AgrumeStly/yeye/control/firmware/README.md

# 旧目录：历史本机缓存

2026-10-25起，正式源码已按Core／App／Drivers_Custom／Drivers分层，Keil工程移至[MDK-ARM](../MDK-ARM/README.md)。当前入口查[主控README](../README.md)。

本目录保留原build、旧UART临时检查工程等本机历史产物，便于原测试记录继续溯源。它们不是当前可编辑源码或日常构建入口，不重新复制一份正式工程到这里。新输出在control/build/firmware。

这里的历史日志／备份没有被清理。迁移映射和验证见[ORG-02](../../project_planning/tasks/ORG-02.md)。
