AgrumeStly/yeye/hardware_preparation/wheel_mapping.md

# 当前轮位、编码器方向与安装变更

更新：2026-10-29（北京时间）。本轮由主控直接授权01更新全局及关联文档；硬件／02后续维护实物依据，00继续汇总协调。本页是**当前安装版本的轮侧／通道／方向入口**，不是新的MCU引脚表；GPIO及AF仍以[pin_plan.md](../control/docs/pin_plan.md)、[wiring.md](wiring.md)为准。

## 2026-10-30：直行测试的驱动对应与前进极性

主控本轮要求双轮快速前进1秒、慢速前进1秒，并明确反馈：**“左轮（先转的）朝车头、右轮（后转的）朝车尾”**。结合此前MotorPwm人工测试先A后B的顺序，本次按当前接线采用以下关系；这是主控现场方向反馈与测试顺序对应，没有新增代理实物测量。

| 驱动桥 | 当前轮侧 | 原MotorPwm极性下的反馈 | 本次StraightTest前进输出 |
| --- | --- | --- | --- |
| MOTOR-A（先转） | 左／物理新A | 朝车头 | IN1 PE9 PWM、IN2 PE11低 |
| MOTOR-B（后转） | 右／物理新B | 朝车尾 | IN1 PE13低、IN2 PE14 PWM，反转原测试极性 |

该补充替代下方10月29日记录中“当前驱动插口与轮侧待对应、带动力前进极性全未确认”的部分；**编码器软件a/b对应与符号仍待核，原CPR参考及机械换位历史保留**。本次独立工程只按桥配置开环输出，不采用未核的编码器方向，不外推为两轮同时前进、直行、反向PWM及停车已经验收。

固件与详细检查见[StraightTest](../control/docs/straight_test.md)及[C-02E](../project_planning/tasks/C-02E.md)。主控随后反馈小车拐弯、右轮偏快，当前程序已按新要求改为3秒恒定前进并预留左右PWM修正变量；方向配置不变。新版首次须悬空核对双轮前进及3秒后撤驱动，再进行地面直行观察。本次生成与编译不等于已经下载或新版实车通过；全局进度由00读取任务后汇总。

## 2026-10-29已确认的机械变化

来源为主控本轮明确反馈，原始语义及检查边界归档于[换位记录](../testing/2026-10-29_wheel_swap/record.md)：

- 左右轮位置已互换：原右轮位于当前左侧，原左轮位于当前右侧。
- 原右轮的旧“前进旋转方向”，在当前左侧对应车辆后退；当前左轮前进应取其相反方向。
- 原左轮的旧“前进旋转方向”，在当前右侧对应车辆后退；当前右轮前进应取其相反方向。
- 因此不能只改“左／右”名称继续沿用原通道方向系数；10月25日安装的轮侧／方向组合只保留为历史。

主控进一步明确：**“左轮为A右轮为B是我现在规定的。”** 因而本页从本次起使用**物理新A＝当前左轮、物理新B＝当前右轮**。这是主控重新命名，不是对驱动板插口或Keil变量的确认；不需要主控回忆旧插口，实际新安装的对应关系留给后续核对。

必须区分三种编号：

1. **物理新A／新B**：本轮主控定义，分别是当前左／右轮。
2. **驱动板MOTOR-A／MOTOR-B**：固定插口丝印，不随物理轮重新命名自动改变；AIN／BIN仍按驱动桥定义。
3. **软件a／b**：EncoderBench固定资源名，分别TIM3 PC6/PC7与TIM4 PB6/PB7。不能因为新左轮叫A就认定它必然读取软件a。

## 当前可用信息与采用门槛

| 项目 | 当前记录／边界 |
| --- | --- |
| 当前左轮／物理新A来源 | 原右轮总成；其旧前进方向现为后退，来自主控明确反馈 |
| 当前右轮／物理新B来源 | 原左轮总成；其旧前进方向现为后退，来自主控明确反馈 |
| 软件a与b的定义 | a始终是TIM3 PC6/PC7；b始终是TIM4 PB6/PB7。本轮未修改源码／引脚；各通道当前接哪只轮尚待插口确认 |
| 当前编码器前进系数 | 若各轮组编码器AB相序未改，由旧前进变新后退可推导新A前进正／暂定+1、新B前进负／暂定−1。**这是基于旧标定与安装关系的推导，未取得10月29日原始读数，不视为新安装实测**；实际软件通道对应后再确认，不把它直接写入固件 |
| 每输出轮圈计数CPR | 按原轮组身份转移：新A／当前左轮继承原右轮1058.6，新B／当前右轮继承原左轮1060.8 counts/圈。仍是10月25日手转5圈估计，不是10月29日重新测量；不作为固定软件a/b的固有参数 |
| 电机输出的前进极性 | 仍未完成带动力校准；不能用编码器符号或机械转向描述代替AIN/BIN电气前进极性实测 |
| 已有成功证据 | 原MotorPwm A/B分别起转／自动停转、EncoderBench采集与原安装手转证据保留；不据此宣称新安装的左右／电气极性／闭环已验收 |
| 当前固件与下载 | 本次不修改、不构建、不下载；原始a/b仍是硬件通道名，不随机械位置自动改名 |

当前安装表如下；参数只在本页维护，其他入口不复制一套表：

| 主控新物理名称 | 当前轮侧 | 换位前轮组身份 | 跟随原轮组的CPR参考 | 前进反馈推导（AB相序不变前提） | 当前驱动插口／软件通道 |
| --- | --- | --- | --- | --- | --- |
| 新A | 左 | 10月25日原右轮，历史软件b | 1058.6 counts/圈 | 原前进变现后退，故当前前进相反；暂定原始正／系数+1，待新安装读数对应 | MOTOR-A或MOTOR-B、软件a或b均待现场对应，**不因名称A写死** |
| 新B | 右 | 10月25日原左轮，历史软件a | 1060.8 counts/圈 | 同理暂定原始负／系数−1，待新安装读数对应 | 同上，**不因名称B写死** |

若六芯线仍接原插口且各相线未改，软件通道将随原轮组移动；若插口也互换，则软件通道按实际新接线变化。主控已说明旧接法不记得，因此不再据回忆猜配置。后续只须面向**当前安装**记录：单独手转新A时哪个软件通道变化、单独手转新B时哪个变化，再登记实际驱动插口；无须为命名澄清重做每侧5圈。

## 与后续任务的关系

[C-02C](../project_planning/tasks/C-02C.md)的10月25日标定原图与原始JSON保留当时安装含义，不回改历史数值。[C-02D](../project_planning/tasks/C-02D.md)尚未实施，本次只修订其安装输入：使用本页当前映射，分别保存物理新A/B、软件a/b与驱动插口的对应、反馈方向系数、轮组CPR和电机电气极性，避免多处重复取反。当前通道配对未确认前可准备接口和电脑模型，但相关实车配置留待确认，不放行新的有动力闭环；本次文档授权不等于C-02D已获实施或烧录授权。

不为本次文档变更重新要求重复多圈手转，也不把它当成新的台架试验授权。需要实物接续时沿用C-02D原有人工触发、输出和时长限制及看门狗／停止保护；后续具体校准由对应任务明确安排。

## 比赛依据、收益与检查范围

已读取[比赛原文PDF](../competition/比赛文档.pdf)第2—4页的相关要求及评分表，并查看[图1赛道](../competition/assets/track_figure_1.jpg)：要求自动顺时针完成环形车道一圈、总时长不超过5分钟，触碰黑色边界扣基础分、完全脱离车道失败；基础功能满分60分。转写入口为[比赛文档.md](../competition/比赛文档.md)，冲突时仍以PDF为准。

本次文档修订支撑上述完赛和用时目标：避免把旧左右轮和反馈符号带入差速／闭环，降低错误转向、触线、出界及反馈方向错误的风险。没有直接加分承诺或实测得分变化。队内文档检查指标是：当前入口不再无条件引用过期安装表，任务Prompt指向同一映射源，MCU针脚及固件文件保持原字节，历史原图／JSON不被改写；实际新安装行驶表现另行验证。
