AgrumeStly/yeye/docs/hardware.md

# 硬件型号、接线与版本入口

2026-10-29安装变更：主控已换左右轮并重新命名物理A左／B右，旧前进转向在新位置成为后退；当前资源到物理轮的对应及参数沿用统一见[当前轮位](../hardware_preparation/wheel_mapping.md)。新物理A/B不等同驱动插口MOTOR-A/B或编码器软件a/b；原始软件通道不随命名自动改动，当前实际配对待核。本次不改固件／引脚，不把旧安装的手转或桥级转停证据外推为新安装动力通过。

日期：2026-10-25（北京时间）。硬件提供资料，主控／02接收，01复核MCU资源。

| 内容 | 唯一维护入口 |
| --- | --- |
| 已确认器件型号、接线与供电 | [wiring.md](../hardware_preparation/wiring.md) |
| 当前现场操作及历史方案适用范围 | [硬件README](../hardware_preparation/README.md) |
| 照片、厂商资料和来源哈希 | [I-03证据](../hardware_preparation/evidence/2026-10-18_i03/README.md) |
| 实际电压与故障反馈 | [I-05记录](../testing/2026-10-21_motor_bench/i05_measurement_results.md)及关联测试 |
| 首次主板验证 | [board_self_test_record.md](../hardware_preparation/board_self_test_record.md) |
| 原采购型号／预算／分工 | 硬件目录PDF与source生成源；属于采购历史 |

实物清点表尚待硬件建立；主控已确认按既定清单采购，不因缺清点表将已知型号改成未知。型号、到货、接线确认、导通测量与运行通过分别记录。

ORG-02迁移当时没有改变硬件版本、接线、供电或UC2停用状态；2026-10-29左右轮安装变化及新物理命名以页首链接为准。本次未新增上电／试转结果，UC2停用状态不变。
