AgrumeStly/yeye/hardware_preparation/chassis_record.md

# 单层铝合金底板采购与装配依据

记录日期：2026-10-26（北京时间）。维护：硬件提供实物资料、02记录装配证据、00汇总状态。
依据：主控本轮明确反馈“已下单单层铝合金板，数据资料都在硬件准备中”。本页记录采购变化，不代替到货、尺寸或装车验收。

## 已确认与资料边界

- 当前底板选择：单层铝合金板，已下单；实际下单时刻、厚度、合金牌号、订单数量、到货日期和实重未从现有资料确认，不影响先准备布局。2026-10-26是反馈记录日期。
- 原采购方案中的FR4底板为历史方案；不再直接沿用其180×110 mm尺寸及原安装坐标。原采购PDF与生成源保留历史，不覆盖重生成。
- 主控提供的资料位于[size/](size/)。文件名虽写“亚克力”，实际订购材质按主控确认记为铝合金；现有文件不能独立证明卖家实际供货材质、厚度或铝板孔位与图纸完全一致。

| 来源 | 本轮读取与可用信息 |
| --- | --- |
| [孔位布局介绍](size/1-亚克力底板孔位布局介绍.pdf) | 12页，已渲染总览查看；包括四角电机支架孔、板卡孔、通用槽、加高支撑、电池扎带、万向轮等孔位。通用标注不等于现有板卡、支架适配通过 |
| [底板尺寸图](size/2-亚克力底板尺寸图.PDF) | 1页，已渲染查看；平面外形标注195×128 mm，孔径标注Φ3.50 mm，含多组安装孔与长槽；没有据此确认板厚 |
| [底板孔位介绍](size/3-亚克力底板孔位介绍.PDF) | 1页，已渲染查看；长度标194.79 mm、宽128 mm，与尺寸图195 mm的差异保留，实际板以实测为准；电机孔标支持370／520／TT／42步进电机支架，不据此推定MD310配套支架必然适配 |
| [万向轮固定孔照片](size/万向轮固定孔.png) | 已查看，标出4组可选万向轮固定位置及牛眼轮孔；选孔仍须结合现有万向轮孔距、支撑高度、驱动轮位置与转向间隙 |

图框重量数值不作为已购铝板实重，图中的板卡型号不作为本项目换板决定。

## 当前交接与待验项

02按[H-03](../project_planning/tasks/H-03.md)先准备布局和适配表；硬件负责实物比对、紧固与绝缘，视觉提供摄像头固定接口及视场需求，主控侧不接管视觉实现。电机与板卡继续沿用[接线基准](wiring.md)中已确认型号，成功接线及MotorPwm／EncoderBench不因换底板自行变更。

到货后记录：底板长宽厚与实重、支架孔距匹配、轮子与万向轮不干涉、电路板底部与金属板绝缘、线束不磨锐边或进入车轮、电池可靠固定、断电入口可接近、摄像头支架牢固。由硬件实际操作、02留证；当前均未验收。

比赛依据为[比赛要求和评分表](../competition/比赛文档.md)第三部分及其[赛道原图](../competition/assets/track_figure_1.jpg)：整车含突出件长≤300、宽≤200、高≤250 mm，总重含电池≤5 kg；底板尺寸不等于整车尺寸。轮子外侧、摄像头支架、插头和线束突出部分纳入包络测量，结合50 cm净宽与锐角弯检查转向占用。

本项支撑基本功能60分的完赛与用时表现，目标是减少松脱、干涉及触碰边界导致的扣分／失败风险；不能预测更换材质本身加分。验证证据应包括装配尺寸、称重、固定与绝缘检查照片，以及后续低速转弯／跑圈记录。装配检查属于队内验收，不代替官方评分。

## 本轮实际检查

00读取3份PDF共14页（12页孔位介绍查看渲染总览，两张尺寸／孔位总图单页查看）、1张万向轮照片和比赛赛道图；文字提取用于辅助核对，文件名和图中材料不能代替主控采购确认。未测量实物、重新设计加工、操作板卡或上传远端。
