AgrumeStly/yeye/hardware_preparation/charger_replacement.md

# UC2替代充电器建议

日期：2026-10-21。主控明确“不用UC2了”，停止将UC2作为后续充电方案；此前本体特别烫的具体原因未测定，不宣称已经确认器件损坏。当前为00选型建议，未采购、未到货、未验收，不自动下单。

## 电池依据与推荐

沿用已确认采购清单中的2S、7.4V、800mAh普通LiPo，主插头XT30，平衡插头JST-XH 3P。原采购内容源为[source/generate_purchase_list.py](source/generate_purchase_list.py)，不改写历史采购PDF／生成器以伪造已购替代品。

建议一款：天空创新SkyRC S65，型号SK-100152。官网列明AC100–240V直接输入、LiPo2–4S、充电电流0.1–6.0A可调、XT60输出接口、散热风扇及电池电压显示；这些参数适合本项目2S小容量电池。选择理由是可以设置较小电流、观察电池电压并直接接市电，不承诺机壳不发热或绝对安全。国内库存、成交价及具体店铺本次未核验，不编造价格。

官方依据（2026-10-21查阅）：
- [SkyRC S65中文产品页](https://www2.skyrc.com/cn/s65?from=nav)
- [SkyRC S65英文参数页](https://www1.skyrc.com/s65?from=nav)
- [厂家提供的S65 V2.10说明书下载](https://www.skyrc.com/files/201/S65_Instruction_Manual_EN_V2.10.pdf)

## 配套与初始设置建议

购买S65与中国插座适用的交流电源线，并让商家配一根“S65输出接口到电池XT30”的成品主充电线；连接器公母按实际金属触点匹配及红正黑负核对，不单凭商品标题判断。不要求主控焊接或剪改电池线。现有JST-XH3P平衡线需接充电器2S平衡接口，长度不足再配适用延长线；平衡充电需主线与平衡线均正确连接。

针对既定800mAh电池，建议首次设置LiPo Balance／2S（标称7.4V）、0.5A、终止4.20V每节即8.40V整包；0.5A约0.625C，仍不得超过电池标签允许的充电电流。普通LiPo不使用LiHV／4.35V设置，不修改截止电压提高充入量。到货后结合对应版本说明书做实际按键与插口核对，本文件不是自动充电指令。

充电时电池从车辆断开、在不燃表面有人看管。仅推荐更换充电器，不把换新当作电机无动作的修复；[I-05电气定位](i05_motor_power_diagnosis_task.md)仍待硬件借万用表测电池／驱动输入。

可转给商家的配线说明：电池为普通LiPo2S／7.4V／800mAh，主插头XT30、平衡头JST-XH3P；需要正版SkyRC S65、中国插座适用电源线和S65到该XT30电池的成品主充电线，支持主线与2S平衡线同时连接充电。
## 预算收紧后的候选：ToolkitRC C4

2026-10-21主控认为S65偏贵，要求更便宜的方案。预算候选改为ToolkitRC C4；仍未确认购买。厂家明确支持AC100–240V直接输入、LiPo2–4S，电流0.5／1／2／4A四档，可选择0.5A给既定800mAh电池充电；以LED显示进度，不将其当作有单节电压数值显示的设备。普通LiPo选择4.20V每节，不选LiHV。

主输出为XT60，需要配与现有XT30电池匹配的成品主充电线，并正确接2S平衡线。整机需带国内插座适用交流电源线。建议以约120–150元作为国内整机选购预算参考，并另外核对配线费用；此范围是选购预算估计，不是已核验的实时到手报价。国内导购检索有约113–140元记录，但打开页面时价格／所列商品发生变化，故不把导购记录当作可成交报价，也不推荐其异常低价或仅配件SKU。厂家海外商店整机标价25.99–26.79美元，仅作原币参考，不换算为国内报价。没有核验卖家库存或真实性。

厂家依据：[C4中文参数页](https://www.toolkitrc.com/zh-hans/c4/)、[官方中文说明书](https://download.toolkitrc.com/wp-content/uploads/2024/09/C4-%E4%BD%BF%E7%94%A8%E6%89%8B%E5%86%8C-V1.0.pdf)、[厂家海外商店](https://www.toolkitrc.com/product-category/charger/)。

更便宜但固定／最低电流过大的型号不直接套用：UC2已停用；厂家已标e3停产且最大1.2A，C3未证实能由主控选择0.5A，不能仅因价格低就认定适合本次小容量电池。以上不是对器件质量的断言。I-05故障诊断范围不变，不自动上传或下单。
