AgrumeStly/yeye/hardware_preparation/i03_handoff.md

# I-03 返回00与01的交接

状态：v0.2，00已验收资料整理、归档主控采购型号确认；实物接线及引脚待签核。日期：2026-10-18（北京时间）。负责角色／对话：主控／02；验收回填：00。依据：主控I-03指令及[接线核对](wiring.md)。

2026-10-20续接：01已完成C-02A，00采用其资源并回填wiring v0.3。下文资源确认要求保留为历史交接；当前接法见[首次接线指南](dual_motor_wiring_guide.md)及[引脚方案](../control/docs/pin_plan.md)，不重复开工或沿用旧PA0/PA1候选。主控本次要求先断电接线、回报后再编码。

## 返回00的事实

- 已建立[逐线接线草案](wiring.md)，覆盖两只电机各6线、四路桥控制、四路编码器输入、共地、供电及UART/SWD保留条件。当前没有任何现装连线被实物验证通过。
- 照片P1可读YB-MNT03-V1.0，布局符合亚博AT8236 Standard；P2可读电机端M2/V/A/B/G/M1；官方接线图确认AO1→M1、AO2→M2、GND→G、3V3→V、E1B→B、E1A→A，B桥对应E2B/E2A。
- [照片及来源索引](evidence/2026-10-18_i03/README.md)保存原始照片副本、SHA256、原附件路径和厂家PDF。P3为天空星背面，不能据此确认MCU顶标；已插线束另一端不可见。
- 厂家芯片手册区分00滑行/休眠、11刹车；0/3.3V控制在资料门限内。编码器电平是预期值，未测量；驱动Vin标5–12V，5V/3V3是不同输出，Vout不能当5V入口使用。
- 型号已由主控确认按清单采购：MD310Z20_7.4V、AT8236 Standard／YB-MNT03-V1.0、天空星STM32F407VET6青春版。后续直接采用此基准，不再要求主控重复识别；照片未拍到铭牌不等于型号未知。
- 缺项归硬件：两端线束与导通表、左右轮对应、电池极性、供电拓扑与测量、下载器端口说明。01先查既定型号资料；仅当具体PCB版本差异影响连接时，补核对应位置，不把补齐全部器件照片作为资源设计前提。
- 未决项归01：四个桥输入的PWM/GPIO分配、编码器定时器保留、UART/SWD物理位置与冲突、停车模式及默认态；01完成后由硬件核实实际排针位置，02更新接线版本。
- 本次仅文件与照片核对；无改线、通断/电压测量、烧录、上电或电机运行。没有实车/台架测试通过结论。

00验收结论（2026-10-18）：I-03“照片与资料整理”验收通过；“实物接线冻结/可上电”继续待验收。C-02A资源分配可立即按既定型号开展，无需等待硬件导通或补拍铭牌；C-02实际驱动测试仍依赖H-02和01接口确认。

## 可由主控转交01的资源确认要求

```text
任务关联：I-03 → C-02前置资源确认
目标对话／角色：01 主控固件开发／主控
依据：hardware_preparation/wiring.md、hardware_preparation/i03_handoff.md、control/docs/pin_plan.md、control/Drivers_Custom/Board/board.h、control/Drivers_Custom/Board/board.c。

目标：确认F407驱动AT8236双桥及读取双AB相编码器所需的资源分配；本段是交接要求，不表示任务已自动发送或已开工。后续具体可改范围与授权由00给出执行Prompt。

要求：
1. AIN1/AIN2/BIN1/BIN2共4路3.3V控制线。优先评估4硬件PWM；若采用2PWM+2GPIO，解释两方向的PWM极性、占空比和停车状态，不直接照搬F103教程的PA6/PA7/PB0/PB1。
2. 双AB相编码器4输入。现PA0/PA1→TIM2 CH1/2、PB6/PB7→TIM4 CH1/2仍为候选；编码器计数定时器与PWM时基资源不得冲突。
3. 保留或明确处理USART2 PA2/PA3、SWD PA13/PA14和既有板级资源；驱动ADC不接PA2。U1R/U1T不能替代USART2或SWD。
4. 每线返回MCU端口、AF、TIM/CH、引出连接器及物理针号、板载占用。照片看不清的位置保持待核对，不猜针号。
5. 明确HSI 16MHz起点下的PWM时钟、频率、模式、限幅、复位/高阻默认态、STOP/FAULT滑行或刹车、换向顺序和台架超时退出。00/11是芯片滑行/刹车定义，不是车轮已停稳。
6. 与硬件明确驱动A/B桥和车辆左右轮的对应，提出编码器符号及前进方向的后续验证步骤。

返回证据：资源分配表、复用与板级依据、冲突处理、待硬件确认项、下一步代码/台架条件。最终引脚确认后由01更新pin_plan.md，02引用同一接线版本。
边界：本次I-03没有授权01自动上电、烧录或驱动电机；没有授权上传、切分支或跨聊天自动消息。
```

## 硬件复核返回格式

| 必填项 | 要求 |
| --- | --- |
| 器件身份 | 沿用主控确认的原采购型号；只记录具体替换、与清单不符或影响接线的PCB差异；线束及下载器信息按接口需要补齐 |
| 每根线 | 对照wiring.md线号，写两端接口/针脚、插头朝向、通断实测、核对角色和日期 |
| 供电 | 各正负端、共地、开关、Vout与Vin关系、USB和DAP隔离方案；本次不要求带电测量 |
| 差异 | 预期与实物差异、照片、影响范围、负责角色、改线后复查条件 |
| 后续测量 | 另行任务确认后，再补稳压输出、编码器高低电平、带载掉压等真实数值 |

## 后续测试前置与版本

先完成硬件断电核对和01资源签核；再按00明确任务逐级测供电/逻辑接口、悬空单轮/双轮转停、编码器和闭环。先测电气输出停止，再记录车轮实际停稳；断连恢复不能自动重启。记录进入testing/带日期目录。

开始版本：D:/Projects/yeye，main，82640aba4cf7aa4f30db14b486aef852936118fe；开始时工作区干净。I-03新增资料及状态更新为本地未提交改动，精确文件清单以02最终回报为准；本次未提交、推送、创建PR、切分支或向其它聊天发消息。
