AgrumeStly/yeye/hardware_preparation/motor_dc_check.md

# A电机独立直流起转检查

2026-10-24补充：主控暂时无法去实验室，当前可先用[MotorDirect固定GPIO短时试转](../control/docs/motor_direct.md)，原接线、无需PWM。该方法仍经过驱动板，失败不能独立判定电机损坏；本页的脱离驱动限流电源方法留待设备具备。

状态：v1.0，操作方案，未实测。日期：2026-10-24（北京时间）。主控／01整理；主控在实验室人员协助下操作，实际结果交主控／02归档。

主控本轮要求先用最简单、不用PWM的方法让电机起转。本轮采用**A电机完全脱离主控与驱动，使用实验室可调限流直流电源短时供电**的方法；无需改程序、编译、下载或使用示波器。实验室是否有合适电源尚未确认，本文件不代表已接电或起转通过。原示波器方案保留，待独立电机结果后再安排。

## 电源参数与依据

[亚博MD310官方资料的310 Motor段](https://www.yahboom.net/study/MD310/14018/)给出MD310Z20_7.4V额定／推荐7.4V、推荐供电范围4.2–8.4V、额定电流≤0.65A、堵转电流≤1.4A；不重新识别已确认的型号。堵转值不表示允许持续堵转。

本次工程诊断初值：**输出7.4V，电流限制先设1.0A，一次接通约0.5–1s后关输出**。限流值和时长是本次保守诊断选择，不是厂家起转保证或新的整车参数。若启动瞬间限流，记录实际情况；若持续CC限流、掉压且不转，立即关输出，不自行加电流或延长时间，不能因此单独判定电机坏。

该方法是额定直流供电，已不同于原30%PWM。**完全脱离主控后，KEY、固件500ms超时和看门狗均不能关断电机；停止只能靠电源OUTPUT开关。** 操作人员必须能立即关输出，本轮不采用手持裸线碰接锂电池来代替开关。若实验室没有可调限流电源／可靠夹具，先返回设备条件，不用主板GPIO或电源针临时代替。

## 操作：先全断电，后只接两个动力端

1. 驱动OFF、拔XT30电池、DAPLink USB及主板Type-C，UC2保持断开。固定A电机／车架，轮子悬空，导线远离转轴。
2. 标记原接线，将**A电机六芯线在驱动端的六根线全部拔开**，电机端插头保持接好。M1／M2辨认以电机PCB丝印及[已确认逐线功能表](motor_wiring_self_check.md)为准，不凭通用线色或“从上第几根”猜测。剩余编码器V、G、A、B四根分别绝缘、悬空，既不接电源，也不再接两块板。
3. 请实验室人员在电源**OUTPUT关闭**时设置7.4V、电流限制1.0A，核对显示单位及限流设置；接好合适的绝缘夹具，输出仍保持OFF。

   | 直流电源端 | 仅接A电机哪根线 |
   | --- | --- |
   | ＋ | M1，原来接驱动AO1的动力线 |
   | − | M2，原来接驱动AO2的动力线 |

   电源负端这里接M2，**不接编码器G**；7.4V不接编码器V。M1／M2也不接PE9、主板3V3／5V或驱动Vin。此处电机已独立，不需要额外与主板／驱动共地；不在驱动仍连着电机时外加这一路电源。
4. 一名现场人员负责OUTPUT按钮，另一人可观察／录像。只打开一次输出，约0.5–1s立即关闭；若完全不转、只抖动、持续CC／电压明显下跌或有异常，提前关闭。不靠手持带电线插拔启停，也不带电换极性。
5. 确认电源输出已关，再拆电源夹具；保持电池与主板供电断开。回报结果后再按原标记及接线表恢复，不顺手把两板接电重新试转。

## 结果与解释

主控回报：**是否转动／仅抖动／无动作；输出开启时实际电压、电流及CV／CC状态**，能录像则同时保留电机与电源显示。设定7.4V不等于带载输出已达到7.4V，限流1.0A也不等于实际流过1.0A。

- 能转：说明本次电机与这段线束能在受控直流条件下起转；原故障仍需在控制信号、驱动及供电组合中定位，不能直接据此判定固件或驱动哪一个坏。
- 不转且持续CC／掉压：可能受限流、机械负载或其他电气条件影响，先停；没有满足电压条件不能直接判电机坏。
- 电机端有额定附近电压但无动作：保存实际电压／电流，后续定点检查绕组、换向器、线束与机械；不自动加功率或反复堵转。

测试结果仍待主控提供。代理本轮只查厂家资料及准备说明，没有改固件、烧录、操作电源、电池或电机、上传或跨聊天发送。
