AgrumeStly/yeye/project_planning/project_status.md

# 当前状态与任务

最后核对：2026-10-29（北京时间，01按主控本轮明确授权更新左右轮换位／新物理命名及旧标定适用范围；其余进度保留00原记录）。
汇总：00项目总指挥。本次轮位变更由01依主控“更新全局文档”的明确授权顺序回填，不接替00身份；没有重新编译、操作板卡或确认新安装试转。10-25已核对控制模块及现场记录；10-26按主控反馈读取底板资料和比赛相关要求，登记新采购与装配依赖。00没有重新编译、烧录或试车。ORG-02构建／模型为原迁移证据，PWM重写与实物结果分别按模块记录核对。
维护方法见[协作标准](collaboration_standard.md)；整理前完整流水见[历史快照](archive/2026-10-25_project_status_snapshot.md)。

## 1. 当前判断与接续

主控工程、电脑模型、首次板级自检及两马达分别PWM起转／自动停转已有证据；C-02B-PWM-R4人工验收完成。编码器采集已实现，00已核对采用10月25日原安装的初版手转标定；10月29日主控已交换左右轮并重新规定物理A=左、B=右，旧左右／通道组合不再作为当前配置，见[当前轮位入口](../hardware_preparation/wheel_mapping.md)；速度闭环尚未实现，带动力电机极性、AB同时运行、串口实物互通及整车跑圈仍未验收。主控已确认视觉能采图、尚未发送结果包；正式程序尚未在本仓库归档，图像特征提取与语音能力未在本轮确认。原W1／W2目标不能按日期视为完成。

ORG-01已完成协作资料落地；主控随后明确授权ORG-02，将STM32物理分层放在control内，工程迁至MDK-ARM。协议、接线、原图与实物测试目录仍原位保留。现有00、01、02、03继续职责，清晰模块任务可直接进入01／02。当前完整接续见[ORG-02](tasks/ORG-02.md)，结构和统一入口见[docs](../docs/README.md)。

当前可复现基线为[MotorPwm独立工程](../control/MDK-ARM/motor_pwm.uvprojx)，目标MotorPwm，预期版本0x020B0004、1kHz／50%／500ms；A/B分步起转、自动停转和灯态已由主控确认。[C-02C](tasks/C-02C.md)已完成软件及初版手转标定交付；下一项为[C-02D统一双轮运动接口与低速闭环台架](tasks/C-02D.md)，任务已准备、尚未实现，保留已通过MotorPwm与EncoderBench。

### 最近的推进顺序

1. [C-02C](tasks/C-02C.md)原安装交付仍保留；10月29日已机械换位，主控新定义A=当前左、B=当前右，旧前进旋转方向现为对应新轮的后退。[wheel_mapping.md](../hardware_preparation/wheel_mapping.md)维护当前关系，物理新A/B不等同驱动MOTOR-A/B或软件a/b。C-02D须先按当前安装对应通道，再绑定随原轮组转移的CPR及前进系数；不重复旧多圈标定，不擅改固件。
2. C-02D先区分编码器符号与电机输出极性，准备受限单轮校准／低速闭环，再由02组织双轮并转、停止及供电回归。初次仍50%以内、500ms人工触发；只有实际台架证据回来才验收闭环，不把旧演示request直接当RPM／PWM。
3. 视觉同步按[V-01](tasks/V-01.md)交已有板上程序、实拍路径与串口样例；主控／视觉共同确认现有20字节协议，02组织固定包与START／STOP／失线／超时实物互通，再进入低速地面循迹。视觉与语音具体实现归视觉，硬件准备归硬件。

硬件可同步准备轮侧／前进方向标记、稳定悬空支架、线束固定与练习赛道；同一checkout的代码写入、Keil保存／构建与板卡动作顺序进行。以上为依赖顺序，未重新承诺原11/01跑圈期限。报名已由主控明确确认完成且有成功凭据，见[报名状态](../competition/registration_status.md)，不再列为待提交阻塞；原截止记录保留。

10-26新增：主控确认已下单单层铝合金底板，资料已在硬件准备目录；[采购与图纸记录](../hardware_preparation/chassis_record.md)区分订购材质、图纸尺寸与待实测项。02可按[H-03](tasks/H-03.md)准备布局，硬件后续负责适配、固定和绝缘；未确认到货、装车或整车尺寸通过。此项与01运动接口／闭环、视觉结果包并行准备，不改变已有控制验收结论。

10月29日安装变化已按主控反馈记录：新A是当前左轮、新B是当前右轮，仅为重新规定的物理名称；不能据名字认定实际MOTOR-A/B插口或软件a/b。原右轮旧前进方向现在是左轮后退，原左轮旧前进方向现在是右轮后退。CPR参考随原轮组转移，方向若按原AB相序推导须明确“未重新实测”，通道与实际极性后续核对；详见[当前唯一映射](../hardware_preparation/wheel_mapping.md)和[原始反馈记录](../testing/2026-10-29_wheel_swap/record.md)。本次避免把过期左右/符号用于差速及闭环，支撑比赛基本完赛、减少触线／出界风险，没有实测加分结论。

## 2. 当前模块摘要

| 范围 | 已有证据 | 验证边界与下一步 |
| --- | --- | --- |
| 型号与到货 | 主控10-18确认按清单采购、10-20确认硬件到齐；MD310Z20_7.4V、AT8236 Standard／YB-MNT03-V1.0、天空星F407VET6青春版沿用[接线基准](../hardware_preparation/wiring.md) | 型号已知，逐项电气验收仍需证据；不重复索要型号 |
| 底板与结构 | 主控10-26确认单层铝合金底板已下单；[底板记录](../hardware_preparation/chassis_record.md)已核对3份PDF及万向轮照片，图纸约195×128 mm | 新采购不在10-20原硬件到齐范围内；到货、厚度、支架孔距适配、整车包络／重量及绝缘固定待验；02按[H-03](tasks/H-03.md)准备布局 |
| 主控软件 | [主控入口](../control/README.md)、[ORG-02](tasks/ORG-02.md)有迁移构建／模型／二进制等价证据；随后[PWM重写](tasks/C-02B-PWM-R4.md)及独立MotorPwm编译／模型通过 | 当前分层与成功PWM复用；HardwareBench仍是UART／状态机框架，运动请求未接真实闭环；00本轮未重跑构建 |
| 板级自检与启动 | [首次双闪／读回](../hardware_preparation/board_self_test_record.md)；R1后主控回报绿灯恢复，[原现场记录](../testing/2026-10-20_motor_bench/acceptance_record.md)保留 | 原不闪症状已恢复；独立上电及完整ms／fault／stage读数未齐，不再当成尚无任何恢复证据 |
| 电机基础驱动 | [Direct A/B](../testing/2026-10-25_motor_direct/acceptance_record.md)及[MotorPwm A/B](../testing/2026-10-25_motor_pwm/acceptance_record.md)分别起转成功；主控本轮再次确认两马达能转，PWM自动停转与灯态已验收 | 现版1kHz／50%／500ms；未单独提供Watch版本／波形／精确计时；AB同时运行、反转与闭环另验；旧失败不改写 |
| 供电／接线／测量 | 既定DAPLink主板供电、2S驱动供电及九线沿用；[I-05](../testing/2026-10-21_motor_bench/i05_measurement_results.md)已有静态读数，现版A/B已起转 | 历史持续版读数原位保留；完整导通／内部VM／动态波形仍未全测，不再把旧无动作作为本轮开发阻塞。编码器供电与信号按C-02C实际核对 |
| 协议／UART | [20字节结果包](../control/docs/protocol_v1_draft.md)主控实现；UART默认关闭 | 协议仍草案，待主控／视觉共同确认及真实互通；语音动作反馈未实现 |
| 编码器与闭环 | [C-02C](tasks/C-02C.md)软件及10月25日原安装手转交付保留；10月29日已换位，新物理A左／B右，旧左右/通道参数不再直接套用 | [当前轮位／命名／参数沿用](../hardware_preparation/wheel_mapping.md)为现行入口；当前通道对应及推导方向仍待核，参数未写固件，C-02D先处理安装映射和电机极性，再进入低速闭环 |
| 视觉与语音 | 主控2026-10-25确认已经能采图、尚未发送结果包；实际脚本／环境／样本待归档 | 下一项[V-01](tasks/V-01.md)：复用采图，先固定协议包发送，再接真实特征；语音／路径提取进度未确认，不由主控接管实现 |
| 整车与报告 | [测试入口](../testing/README.md)已有下载、板内和台架诊断；[报告目录](../report/README.md)只有说明 | 尚无整车跑圈、故障停车验收和正式报告 |

UC2已按主控决定停用，替代充电器仅为[历史建议](../hardware_preparation/charger_replacement.md)，没有已购买／到货／实测证据。旧采购和接线教程里的UC2操作不作为当前操作入口。

## 3. 有效任务与依赖

表内状态表示该任务实际层次，不能用软件交付代替实物验收。历史任务详细要求沿用原文件，新跨轮任务按[tasks/README.md](tasks/README.md)建立。

| ID／既有名称 | 主责／对话 | 当前状态与差距 | 证据与下一步 |
| --- | --- | --- | --- |
| ORG-01 | 体系整理对话交付，00接收 | 待验收：文档体系本地落地，实际使用效果待主控反馈 | [任务与完整交接](tasks/ORG-01.md)；00读文件接续 |
| ORG-02 | 体系整理对话交付，01后续维护、00接收 | 待验收：主控物理分层、路径适配、构建／模型／固件等价检查完成；人工Keil体验待主控 | [迁移与当前完整交接](tasks/ORG-02.md)，以后打开control/MDK-ARM工程 |
| P-01 | 主控汇总／00；正式报名由正式队长 | 报名已由主控确认完成且有凭据；三方完整交付与重估排期继续跟踪 | [报名状态](../competition/registration_status.md)、本页节点与[原计划](project_plan.md)；凭据附件本轮未查看，不将其记为待报名 |
| H-01 | 硬件，00跟踪 | 待核实：实物清点表尚未建立 | 预期`hardware_preparation/hardware_inventory.md`，采购／保管／验收分别记录 |
| H-02 | 硬件提供、02接收、01复核资源 | 进行中：资料已有、完整实物签核待补 | [wiring.md](../hardware_preparation/wiring.md)，沿用现有型号 |
| H-03 | 02准备布局、硬件负责实物、视觉提供安装输入 | 未开始：单层铝合金底板已下单，00已核对资料并准备完整Prompt；未确认到货／装车 | [任务与完整Prompt](tasks/H-03.md)、[底板记录](../hardware_preparation/chassis_record.md)；先资料适配，再到货验证，不阻塞C-02D |
| C-01 | 主控／01 | 待核实：HardwareBench真实运行、复位后零请求 | 不能由DFU双闪或诊断目标替代 |
| V-01 | 视觉实现，00协调，02接收 | 已知能采图、尚未发结果包；本次归档／发送任务Prompt已更新，待主控转交 | [完整任务与Prompt](tasks/V-01.md)；先固定包验证串口，再接真实路径特征，不等待主控闭环 |
| I-01 | 主控／02，视觉共同确认 | 待核实：协议冻结与跨板固定包、START、STOP、无效／超时无归档验收 | 依赖H-02与视觉交付；[协议入口](../control/docs/protocol_v1_draft.md) |
| C-02／C-02B | 主控／01实现、02复测 | 进行中：A/B分步PWM转停与双编码器初版手转标定已交付；动力闭环与AB并转仍未验收 | [PWM](tasks/C-02B-PWM-R4.md)、[编码器](tasks/C-02C.md)；接续[C-02D](tasks/C-02D.md)运动接口／低速闭环 |
| C-02B-PWM-R4 | 主控／01实现，主控实物验收，00接收 | 完成：软件交付及A/B分步PWM起转、自动停转／灯态／收尾人工验收 | [任务](tasks/C-02B-PWM-R4.md)、[现场记录](../testing/2026-10-25_motor_pwm/acceptance_record.md)；不外推AB并转、反转、CPR或闭环 |
| C-02C | 主控／01实现，主控手转，00核对 | 完成：软件及10月25日原安装初版手转交付；10月29日轮组换位另记，不改写旧验收 | [任务与原采用记录](tasks/C-02C.md)、[旧实物记录](../testing/2026-10-25_encoder/acceptance_record.md)、[当前安装变更](../hardware_preparation/wheel_mapping.md)；旧数值按轮组身份继承，不认定新安装已实测 |
| C-02D | 01实现、主控人工台架、02联调 | 未开始：10月29日仅修订安装输入，未授权本轮启动实现；物理新A/B与驱动／软件通道须分别对应 | [修订后的任务与Prompt](tasks/C-02D.md)引用[当前轮位](../hardware_preparation/wheel_mapping.md)，不沿用旧左a/右b参数；原限幅／人工停止保护与唯一协议保留 |
| MotorDirect（原10-24任务名称） | 主控／01，主控手动验证 | 已取得A/B分别起转正常的主控反馈，A有约500ms自动停转；细项以原记录为准 | [Direct记录](../testing/2026-10-25_motor_direct/acceptance_record.md)；保留对照入口，不再作为当前未起转阻塞 |
| I-04 | 主控／硬件、02留证 | 进行中：接线已由主控确认、供电已有反馈；完整导通和运行签核未齐 | 不再把“待机不闪”列为当前未修复症状；[接线入口](../hardware_preparation/README.md) |
| I-05 | 02组织、硬件测量、01按证据修复 | 历史定位记录保留：已有静态电压与持续版数据；旧失败根因未单独确证，现版A/B已转，不再优先重复故障定位 | [测量记录](../testing/2026-10-21_motor_bench/i05_measurement_results.md)；编码器／后续并转若出现新供电异常再按证据补测 |
| G-02 | 主控／03 | 完成证据已取得；本轮只读核对本地合并，不代替主控体验验收；笔记本待确认 | [版本交接补记](version_handoff.md)；远端实时状态本轮未联网复核 |
| G-04 | 主控／03交付，00核对本地基线 | 已有上传正式版本及台式机接续记录；00本轮实查本地分支／HEAD／正式标签一致，未联网重核远端 | [G-04](tasks/G-04.md)；codex/current-version-20261025，HEAD及formal-2026-10-25均0b0343577895d8eb03a337165da6ce9c5e433519；本轮新文档仅本地 |

### 保留的历史交付

- I-03：资料整理已由00接受，真实线束／电气签核另属I-04；[交接](../hardware_preparation/i03_handoff.md)。
- C-02A：资源方案已采用并回填接线；[资源表](../control/docs/pin_plan.md)，实物冻结另验。
- C-02B-R1：软件修复及绿灯恢复有证据，完整自主启动复验未齐；[R1记录](../control/docs/motor_bench_startup_issue.md)。
- C-02B-R2：软件交付已接受，单次A无动作；[R2记录](../control/docs/motor_bench_r2_task.md)。
- C-02B-R3：软件交付已接受，已有板内活动／停止快照，外部起转未通过；[R3记录](../control/docs/motor_bench_r3_task.md)。
- 持续A测试：旧版有配对Watch和测量反馈，未转；[原说明](../control/docs/motor_continuous.md)与证据保留。现版A/B分步PWM成功不能单独确定旧失败根因。
- G-01：上传任务分支及00核对有证据；G-02随后合入本地main，[版本记录](version_handoff.md)。
- 原D-01～D-10问题、授权与现场流水完整保存在[状态快照](archive/2026-10-25_project_status_snapshot.md)，未删除历史失败或改写原测试日期。

## 4. 日期与当前风险

以下均为本地原通知／原计划记载，日期使用2026年北京时间，尚无本轮赛事群新通知；主控已确认报名完成且有凭据，本轮未查看原始附件。

| 节点 | 原日期 | 目前判断 |
| --- | --- | --- |
| W1基础链路 | 10/18 | 完整验收未齐 |
| 内部报名检查 | 10/23 | 10/25主控已确认报名完成并有凭据；不倒填10/23完成或正式队长身份 |
| 官方报名截止 | 10/25 23:59 | 主控已确认报名完成且有凭据，记录见[报名状态](../competition/registration_status.md)；本轮未查看附件 |
| W2闭环与通信 | 10/25 | 完整链路无验收证据 |
| 连续3次低速整圈 | 11/01 | 队内原目标，未归档试跑 |
| 候选版与报告终稿 | 11/29 | 原计划目标，需按真实进展重估 |
| 现场验收 | 暂定12/05 | 以正式后续通知为准 |

## 5. 待修订与维护

本轮新增组织改善、原技术缺陷、环境问题分别登记在[审查记录](organization_review.md)。优先关注旧技术页“待实测”与已有证据的衔接、接线教程供电口径、换设备调试模板；这些均没有在本轮被算作修复完成。

00收到新结果时更新关联摘要和任务行；现场详情写原测试记录或新增带日期记录。新增重大决定写入相应任务单并链接受影响规范。原计划没有重新承诺新工期，主控体验没有自动验收。
