AgrumeStly/yeye/project_planning/tasks/C-02D.md

# C-02D：统一双轮运动接口与低速闭环台架

2026-10-30专项接续：主控本轮已直接要求复用采集代码使两轮同速，独立实现及软件结果记录在[C-02F](C-02F.md)、[SpeedMatch](../../control/docs/speed_match.md)。已提供两次人工单轮500ms配对／符号识别及双轮默认3秒同目标PI调试，3秒沿用主控当前直行测试时长；未自动操作硬件。原采集、PWM及旧目标保留。C-02F不替代本任务的通用motion API、正式整合及实物验收要求，不能据专项软件完成宣称本任务整体完成；以下原任务日期与授权历史保留。

日期：2026-10-25（北京时间）。主状态：未开始；2026-10-29由01依主控授权修订安装输入，本轮不启动实现。01实现，主控人工操作，02接收台架与后续串口联调，硬件协助轮向和固定；视觉只维护自己的采图／路径发送及语音实现。生成Prompt不代表已发送或自动开工。

## 已确认事实和本次决定

主控要求下一步封装电机运动调用接口，已明确不是按钮界面。00此前核对的[C-02C](C-02C.md)及[实物记录](../../testing/2026-10-25_encoder/acceptance_record.md)属于10月25日原安装；**10月29日已交换左右轮，旧左右/软件通道组合不再直接作为本任务输入。** 主控新定义物理A=当前左、B=当前右，这不是驱动MOTOR-A/B或软件a/b的确认。当前映射及轮组CPR沿用统一查[wheel_mapping.md](../../hardware_preparation/wheel_mapping.md)：旧前进转向在新轮侧成为后退，CPR随原轮组转移，软件通道配对及新前进读数尚待核。方向推导不是实测，参数仍是旧手转5圈估计且未写入固件；不得套厂家CPR、平均左右或把名称直接写成通道。原交付不外推为新安装动力闭环通过。

既有MotorPwm的1kHz／50%／500ms、A/B分别起转与停转已获主控确认，独立EncoderBench为10ms采样、原始16位计数／64位累计及窗口状态。保持这两个可复现入口和此前全部目标。

重要缺口：手转确定的编码器方向，不等于PWM正输出的车辆前进方向。电机驱动输出的轮侧极性、带动力编码器符号、AB同时动作、PID增益与闭环表现未验。当前car_tick给出的left_request／right_request是演示归一化请求，board_apply_requests只更新Watch，不可直接当RPM或PWM接到新电机实现。

## 目标和Interface

建立一个非阻塞双轮运动Module，隐藏PWM、编码器符号／换算、控制周期、输出限幅和停止处理。第一版先提供STM32内部Interface，不新增一套视觉指令协议。建议Interface（目前尚未实现，01可按现有命名规范落地并记录真实声明）：

- 初始化／周期执行：motion_init及motion_tick，初始化零输出，周期不阻塞，单位与调用上下文明确。
- 目标：motion_set_wheel_rpm(left_rpm,right_rpm,now_ms)，接受左右轮目标RPM并返回是否接受及拒绝原因；不是占空比、距离或转角承诺。第一阶段用户运动目标仅前进与前进差速，不开放倒车／原地反向动作。
- 停止：motion_stop(reason)，立即撤去驱动、清目标与积分，保留实际反馈和停止原因；00滑行不等于机械瞬时停稳。
- 状态：motion_get_status，包含目标／实际RPM、输出、采样有效性、运行／停止／故障状态和原因。此为STM32内部读取，不代表现有UART已有状态回包。

具体函数类型、并发／时序约束、有限值检查、参数范围和错误语义写到真实头文件及模块说明，不散布到视觉调用者。避免为未来需求搭空模块或重复包装；运动流程、轮速控制和已存在硬件适配分别保有清晰职责。

## 实现和分阶段验收

1. 先读AGENTS、默认技能、协作标准、tasks/README、本任务、docs/architecture.md、docs/interfaces.md、control/README.md、standard_library.md、pin_plan.md、encoder_bench.md、motor_pwm.md和C-02C实际源及证据。保留SPL／CMSIS边界、HSI时钟、TIM5启动限时、IWDG、KEY及SWD，TIM1电机、TIM3／TIM4编码器资源不改。
2. 纯轮速控制数学放control/Algorithms/PID/或相应真实算法目录；硬件PWM／编码器适配放Drivers_Custom；运动状态、请求及保护放App/Motion；调度与入口放Core。优先新增独立MotionBench和工程，不把当前HardwareBench默认为可驱动车辆，不覆盖已验收诊断目标。
3. 先按当前wheel_mapping.md完成物理新A/B、驱动插口及软件a/b配对，再使用跟随原轮组的分别CPR和经确认的前进系数将反馈统一为正，不按旧a/b顺序直接套参数；按实际有效dt计算RPM；计数状态／flags异常时不得把无效值填0后继续积分。明确滤波／积分／导数的单位与延迟，提供输出限幅、积分限幅或抗饱和、停机清积分、故障锁定和启动拒绝条件。PID／PI选择给出理由，不能用“设置目标RPM”冒充已经达到该转速。
4. PWM初版沿用已通过的1kHz基线，新受控台架输出上限不超过50%。电机极性配置与编码器系数分开保存，不能用重复取反掩盖接错或方向错误。首次需短时逐轮校准输出极性：车辆前进时归一化反馈应为正。未标定前不启用双轮闭环，不自行写死A/B的电气正输出就是车辆前进。
5. 正负电气输出／换向的实现须查既定AT8236真值表；校准若确需改变电气方向，先停止、待停稳，受限单次人工触发，不直接切反向或删除保护。第一版外部速度目标仍拒绝负值并说明错误，不能静默取绝对值。
6. 新台架上电不动，KEY（实物丝印，对应WKUP）人工一次触发，初次有动力窗口沿用500ms并锁定，故障／KEY可立即撤驱动。控制实现非阻塞，不能用delay等待转动或把0.5秒窗口延长到几秒来方便观察。闭环调参若确需更长窗口，先记录当前反馈／输出及不足，由主控明确采用后另记录变更，不自动延长。
7. 初始只逐轮验证符号与短时反馈，再决定低速目标及PI/PID增益。未知增益、静态误差和调参结果都如实标待验；仅完成软件／模型不能宣称闭环稳定。AB并转与停止要在两轮各自方向／反馈正常后由02安排；本轮不直接地面试车。
8. 必须有指令有效期／更新超时、编码器无效或断反馈、异常dt／控制任务停滞及非正常请求的停止策略；值、依据和检测局限明确记录。外层car协议200ms失联／STOP优先／有效路径START条件原样保留，不因封装改变；本次不把它们与新的台架超时混成同一个测试结论。已锁定故障不能靠后续正常请求自动续跑。
9. 编写详细中文注释，完成受影响构建与真实逻辑测试：目标／实际量纲、符号、限幅、积分饱和、停止、故障、超时、dt／回绕及不会上电自启；模型与实际台架分开。保持MotorPwm与EncoderBench源码和行为；若确需共享代码提取，须证明原行为保留并回归，不将新闭环算法塞入旧诊断。

## 视觉怎样调用与接入门槛

视觉在K230D上，不能直接调用STM32的C函数。继续使用唯一[20字节协议](../../control/docs/protocol_v1_draft.md)：视觉侧封装send_path(...)、start()、stop()等发送函数；STM32接收／状态机决定是否启动，再调用运动Module。START依赖新鲜有效路径，不会因多包装一层就免除；现有STATUS仅解析，没有回包，不能承诺视觉可获取motion_get_status结果。

本次01先完成本地运动模块和独立台架，给出car到运动目标的后续映射方案，不直接改旧演示request的单位或冻结新的转向算法，也不新增FORWARD／LEFT／RIGHT命令号。V-01由视觉实现发送器；02在闭环台架准备充分且协议共同确认后组织无动力固定包联调，再受控接通真实运动。若需要新增轮速指令／反馈，先回00确认协议范围，不修改既有字段含义。

## 交付、位置和授权

- 实际头文件／实现、独立工程、control/docs/motion_control.md，更新真实API索引及模块说明。
- testing/2026-10-25_motion/的电脑证据及待填现场记录；纯Keil5＋已确认DAPLink步骤、最少Watch、先校准后单轮／双轮的门槛，退出／停止方法。
- 本任务回写：文件、版本、构建／测试／产物、已用初版参数、尚未确定的极性与增益、实际台架结果、未完成项及一个下一步；全局摘要由00顺序汇总。

当前00目录D:/Projects/yeye，分支codex/current-version-20261025，HEAD 0b0343577895d8eb03a337165da6ce9c5e433519。C-02C与00文档均有本地未提交内容，只有该HEAD／正式标签不能获取新编码器代码；必须保留并使用已有C-02C文件，另一设备缺源码先形成完整文件交接，不从旧基线重造或擅自上传。

00本轮仅准备任务；主控转交01后允许按以上范围本地实现、保存和适用检查、准备人工步骤，不授权代理自动烧录／接电／驱动车辆／跨聊天／提交上传／切分支。同一checkout的写入、Keil保存／构建和硬件操作顺序进行。01不争写全局project_status.md。

## 可直接转交01的完整Prompt

本对话继续01主控固件开发，执行C-02D：统一双轮运动接口与低速闭环台架。先读取AGENTS、默认技能、协作标准、任务模板、project_planning/tasks/C-02D.md、架构／API索引、主控README、standard_library、pin_plan、MotorPwm与EncoderBench及C-02C证据。

当前目录D:/Projects/yeye，分支codex/current-version-20261025，基线HEAD 0b0343577895d8eb03a337165da6ce9c5e433519；C-02C和00文档有未提交成果，另一设备仅取该HEAD没有新代码，先核对来源并保留共享修改。不要回到旧firmware工程或切分支。

10月29日当前安装已变化：主控交换左右轮，并重新规定物理A=当前左、物理B=当前右；原右轮旧前进方向现为左轮后退，原左轮旧前进方向现为右轮后退。**旧C-02C的“左a/右b”不能直接作为当前配置；物理新A/B、驱动MOTOR-A/B、软件a/b三种编号必须区分。** 先读hardware_preparation/wheel_mapping.md，按当前实际通道配对绑定随原轮组转移的CPR及经确认前进符号；推导值不冒充新实测，配对未确认不放行有动力闭环。不要求回忆旧插口或重做多圈CPR。MotorPwm A/B 1kHz／50%／500ms原桥级转停证据保留，SPL、启动限时／IWDG和KEY停止不改；新安装的电机电气前进极性另验。

建立非阻塞运动Module，提供初始化／周期执行、左右目标RPM、停止和状态／反馈Interface；具体命名可用motion_init、motion_tick、motion_set_wheel_rpm、motion_stop、motion_get_status。Algorithms放纯轮速PI/PID，Drivers_Custom放硬件适配，App/Motion放请求与保护，Core与MDK-ARM提供独立MotionBench。真实dt／CPR／符号、输出和积分限幅、异常反馈／超时停止、故障锁定与停机清积分必须明确。第一版目标只前进差速，负目标拒绝；不承诺距离或转角动作。

电机输出极性不能由手转编码器符号推定，先准备逐轮短时校准再闭环。首次台架KEY人工触发，窗口仍500ms、输出不超过50%，不自动延长／爬升或运行双轮；未知极性和增益如实留待人工确认。两轮各自正常后再给02双轮并转／停止验收步骤；不直接地面运行。保留已通过MotorPwm、EncoderBench和其它目标。

视觉继续走唯一20字节协议，其send_path/start/stop发送函数归视觉。保留START有效路径条件、STOP优先及200ms超时；不要把car.c演示request当RPM/PWM接通，也不新增另一套前进／转向字节命令。本次先台架和内部Interface，真实UART接运动待02分阶段联调，STATUS回包尚未实现不能伪称支持。

交付实际源码／独立工程、motion_control.md、纯Keil教程、最少Watch和待填实物表，完成受影响构建及有意义的符号、单位、限幅／积分、故障、超时和启动／停止检查。软件与实物分开，结果回写同一C-02D及模块证据，00汇总全局。只本地保存验证，不自动操作板卡／驱动／发送聊天／提交上传或切分支。
## 2026-10-29输入修订及本次授权

主控本轮只授权01更新全局与关联文档；这不表示已转交或开始C-02D实现。当前安装以[wheel_mapping.md](../../hardware_preparation/wheel_mapping.md)为唯一来源，旧标定原图／JSON保留，任务Prompt中的安装输入同步修订。软件、Keil项目／配置、PID参数、电机输出和设备均未操作。后续实施须按当前安装重新核对实际通道与前进电气极性，不能通过重复取反掩盖配对问题。规则及预期收益／检查指标见映射页，本次不虚构得分或新试转通过。
