AgrumeStly/yeye/project_planning/tasks/C-02F.md

# C-02F：复用编码器的双轮同速调试程序

日期：2026-10-30（北京时间）。主状态：待验收（软件交付完成，实车未验）。责任：主控／01实现与记录，主控人工操作，02接收现场证据，00汇总全局。

## 需求、已知事实和授权

主控先反馈右轮偏快，要求3秒直行及偏移调参；随后说明反复拔插DAPLink很麻烦，询问实时测速方案，本轮明确要求“复用之前的采集代码，写一个程序调好两轮速度，最终目标是两轮速度一样”。中断后主控要求继续同一任务。

沿用当前驱动A左／B右及前进极性；保留主控已将旧StraightTest修正值改为12的源码，不回改。编码器软件a/b与当前轮侧仍未取得新原始对应，不能套用旧安装顺序。当前轮组CPR继承值、方向及历史范围以[轮位入口](../../hardware_preparation/wheel_mapping.md)为准。

本轮实现独立SpeedMatch：逐轮500ms／≤50%人工校准反馈通道与符号，再允许双轮跟踪共同RPM；默认共同目标60、单次3秒，延续主控本轮直行调试时长，未延长逐轮首次校准500ms。正常结束后等待停稳及重新长按松开可重复，故障不自动续跑。此为C-02D中的轮速闭环专项，不表示通用motion API、整车循迹或UART整合已完成。

授权限于本地实现、适用检查、构建和操作说明。未自动烧录、接电、运行电机、提交、上传或跨聊天发送。实车“调好”仍依赖主控返回新实测数据；没有把默认PI或电脑模型当实物标定。

## 比赛对应与验收

已读取比赛第三部分相关要求、赛道及评分表。基本功能60分要求自动顺时针一圈、5分钟以内，触边扣分、完全出界失败。轮速反馈与独立闭环用于减少动力差导致的跑偏，支撑完赛率、少触边及合理提速；没有官方“同速加分”或实测分数承诺。

软件验收：原采集代码复用；识别映射后才能双轮；RPM真实dt与分别CPR；PI各自调节、0..50%限幅和积分抗饱和；KEY／异常／无反馈／反向／超速／采样失效停车；正常重复需人工，启动锁定配置和时限；Watch实时值及停车结果保留。软件与实物验收分开。

实物初验（队内指标，非官方规则）：两轮各自目标误差与两轮差值均≤5RPM、连续至少500ms，正常撤驱动；逐轮转向、通道／符号、左右PWM与供电状态须留证。原CPR为历史手转参考，有误差；同RPM不保证轮径相同或地面一定走直，地面表现另验。

## 本地交付及证据

- [SpeedMatch独立工程](../../control/MDK-ARM/speed_match.uvprojx)，版本`0x020F0001`；Core入口`speed_match_main.c`。
- `control/Algorithms/Speed/speed_pi.c/h`为纯PI数学；`control/App/Motion/speed_match.c/h`负责逐轮校准、请求、状态与安全；原`encoder_hw`、`encoder_counter`和`straight_pwm`适配文件复用且本轮不改。
- [模块说明](../../control/docs/speed_match.md)集中记录参数、单位、时序、停止语义、故障表、Keil Watch、重复调参及待实测要求。本机uvoptx沿用CMSIS-DAP／SWD／1MHz，预填Watch和周期刷新，受Git忽略；换电脑须核对实际设置。
- ARMCC5.06u5零错误零警告，Code9272／RO424／RW132／ZI1252；BIN SHA-256 `e247d769752ca35d3c269aab4243d06433a769df045426573cbab29ca1dc54a7`。构建工具及日志位置见模块说明。
- 真实PI＋原计数算法＋状态机模型通过两种映射、动力不一致、回绕、限幅与积分、校准、500ms／3秒边界、正常重复、参数锁定、结果保留及故障场景。虚拟电机2.5秒时62.83／63.94RPM属于模型结果，不能写成实车测速。
- 全调用链集成模型3场景110项通过，覆盖真实Core、PWM、encoder_hw、数学和控制；核对逐轮／双轮GPIO与CCR、3秒撤驱动、KEY、读失败和MOE丢失。没有真实电压、波形、机械转速或运动验收。
- 原StraightTest、EncoderBench、MotorPwm和六目标工程保留。未声称重新构建所有旧目标，未改既有协议及HardwareBench运动请求单位。

## 下一步与接续

主控按模块说明下载SpeedMatch，先悬空两次独立长按松KEY，确认左右轮分别朝车头且各500ms撤驱动；第三次双轮3秒后读取左右RPM、difference、last_matched_ms、PWM、error及录像。若有偏差，以该实测返回继续调PI或检查反馈／负载；默认增益不作实车稳定性保证。正常重复测试可保持DAPLink连接，复位会重新校准并恢复配置初值。

目录`D:/projects/projectsyeye`，来源HEAD `9520eeb481169f88146afe541b4d53617c7728eb`，分支`codex/current-version-20261025`。本轮开始已有C-02E固件／文档、新板记录及`control/docs/validation.md`、`testing/README.md`等共享修改，全部保留；本轮没有接替00或改写全局`project_status.md`。00可读取本任务和模块证据后顺序汇总。
