AgrumeStly/yeye/project_planning/tasks/G-06.md

# G-06：当前全部项目成果上传与台式机接续

日期：2026-10-31（北京时间）。负责范围：主控授权的版本同步与设备交接。
依据：主控要求“将所有内容更新github，方便台式上拉取”。

## 来源与本次授权

实际检查设备`JokeBearDesktop`，目录`D:/projects/projectsyeye`，分支`codex/current-version-20261025`，开始HEAD为`9520eeb481169f88146afe541b4d53617c7728eb`。`git fetch origin`成功，随后核对本地与同名远端领先0、落后0。origin为`https://github.com/AgrumeStly/yeye.git`。

提交并上传全部当前非忽略项目成果：C-02E直行测试、C-02F轮速闭环、纯PI算法、驱动适配、独立Keil工程、电脑测试与构建工具、新主板烧录／电机复测记录，以及已有模块、映射、接口和任务文档改动。保存原有内容，不改业务逻辑；补充本任务与版本交接入口。

本次沿用现有任务分支，不合并main、不移动正式标签、不发布、不操作目标电脑或板卡。编译输出、tmp、本机uvoptx／uvguix／DebugConfig沿用忽略规则留在本地；账号与工具安装不会通过Git同步。

## 验证与证据边界

- 2026-10-31实际重跑`control/tools/run_straight_tests.ps1`：状态机测试通过；集成模型7场景90项检查通过。
- 同日实际重跑`control/tools/run_speed_match_tests.ps1`：真实PI、编码器与状态机模型通过；全调用链集成模型3场景110项检查通过。模型映射0／1的62.83／63.94 RPM仅为电脑模型数据。
- 原固件构建及实物证据分别见[C-02E](C-02E.md)、[C-02F](C-02F.md)和[新板记录](../../testing/2026-10-30_new_board_flash/record.md)。本轮未重新构建ARM固件或验证实物，电脑模型通过不代表实车直行、闭环或整圈通过。
- 测试日志位于被忽略的`control/build/straight_test_tests.log`、`straight_integration_tests.log`、`speed_match_tests.log`、`speed_match_integration_tests.log`。测试脚本和用例随本次源码提交，台式机可重新运行。
- 提交前检查暂存文件清单、差异格式及常见凭据模式，提交后推送并以`git ls-remote`对照完整HEAD；实际结果以本轮最终回报为准，不为在文件中写入自身提交号重复提交。
- 36份暂存文件未匹配所查常见凭据模式。仅清理`straight_test.c`一处空白行尾空格，未改参数或逻辑；新板两份原始Keil日志自带的行尾空格按证据原字节保留，排除这两份日志后的暂存差异格式检查通过。

本次支持比赛第三部分基本功能60分项的开发连续性，避免台式机漏拿代码或误用旧轮位，降低后续完赛／触线风险；没有新增实测比赛分数。比赛规则以[原PDF](../../competition/比赛文档.pdf)和[全文转写](../../competition/比赛文档.md)为准。

## 台式机接续

主控在台式机实际仓库目录执行，历史目录为`D:/Projects/yeye`。先检查目录、远端与工作区；已有未提交修改先保存，不覆盖：

```powershell
git remote -v
git status --short --branch
git fetch origin
git switch codex/current-version-20261025
git pull --ff-only origin codex/current-version-20261025
git rev-parse HEAD
git status --short --branch
```

HEAD须与本轮最终回报相同；如果不能快进，保留现场核对本地独有提交。不直接拉取旧main。若尚无本地同名分支，用`git switch --track -c codex/current-version-20261025 origin/codex/current-version-20261025`代替switch／pull。

接续先读[主控入口](../../control/README.md)、[当前轮位](../../hardware_preparation/wheel_mapping.md)、C-02E／C-02F及对应模块说明。SpeedMatch工程为`control/MDK-ARM/speed_match.uvprojx`，StraightTest工程为`control/MDK-ARM/straight_test.uvprojx`。本机调试设置受忽略，台式机须按[SpeedMatch操作说明](../../control/docs/speed_match.md)核对Keil5、ARMCC5、芯片包、CMSIS-DAP／SWD／1MHz、Flash算法与Watch变量；拉取成功不能证明下载器或板卡配置一致。

台式机实际拉取结果本轮尚未核验。全局进展由00读取模块任务与原始证据后顺序更新。
