AgrumeStly/yeye/project_planning/tasks/C-02C.md

# C-02C：双编码器采集与轮侧、计数方向标定

日期：2026-10-25（北京时间）。主状态：完成（软件与初版手转标定交付经00核对采用；动力闭环／计量精度不在本次通过范围）；主控已在01转交并授权本地实现和验证。主控／01实现；硬件协助编码器供电、轮侧与机械标记；02接收现场记录；00汇总验收。代理不操作板卡。

> 2026-10-29安装变更：本任务10月25日标定及00采用记录属于**原安装历史**。主控已换左右轮并重新规定物理A左／B右，当前通道／方向／CPR沿用查[wheel_mapping.md](../../hardware_preparation/wheel_mapping.md)；不改写本任务旧图与原始JSON，不把原“左a、右b”照搬为当前配置。

## 已确认事实与待实测

- 主控在本轮00再次确认“马达都能转了”。[C-02B-PWM-R4](C-02B-PWM-R4.md)及[2026-10-25现场记录](../../testing/2026-10-25_motor_pwm/acceptance_record.md)已有主控对A/B分别PWM起转、自动停转、阶段灯态与收尾的完整流程确认；无需重复证明已认可部分。
- 当前可复现基线：control/MDK-ARM/motor_pwm.uvprojx，MotorPwm，预期revision 0x020B0004，1kHz／50%／500ms。旧R3、持续A无动作保留为各自历史，旧根因未单独定位，不再阻塞本次编码器开发。
- 仍未实测：AB同时动作、正反向／左右轮对应、编码器脉冲与每输出轴圈计数、速度闭环、串口实物互通、地面跑圈。视觉正式程序未在本仓库归档，不等于视觉尚未开发。
- 已有硬件：天空星STM32F407VET6青春版、AT8236 Standard／YB-MNT03-V1.0、MD310Z20_7.4V双电机；沿用既定九线及DAPLink单源主板供电、独立2S供驱动。UC2已停用，不把充电器选型作为本任务前置。
- 资源已经确定：E1A/E1B→PC6/PC7、TIM3 CH1/CH2、AF2；E2A/E2B→PB6/PB7、TIM4 CH1/CH2、AF2。TIM1保留电机，TIM5保留已有启动限时等待，PA0留KEY（对应WKUP），USART2 PA2/PA3与SWD保留。A/B桥不是已知左右轮，实际对应待现场登记。

## 目标、修改范围及交付

先建立可靠的双编码器计数与标定入口，不直接加入PID或循迹。

1. 读取AGENTS、默认技能、协作标准、状态、本任务、docs/architecture.md、control/README.md、control/docs/standard_library.md、pin_plan.md、motor_pwm.md及既有按键／初始化保护实现。
2. 在control/Drivers_Custom/Encoder/新增双AB相编码器适配，使用现有SPL TIM3／TIM4编码器模式；说明解码倍频、输入滤波、上拉／下拉依据和计数位宽。不得直接把“13线×减速比×4”写成已测轮侧CPR。
3. 采样采用明确的固定周期调度（优先10ms，实际实现须注明周期／单位与时间来源），提供原始16位CNT、有符号窗口增量、累计计数、实际dt及采集／错误状态。正确处理正反向、16位回绕、初次采样和异常间隔；说明累计值范围及溢出处理。轮侧CPR未标定前只报counts及counts/s，不能输出貌似已标定的RPM或m/s。
4. 优先增加独立EncoderBench入口、Core/Src应用及MDK-ARM工程，以Keil Watch读取，避免覆盖已验收MotorPwm。若选择已有适合的独立入口，说明理由并保持原目标行为。首次只手转轮，电机四输入始终保持零；编码器供电需按既有驱动3V3／GND实际拓扑准备，不能把驱动OFF导致未供电误判为编码器故障。
5. 保留现有SPL、全部六目标和Direct A/B、MotorPwm独立入口、时钟／启动限时、必要看门狗与故障保护。不占用TIM1／TIM5或串口，不修改已通过PWM驱动、频率／占空比／时长，不顺手接入HardwareBench整车运动请求。
6. 必要数学换算若值得独立模块，遵循Algorithms纯算法边界；本次无需提前搭建PID／tracking空壳。应用代码详细中文注释，解释单位、计数符号、初始化／中断和边界处理。
7. 更新control/docs/encoder_bench.md、适用模块导航／软件验证记录，并准备testing/2026-10-25_encoder/acceptance_record.md待填表；任务结果回写本文件，不由01同时修改全局project_status.md。

## 验证与现场门槛

- 软件：编译新增及受影响目标，电脑检查真实增量／时间换算逻辑，覆盖正反向、正反回绕、静止、初次采样、异常dt与两路独立性；既有未变目标用适当兼容检查保留，避免反复重测无关模块。只镜像宏值的测试不计有效证据。
- 人工入口必须是当前Keil5图形界面＋已确认DAPLink，给出工程、唯一目标、Rebuild、Flash Download、Verify OK、F5／Periodic Window Update及最少可复制Watch字段。代理不自动连接或烧录。
- 首次实物仅只读计数：电机输出禁止，按既有方案给编码器供电；分别手转每只输出轮正／反向，检查对应计数变化及另一通道独立。无编码器供电或管脚数字证据时，先记录缺口，不直接判坏。
- 轮侧／方向：主控与硬件按实际安装登记A/B对应左／右、车辆前进的轮转方向及原始计数符号。以输出轮或输出轴完整一圈为单位做重复标定（建议每侧3次），保存每次真实计数、转圈方法及一致性，不把电机轴圈数当车轮圈数，不为通过而随意改符号。
- 本轮先不增加动力试转、不在动力输出时暂停CPU；若需要以已通过MotorPwm短脉冲补充“电机A↔编码器A”配对，应在初次手转数据回来后由00／02明确安排，仍使用现有受控停止。
- 完成范围分开报告：软件交付、手转采集、CPR／方向标定。未实测填写待验，不因编译通过宣称轮速可用；AB并转、PID和地面运行不在本任务验收内。

## 本次授权与接续位置

00目前只生成任务及Prompt。主控转交01后，允许01在上述范围本地实现、保存与电脑检查，准备人工步骤；不授权代理自动操作板卡、驱动电机、跨聊天发送、提交／推送、发布或切分支。共享checkout的写入、Keil保存／构建及硬件操作必须顺序进行。

00实查目录D:/Projects/yeye，分支codex/current-version-20261025，HEAD 0b0343577895d8eb03a337165da6ce9c5e433519；本地标签formal-2026-10-25指向同一HEAD。开工前已有project_planning/version_handoff.md本地修改，须原样保留；00本轮还会修改状态／导航并新增任务，01须重新列出当前修改，不能按旧“干净工作区”覆盖。历史笔记本交接目录D:/projects/projectsyeye不是本机现用目录，不据其文本改动本机路径。

结果回写本任务：实际改动、版本与产物、构建／有意义测试、已确认硬件事实、待填实物表、可复制Watch及下一步。00读文件后顺序汇总全局状态。

## 可直接转交01的完整Prompt

本对话继续承担01主控固件开发，执行C-02C双编码器采集与轮侧、方向标定。项目D:/Projects/yeye，分支codex/current-version-20261025，来源完整HEAD 0b0343577895d8eb03a337165da6ce9c5e433519；正式标签formal-2026-10-25为同一基线。先核对实际目录／分支／HEAD和共享未提交修改，保留version_handoff.md及00本轮文档，不切分支，不覆盖Keil配置。

先读AGENTS.md、.agent/skill/grill-me/SKILL.md、project_planning/collaboration_standard.md、project_status.md、tasks/README.md、本任务project_planning/tasks/C-02C.md，以及docs/architecture.md、control/README.md、control/docs/standard_library.md、pin_plan.md、motor_pwm.md和本次PWM验收记录。新源码使用Core／App／Drivers_Custom／Algorithms／Tests／MDK-ARM分层，不恢复旧firmware/src，不迁HAL。

主控已确认两马达Direct正常，且MotorPwm A/B分别起转、约500ms自动停转与灯态完整流程符合预期；保持MotorPwm独立入口、0x020B0004、1kHz／50%／500ms及保护，不重复旧故障排查，不要求重认型号或重插已确认接线。当前没有编码器读取与闭环实现，AB同时动作、轮侧／方向和CPR待实测。

实现TIM3 PC6/PC7 AF2与TIM4 PB6/PB7 AF2双编码器读取，提供原始CNT、有符号增量／累计计数、dt、采样状态，处理回绕／首样／异常间隔；CPR未标定前不要伪造RPM。TIM1电机、TIM5启动等待、PA0 KEY、UART和SWD保留。优先独立EncoderBench图形下载入口，首次电机输出始终零，仅按既有供电方案给编码器上电、手转轮采集。新增驱动放Drivers_Custom/Encoder，应用／入口按现有层次放置，保留六目标及Direct A/B、MotorPwm独立工程，不改已验收PWM或引入PID。

给出详细中文注释，完成受影响目标构建及有意义的增量／时间／回绕检查；新增control/docs/encoder_bench.md和testing/2026-10-25_encoder/acceptance_record.md待填表。人工操作只用Keil5和既有DAPLink，明确入口、动作、预期、Watch及供电条件。验收先静止／两路手转正反向与独立性，再由主控／硬件按每输出轮完整一圈重复标定CPR及左右／前进符号；真实数据未回报保持待验。

仅本地实现、文档及电脑验证，不自动烧录／驱动／跨聊天／上传或切分支。共享写入、Keil保存／构建顺序进行；执行结果与证据写回同一C-02C任务及模块记录，全局状态留00汇总。交回版本、文件、构建／测试、产物、最少Watch清单、纯Keil步骤与待验收项。
## 00本轮准备与检查边界

00核对了正式基线的源码、模块说明和主控现场回报；重写PWM的4份应用／驱动／状态机源文件与已归档软件清单SHA256一致。当前motor_pwm.uvprojx能解析XML、相对本地HEAD无Git差异，但原始SHA256与旧构建清单不一致，原因未在本轮追溯，不把工程字节完全一致列为通过。00没有改工程、重跑编译或板卡；01新任务构建前按实际工程／编译器配置核对，不为匹配旧哈希覆盖已认可正式版本。

若01在另一台设备继续：使用该设备既有yeye Clone和实际路径，记录来源分支／完整HEAD／本地差异。00本轮任务与摘要尚未上传，不能假定新文件已在另一设备。主控应转交本任务的完整Prompt；缺任务文件时可按完整Prompt在对应project_planning/tasks/C-02C.md建立同一任务，不创建第二个ID、不为获取文件擅自覆盖或切回旧main。涉及固件改动接续仅在核对正式基线与保留本地成果后进行。

## 01执行结果（2026-10-25，北京时间）

### 软件交付与实际文件

主控在本对话直接授权后实施；未把任务文件或00回报当成烧录授权。实际Clone为D:/Projects/yeye，分支codex/current-version-20261025，完整HEAD仍为0b0343577895d8eb03a337165da6ce9c5e433519；正式标签经^{commit}解引用后相同，原rev-parse标签对象ID不是提交不一致。开工已有control/README、根docs导航／架构、硬件导航、全局状态、version_handoff和任务草案改动；本轮只在授权模块及本任务落笔，未覆盖其它对话成果、切分支或修改全局摘要。

新增：

- [Core/Src/encoder_bench_main.c](../../control/Core/Src/encoder_bench_main.c)：独立初始化／异常零电机、R1及1ms滴答／10ms采样。
- [App/Diagnostics/encoder_bench.c](../../control/App/Diagnostics/encoder_bench.c)、encoder_bench.h：两路采样对象及Watch发布。
- [Drivers_Custom/Encoder/encoder_hw.c](../../control/Drivers_Custom/Encoder/encoder_hw.c)、encoder_hw.h：TIM3／TIM4 SPL四倍频和实际CNT／数字电平读取。
- [Algorithms/Encoder/encoder_counter.c](../../control/Algorithms/Encoder/encoder_counter.c)、encoder_counter.h：有符号模差、64位饱和累计、dt与counts/s、首样／丢窗状态。
- [MDK-ARM/encoder_bench.uvprojx](../../control/MDK-ARM/encoder_bench.uvprojx)：独立唯一EncoderBench；新本机encoder_bench.uvoptx克隆原已验证CMSIS-DAP设置和最少Watch，被Git忽略，未覆盖其它配置。
- [test_encoder_counter.c](../../control/Tests/Host/test_encoder_counter.c)、[test_encoder_bench.c](../../control/Tests/Host/test_encoder_bench.c)、fakes/encoder/stm32f4xx.h；[run_encoder_tests.ps1](../../control/tools/run_encoder_tests.ps1)、[build_encoder_bench.ps1](../../control/tools/build_encoder_bench.ps1)。
- [encoder_bench.md](../../control/docs/encoder_bench.md)、[待填验收表](../../testing/2026-10-25_encoder/acceptance_record.md)、[软件证据](../../testing/2026-10-25_encoder/software/README.md)。

修改既有文件限于Core/Inc/stm32f4xx_conf.h的独立目标条件，control/README及Core／App／Drivers_Custom／Algorithms／Tests／MDK-ARM模块导航、standard_library.md、pin_plan.md实施补充和validation.md。原所有应用／驱动.c及其余.h、全部既有工程和本机配置与开工快照一致；新源不编入旧六目标。没有更改已验收PWM源、频率、占空比、时限、人工触发或停止保护。

实现选择：保留原始a/b符号，不猜左右／前进；两路16位CNT独立，10ms名义调度，实际dt参与速率；异常dt或半量程差丢弃、重新建基线并锁存连续性缺失。64位累计溢出饱和且冻结。没有RPM／m/s、CPR常量、PID或新的动力测试。完整状态、范围及观测限制统一在encoder_bench.md，不复制第二份参数规范。

### 构建、电脑检查及产物

- 新EncoderBench 0错误0警告，Code4500／RO424／RW60／ZI1236；原六目标、独立MotorPwm及MotorDirectB共8个既有目标兼容构建均0错误0警告。Direct A独立文件字节保留，同源MotorDirect已构建，不重复无关构建。
- 新计数算法8022次断言，其中2000段独立已知双路轨迹；真实入口／App／SPL适配模型12场景241898次断言（含等待循环）通过。覆盖首样、正反、两方向及时间回绕、异常dt、负数换算、累计饱和、两路独立、R1等待故障、读失败、SysTick失败和始终零电机。
- R1六初始化函数名称映射后可执行代码相同；原.c/.h除条件头外、既有Keil／uvoptx与开工哈希相同，16份官方来源一致。实际AXF无PWM启用／CCR更新或电机SetBits调用；源文件／日志与文档最终核对见[checks.json](../../testing/2026-10-25_encoder/software/checks.json)。
- MotorPwm与MotorBench BIN仍为ea10fb83a5497c40c346ee6005073562dade79b013fcc8c6a5f6ec4d49d65a33，Continuous与Direct A BIN匹配各自记录。原已通过软件模型未改变，未重复跑旧电机／协议模型，不声称本轮再次物理试转。
- 新revision 0x020C0001；产物control/build/firmware/encoder_bench/encoder_bench.axf／hex／bin，本机忽略缓存。BIN4984字节、SHA256 e5587b20177dde0119215350b6b59f4e21d4820a3541945588a7a2e2ee5ea7f8；其余哈希见模块产物表／checks.json。

### 现场结果和主控操作入口

初次软件交付时尚无新板级数据；之后收到的首圈实物图见本任务末尾最新记录。已确认的Direct A/B与MotorPwm A/B起转、自动停转继续采信，但不证明编码器供电或计数。前进符号／最终CPR尚未冻结；AB同时动作、闭环和地面运行不在范围。

主控按encoder_bench.md纯Keil5步骤：全断电分离四根M1/M2电机动力线并绝缘，编码器V/G/A/B与九线保留；XT30拔开先打开独立工程、Rebuild、CMSIS-DAP SWD 1MHz、手动Flash Download并Verify，确认0x020C0001、ms增长、fault0、watchdog_stage4、motor_odr0。再按既有驱动3V3拓扑给编码器供电，F5持续Run／Periodic Window Update，先静止、再分别手转双轮正反，之后每侧3次输出轮完整一圈并记录原始起终点及flags。这里接驱动供电仅服务编码器，电机M1/M2仍断开；无供电或CNT不变不能直接判编码器坏。

最少Watch六行：g_encoder_bench_revision、g_encoder_bench_ms、g_encoder_bench_fault、g_encoder_bench_watchdog_stage、g_encoder_bench_motor_odr、g_encoder_bench（展开a／b）。所有手转／标定数据填原验收表；静止两次刷新累计一致才抄值，普通Watch不是原子快照；暂停、复位、flags非0使该次CPR作废。

### 接续与00读取

软件交付完成，主状态待验收；唯一下一步是主控／硬件按待填表做无动力手转与每侧三次整圈标定，交00读取本任务。实测返回后再确认方向系数与CPR，不擅自改符号、加PID或借旧PWM补动力测试。00可据本文件顺序更新全局状态及架构／API导航中旧“编码器未实现”摘要。

全部本地保存，有本轮及开工未提交／未上传改动；HEAD、来源分支、MotorPwm独立入口与原目标行为保留。没有自动连接板卡、烧录、接电池、驱动电机、跨聊天、提交或上传。编码器板级采集、CPR和整车表现未通过，电脑结果不替代实物验收。

## 2026-10-25补充：面向初学者的详细操作教程

主控要求生成详细操作教程。01在原[encoder_bench.md](../../control/docs/encoder_bench.md)扩充12步操作，不建立第二份参数规范或新任务：认线／全断电隔离绕组、独立工程、Rebuild及DAPLink设置、Download和独立启动、Watch逐行添加／F5／Periodic Window Update、编码器供电、两侧正反手转、前进符号、完整输出轮一圈与每侧3次、收尾回报及常见现象排查。包含纯算术的负数计数示例，明确不代表本型号CPR；仍填写原实物表。

菜单及快捷键对照Keil官方Debug／View／Watch说明，供电与针脚引用本地已确认资料。文档链接、Watch字段／状态与实际源码检查见testing/2026-10-25_encoder/software/tutorial_checks.json。补教程时观察到EncoderBench工程XML字节与AXF指纹已变，归一化XML语义与原配置完全一致，源码及BIN／HEX仍匹配初次交付；当前AXF指纹已在模块产物表注明，原checks.json保留不改，不猜测变化由哪次保存／构建产生。本次没有改固件、工程或下载配置，未重复运行未改变的构建／模型，也未操作板卡或上传。软件及手转／轮侧／方向／CPR验收状态与上一节相同，全局状态仍由00读取本任务汇总。

## 2026-10-25实物增量：左a／右b首次完整输出轮一圈

主控上传两张Watch原图，说明分别为左轮A、右轮B完整一圈；随后明确各自刚开始debug、起点total_count均为0。01原字节归档至[hand_turn](../../testing/2026-10-25_encoder/hand_turn/README.md)，SHA256及结构化读数见readings.json，并回填同一验收表。

左a：raw0x0418／total0x418=+1048，首圈绝对1048 counts；右b：raw0xFBEA=64490／total0xFFFFFFFFFFFFFBEA=−1046，首圈绝对1046 counts。两帧delta0、counts_per_s0、dt10ms、valid1、status0、flags0。零窗口读数与一圈完成后停下相符，不能解释为没有计数；右负数为合法的反向累计，不直接判接错。左右对应来自主控现场描述，图本身只显示a／b。

已具备首次两路手转计数证据，不再写成“尚无任何实物数据”；但各侧仅1次，两侧相差2 counts不能替代同侧重复性验收，也不平均成已冻结的CPR。主控回复明确了零起点，尚未单独描述是否均按车辆前进方向旋转，因此只记录本次a正／b负，前进系数不写入代码。

下一步：保持绕组隔离与F5持续Run，每侧同一方向补测2次完整输出轮一圈，每圈停稳记录start→end和flags，并注明该方向是否为车辆前进转向；不用为清零重新Debug／RST，计数以差值计算。另补反向及另一通道独立观察。revision／全局ms／fault／watchdog_stage／motor_odr、供电电压、M1/M2隔离和收尾没有随图展示，继续按原表待核，不据图代填。

仅归档／计算／更新模块和任务证据，没有改固件、编译、连接／烧录、试转、跨聊天或上传；全局摘要由00读本任务后更新。主状态仍待验收，编码器最终CPR、前进符号和闭环均未通过。

## 2026-10-25实物增量：第2／3轮收齐，最终CPR暂未冻结

主控追加两张展开a/b的原图，说明第二轮、第三轮，起点均为刚进入调试的初始零状态。原字节归档03_round2_a_b_one_turn.png、04_round3_a_b_one_turn.png，读数／SHA256与统计见[hand_turn](../../testing/2026-10-25_encoder/hand_turn/README.md)及readings.json，原验收表已回填每侧3次。

第2轮左a0x432=+1074，右b0xFFFFFFFFFFFFFBD0=−1072；第3轮左a0x42B=+1067，右b0xFFFFFFFFFFFFFBBC=−1092。四个新增通道帧均delta0／速率0／dt10ms／valid1／status0／flags0。结合第1轮，左一圈绝对1048、1074、1067，均值1063、极差26（约均值2.45%）；右1046、1072、1092，均值1070、极差46（约4.30%）。三次样本要求已取得，不再重复要求提供第二／第三轮。

这些是样本统计，尚非已冻结CPR。现有任务未规定已验证的极差门槛，flags0也不证明物理一圈标记准确或信号无噪声；无法由截图区分手转对齐、回摆、机械或电气原因，不回到旧电机不转排查，不直接判编码器／程序故障。

下一步最小复核：继续保持电机绕组隔离和F5 Run，轮／车架固定标记，每侧沿明确车辆前进转向连续手转5个输出轮整圈，停稳记start→end及flags，再用abs(end−start)/5复核CPR并注明是否与前三次同转向。仅手转，不运行电机、不自动加功率；反向／另一通道独立性、未随图全局字段及供电／隔离／收尾继续待核。未经实测确认不写方向系数或CPR，不进入PID。

本次仅计算／归档／更新任务及模块记录，没有改固件、重编译、自动连接／烧录／驱动、跨聊天、提交或上传；全局状态仍由00读取本文件汇总。

## 2026-10-25实物增量：连续5圈已收，标定候选左1060.8／右1058.8

主控提供同时展开a/b的新原图，说明两轮均为调试初始零状态、各转5圈。原图按字节归档[05_five_turns_a_b.png](../../testing/2026-10-25_encoder/hand_turn/05_five_turns_a_b.png)，SHA256及数据见hand_turn/readings.json的five_turn_check。

左a0x14B8=+5304，右b0x14AE=+5294，除以5分别为1060.8／1058.8 counts/输出轮圈；两帧delta0／速率0／dt10ms／valid1／status0／flags0。同向圈数复核已完成数据采集，不再追加相同轮数要求。将结果作为当前候选保留，不写入固件、不平均成统一CPR；此前3次单圈均值／极差仍原样保存，不能由一组5圈宣称重复性误差已定量验收。

方向新缺口：右b由此前三次负计数变为本次正计数，01已用文本问题询问本次两轮是否均按车辆前进转向、右轮是否改变了手转方向。未得到明确答复前不猜测原因，不自动换线或改系数。此前单圈读数不能未经转向确认就当作前进符号；本次正数也不能直接等同车辆前进。反向／独立性及全局运行／供电／隔离／收尾未随图字段继续按原验收表待核。

本次更新原图、结构化读数、原验收表、模块导航与本任务；没有固件／工程修改、重编译、自动连接／烧录／驱动、跨聊天或上传。全局摘要仍由00顺序读取汇总，主状态保持待验收。

## 2026-10-25实物确认收口：左右前进符号及独立性已明确

主控上传右b重做图，明确起点为初始状态、转向按车辆行驶方向。原图[06_b_forward_five_turns.png](../../testing/2026-10-25_encoder/hand_turn/06_b_forward_five_turns.png)为raw0xEB53=60243、total0xFFFFFFFFFFFFEB53=−5293；按上一轮同样5圈复测上下文，abs(−5293)/5=1058.6 counts/输出轮圈。本次delta0／速率0／dt10ms／valid1／status0／flags0。右轮原始前进符号因此明确为负、编码器应用系数−1；此前正计数5圈+5294的原图不覆盖，仅作为正符号样本保存，不追认其采集时已明确车头方向。

01随后询问A此前+5304的5圈是否也是车辆前进方向，主控明确答复“是，A当时也是前进方向”。因此左轮原始前进符号为正、编码器应用系数+1，CPR初版估计5304/5=1060.8 counts/输出轮圈。参数按左右分别记录，不平均为通用CPR。

主控又明确确认三项观察：单独转左轮只有a变化、单独转右轮只有b变化、左轮反转时a累计减小。左右映射、车辆前进符号、左反向与基本手转独立性已有现场反馈，不再要求重复同向圈数。本轮软件与主控手转标定已具备交接依据，提交00核对采用，主状态待验收；没有把文字观察改写成新的同步截图。

初版参数记录（未写固件）：左a、+1、1060.8 counts/输出轮圈；右b、−1、1058.6 counts/输出轮圈。方向系数只用于后续将编码器车辆前进计数统一为正，不证明MotorPwm的电气正输出就是车辆前进。后续速度／PID或带动力标定需00另行安排，本任务不自行进入。

全部图像、SHA256、三次单圈／五圈／右b前进重做读数、主控确认及初版参数保存在[原实物记录](../../testing/2026-10-25_encoder/acceptance_record.md)和hand_turn/readings.json。未随图提供的revision／全局fault／ms／watchdog_stage／motor_odr、实测电压、隔离／收尾条件如实留空，不宣称计量精度或整车验收通过，也不因此要求否定／重复已确认手转观察。主控可按教程OFF拔XT30及DAPLink结束，实际收尾未回报不预填。

本次仅证据、标定记录与模块导航更新，未改源码、工程／下载器配置，未编译／烧录、操作板卡、驱动电机、跨聊天、提交或上传。下一步由主控让00读取本任务与原实物表，核对初版参数后再安排新任务；01不写全局project_status.md。

## 2026-10-25：00核对并采用初版交付

主控在00回报“01完成”，并明确下一步希望封装电机运动调用接口。00读取本任务、原实物表／结构化读数，直接查看05双轮5圈与06右轮前进重做原图，复算左5304/5=1060.8、右abs(−5293)/5=1058.6，结合原记录中的主控方向／独立性确认，采用左a、+1、1060.8及右b、−1、1058.6作为下一阶段初版参数。

00另核对11份C／H源码与软件清单SHA256全部匹配、实际BIN为4984字节且SHA256 e5587b20177dde0119215350b6b59f4e21d4820a3541945588a7a2e2ee5ea7f8；已有编译0错误0警告及8022／241898模型断言记录通过。本轮未重编译、未操作板卡，AXF／工程XML历史差异按原教程记录保留。

本任务在软件及初版手转标定交付层次完成，不把交接回报等同主控认可新的动力表现。不补造未随图全局字段、右轮独立反向专项、供电／隔离／收尾、电压、计量精度或RPM／闭环结果，也不要求重做已明确的同向圈数。初版参数仅在下一任务按配置采用，不追改EncoderBench原始有符号数据。

接续[C-02D](C-02D.md)：统一双轮运动接口、带动力极性确认与低速闭环台架。电机PWM极性须独立于手转编码器符号校准；现有两个成功独立入口保留，真实视觉串口接入另由02组织。任务已准备，尚未发送、实现或操作板卡。
## 2026-10-29机械换位与重新命名补记

主控明确：原右轮移至当前左，原左轮移至当前右；两者旧前进旋转方向均成为新位置的后退方向。随后澄清“左轮为A右轮为B是我现在规定的”。据此只确认物理新A=左、新B=右，不认定实际MOTOR-A/B插口或软件a/b已对应；主控不记得旧接法，不再要求回忆，后续面向当前安装核对。

新左A继承原右轮总成CPR参考1058.6、新右B继承原左轮1060.8；只有在各轮组AB相序未变前提下可推导新A前进正／+1、新B前进负／−1，尚未取得新安装读数，不标为重测通过。当前唯一表及来源见[wheel_mapping.md](../../hardware_preparation/wheel_mapping.md)、[10月29日反馈](../../testing/2026-10-29_wheel_swap/record.md)。这些数字不是软件通道的固有属性，配对后才绑定。

01依本轮“更新全局文档”授权同步摘要、硬件／主控入口及C-02D任务，不接替00、不改变原C-02C交付日期或原证据；本次没有固件／项目配置修改、构建、烧录、驱动或上传。换位后实际通道／方向／电机极性验收仍需后续任务处理，不重做本次未授权的试转。
