AgrumeStly/yeye/project_planning/tasks/G-05.md

# G-05：10月30日当前版本上传与笔记本继续开发

日期：2026-10-30（北京时间）。负责角色／执行对话：主控／03。
依据：主控要求“把当前最新版本更新到github，我要在笔记本上继续开发了”。

## 已确认事实、范围与授权

台式机DESKTOP-0HLUQN7，目录D:\Projects\yeye；当前分支codex/current-version-20261025，开始HEAD为0b0343577895d8eb03a337165da6ce9c5e433519。开工Fetch并查询远端，同名分支仍为该提交，与本地领先0、落后0；main仍为82640aba4cf7aa4f30db14b486aef852936118fe。

本次授权提交并上传全部当前相关项目成果，继续使用现有任务分支。包含编码器源码／独立工程／测试及原手转图像、轮位变更与新物理命名、比赛转写与赛道图、报名记录、底板资料、V-01／H-03／C-02D等任务及已有全局摘要、本机上次接收回填。本次仅版本保存，不改业务逻辑或重做参数、功能和实物验收。

不合并main、不创建Release、不移动formal-2026-10-25正式标签、不操作笔记本或板卡，不发送跨聊天消息。保留其它工作的文件内容；账号／令牌、编译输出、本机uvoptx／uvguix／DebugConfig、Obsidian窗口缓存及tmp日志沿用忽略规则，不上传。

## 目的与事实边界

本次保存使主控换设备后能复用原源码、接口、标定证据及当前轮位，降低拿错旧参数／旧版本导致后续循迹失败或触线的风险，支撑比赛第三部分项目要求及基本功能用时评分。它是开发连续性工作，没有新比赛得分或整车实测结论。比赛依据仍为[原PDF](../../competition/比赛文档.pdf)与[全文转写](../../competition/比赛文档.md)。

当前物理A=左、B=右；10月29日已交换轮组，旧左右／通道参数不能直接套用。接续先读[唯一当前映射](../../hardware_preparation/wheel_mapping.md)、[轮位原反馈](../../testing/2026-10-29_wheel_swap/record.md)与[C-02D](C-02D.md)，分别对应物理轮、驱动插口、软件通道及旧轮组参数。本次上传不把推导方向写成新安装已实测，也不授权自动开始闭环实现。

## 执行与验证

- 开工记录272份现存非忽略文件的路径、大小、SHA256至本机tmp/g05_upload/baseline.json；提交前检查执行期间是否新增或改变其它工作。
- 2026-10-30重跑原六个电脑测试脚本及run_encoder_tests.ps1，全部通过。编码器计数模型8022次断言、EncoderBench入口／SPL模型241898次断言／12场景通过；断言次数不是独立场景数。
- 使用既有build_encoder_bench.ps1在台式机实际构建EncoderBench，Keil／ARMCC5.06u5为0错误0警告，BIN SHA256为e5587b20177dde0119215350b6b59f4e21d4820a3541945588a7a2e2ee5ea7f8。只构建／导出，没有下载、连接板卡或试转；其它原构建证据继续按原日期保留。
- 提交前检查路径清单、文本编码、工程引用、本地文档链接、常见凭据模式和差异格式；原始UTF-16日志及厂家旧编码保留，不能为了格式重写原始实测／构建证据。
- 本轮静态检查273份现存项目文件：95份Markdown、932个本地链接、229份文本、5份Keil工程的264项源文件／Include引用及16项厂家清单哈希通过；8份UTF-16原日志和厂家头文件旧编码按原字节保留，所查常见凭据模式无匹配。开工272份文件除本次版本交接回填外内容哈希全部不变，没有发现执行期间新增的其它修改。
- 完整暂存差异仅在testing/2026-10-25_encoder/software的8份原始Keil构建日志Program Size行发现工具生成的尾随空格；按原证据保留，排除这些原始构建日志后的git diff --cached --check通过，不宣称原日志没有空白提示。
- 最终上传完整提交、静态检查数、远端匹配结果及剩余本地项由03最终回报给出；不为把文档自身提交号写入正文重复提交。全局摘要由00读取本任务后顺序更新，不由03另改项目技术结论。

## 笔记本已有仓库怎样接续

来源记录显示笔记本曾使用D:\projects\projectsyeye（设备记录JokeBearDesktop）；主控以笔记本实际Clone目录为准，不另建覆盖现有工程。先在该目录检查：

```powershell
git remote -v
git status --short --branch
git branch --show-current
git rev-parse HEAD
```

工作区如有未提交修改或本地新提交，先保留并让03核对，不使用reset／clean覆盖。确认目录正确、origin为AgrumeStly/yeye、无其它对话写入，且工作区干净后：

```powershell
git fetch origin
git switch codex/current-version-20261025
git pull --ff-only origin codex/current-version-20261025
git rev-parse HEAD
git status --short --branch
```

HEAD应与03本轮最终回报的完整提交一致。不能快进或远端已有后续提交时保留现场再核对，勿强推。尚无本地同名分支时，用 `git switch --track -c codex/current-version-20261025 origin/codex/current-version-20261025` 代替switch／pull；首次Clone指定 `--branch codex/current-version-20261025`，不能直接用旧main。

formal-2026-10-25固定历史正式快照，本轮HEAD正常会比它更新，不能要求标签与最新HEAD相等。

## 笔记本Codex接续

在Codex打开实际Clone目录，继续原01职责；若旧对话不可用，新建本地聊天并发送：

```text
在笔记本接续01主控固件开发。先核对实际项目目录、origin、分支、完整HEAD及工作区状态，读取AGENTS.md、project_planning/collaboration_standard.md、project_planning/project_status.md、project_planning/tasks/G-05.md和当前任务相关文档。
本轮先恢复上下文：尤其读取hardware_preparation/wheel_mapping.md、testing/2026-10-29_wheel_swap/record.md及project_planning/tasks/C-02D.md，保留现有MotorPwm和EncoderBench成功基线；不要直接沿用旧左a／右b参数或把推导方向视为新安装已测。
报告当前实现、证据范围、笔记本环境差距与最小下一步；后续实现按主控明确任务执行。此恢复指令不授权上板、驱动电机、上传、合并、发布或跨聊天发送；00仍负责全局协调。
```

工程继续使用control/MDK-ARM现行入口；笔记本Keil、芯片包、gcc、驱动、串口及调试配置分别核实，Git不会安装工具或复制本机下载器状态。笔记本当前设备、目录、HEAD和实际接续结果本轮未直接核对，保持待确认。主控完成后可回报03实际版本，再由00读取任务接续全局安排。
