AgrumeStly/yeye/project_planning/tasks/H-03.md

# H-03：单层铝合金底板装配准备

日期：2026-10-26（北京时间）。主状态：未开始（00已准备接续Prompt，未代发）。执行对话：02；硬件负责实物准备与操作，视觉负责摄像头安装接口及视场输入，00协调。

依据：主控已下单单层铝合金板，提供硬件准备目录资料。采购记录与图纸结论只维护于[底板记录](../../hardware_preparation/chassis_record.md)。

## 目标与验收边界

先完成资料层面的布局和适配表，明确驱动轮、万向轮、电池、AT8236、STM32及视觉部件的安装位置、固定方式、绝缘与维护空间。通用孔位不等于现有MD310支架或板卡孔距已适配，不虚构缺失尺寸，不默认需要补购或加工。资料阶段不阻塞01的[C-02D](C-02D.md)。

比赛第三部分项目要求、整车尺寸／重量限制、图1与评分表为依据：支撑60分基本行驶，避免机械松脱、干涉、包络过大导致触线扣分或出界失败；不得把铝材本身记为加分。资料验收检查来源、尺寸链和待实测项；到货后的包络、重量、间隙、固定与绝缘照片另作实物证据，当前不写通过。

## 可独立转交02的完整Prompt

```text
本对话继续担任02整车联调与拼组，承接H-03：单层铝合金底板装配准备。
项目目录D:/Projects/yeye；交接时分支codex/current-version-20261025，HEAD为0b0343577895d8eb03a337165da6ce9c5e433519。目录存在多项未提交修改，包含编码器软件、文档及hardware_preparation/size/原始资料；不得仅以HEAD代替完整当前成果。开始先核对当前状态并保留其他工作的修改，不切分支、不清理工作区。

先读AGENTS.md、.agent/skill/grill-me/SKILL.md、project_planning/collaboration_standard.md、project_planning/project_status.md、project_planning/tasks/README.md、本任务，以及hardware_preparation/chassis_record.md、README.md、wiring.md、control/docs/pin_plan.md、control/docs/motor_pwm.md、control/docs/encoder_bench.md。制定方案前读competition/比赛文档.md相关要求、评分表和assets/track_figure_1.jpg；有疑义查原PDF。

已确认：主控已下单单层铝合金底板，尚无到货／装车验收反馈。三份底板PDF与万向轮照片在hardware_preparation/size/；文件名写亚克力，订购材质以主控确认的铝合金为准。两图平面尺寸分别标195×128 mm与194.79×128 mm；板厚、实重、具体支架和板卡孔距适配尚待核对。旧FR4尺寸、旧安装坐标不自动适用。复用天空星STM32F407VET6青春版、AT8236 Standard/YB-MNT03-V1.0、MD310Z20_7.4V双电机、既定轮子／万向轮及2S电池，不重新追问已确认型号。现有A/B单独PWM转停和编码器手转初版标定已交付，不改写为整车通过。

本次先做文档层面的装配准备：核对现有资料里的真实支架／轮子／万向轮尺寸；给出单层底板布局草案、孔位选择依据、紧固和电路板绝缘方式、电池固定、线束走向及断电可达性。核对轮子外侧等突出件后的整车长≤300、宽≤200、高≤250 mm、含电池≤5 kg；结合50 cm净宽和锐角弯说明转向间隙待验证处。图上支持370/520等支架不能直接算作MD310适配。资料能解答的先查，仅将影响布置的缺口列给负责角色；视觉提供摄像头固定尺寸／视场需求，硬件提供实物测量，不由主控接管视觉开发。板厚未知不妨碍先给可调整布局；不要直接下单、加工或指定未经确认的螺钉长度。

交付hardware_preparation/chassis_layout.md，包含来源、布局草图或清晰位置说明、孔位／紧固适配表、现有件与待核对项、整车尺寸链及到货后检查步骤（入口、动作、预期现象）。在本任务回写实际完成、证据和剩余项；硬件准备README增加入口。已有事实以chassis_record.md为源，避免重复完整规格表。全局project_status.md由00顺序维护。

验收：本轮只验资料可用和依据完整；装配、绝缘、包络／重量、悬空及地面效果均需后续实物证据。说明如何支撑完赛、降低触线与失败风险，不虚构得分收益。本次只授权本地资料编写与检查；不改固件或成功接线、不烧录／驱动电机、不实际加工装配、不上传、不跨聊天发消息。当前没有硬件实测授权，也不扩展成正式赛道遥控方案。共享目录写入顺序执行，不与其他对话争写同一文件。

结束时给主控H-03文件位置、资料完成项、待实物验证项和一个下一步。01的C-02D可继续，不要求等底板到货。
```

## 当前结果与授权

- 00已核对采购反馈及现有图纸，保存底板记录并更新全局摘要；02尚未领任务、布局未生成。
- 本轮仅本地文档记录和检查；未上传、未自动发Prompt、未修改固件、未操作实物。
- 下步：主控将以上完整Prompt转交02；硬件实物操作待底板到货及对应任务指令。
