AgrumeStly/yeye/control/docs/motor_continuous.md

# MotorContinuous：A桥持续转动测试

> 2026-10-25：按主控要求重写PWM入口与驱动后，共用实现的MotorContinuous版本升级为0x020B1002，仍保留20kHz／30%、人工触发持续A与KEY停止锁定。当前源码仅IN1切AF，IN2保持GPIO低；旧0x020B1001的Watch、BIN哈希与失败结果属于历史版本。新持续目标已编译和模型检查，未重新实物验证；本轮起转测试使用[MotorPwm单次500ms流程](motor_pwm.md)，不使用持续目标。

> 2026-10-25目录迁移：当前Keil工程在control/MDK-ARM，新ARM产物在control/build/firmware；原目标、版本及保护不变。历史产物／日志留原位置，当前分层和迁移验证见[ORG-02](../../project_planning/tasks/ORG-02.md)。

日期：2026-10-24。维护：主控／01。依据：主控本轮直接要求“让马达一直转”；沿用已确认型号、端口及DAPLink／Keil5配置。代码、编译与电脑检查完成；主控已反馈轮子不转、再次按KEY后绿灯闪烁，起转未通过，不宣称电机故障已解决。

最新操作入口：主控暂时无法去实验室，已新增[MotorDirect固定GPIO单次500ms](motor_direct.md)，不用PWM、保留原接线。当前简化试验选择MotorDirect；本页保留原持续目标与实测历史。

这是独立Keil目标 **MotorContinuous**。KEY（PA0／WKUP用户按键）长按约1–2s到灯常亮后松开，A桥保持固定PWM，**不再500ms自动停止**；再次按KEY立即撤输出并锁定，松开／再按都不会重启。需要重新测试时先断动力，再RST，复位后仍需新的人工启动。原MotorBench继续为R3的500ms A→B→AB序列。

2026-10-24主控要求重新检查代码和接线：已完成源码、实际Keil目标、原厂SPL、AF／排针原图、真实AXF及完整Rebuild复核，未发现明确端口或MOE遗漏，但不排除固件其他问题；版本／BIN未变。主控当前先按[完整断电自查表](../../hardware_preparation/motor_wiring_self_check.md)核对九线、电机六芯线及供电，不继续试转；表内也说明当前只A桥和编码器未读取。

| 项目 | 本目标 |
| --- | --- |
| 版本 | `g_motor_bench_revision=0x020B1001`；原R3仍0x020B0003 |
| 输出 | 只A桥，AIN1→PE9 TIM1_CH1／AF1；AIN2→PE11保持低，B桥PE13／PE14保持低 |
| 参数 | 30%=300‰，20kHz，PSC0／ARR799，有效CCR1=240，CCR2–4=0；没有提高占空比或换向 |
| 运行时间 | 人工启动后持续，直至KEY、故障、复位或断动力；不自动轮换到B／AB |
| 保留 | 上电按住不转、松键门槛、长按松开触发、KEY原始电平停止锁定、R1看门狗／限时等待、异常零输出及R3实际寄存器快照 |
| 灯态 | 上电松键约1s后每组1闪；按住达标及运行常亮；KEY停止后快闪锁定 |

## 主控纯Keil操作

1. 下载时**驱动OFF、XT30动力电池拔开**，UC2不接。沿用DAPLink五线供主板，天空星Type-C空着，两板共地且不并联5V／3V3。主控重新打开`D:/Projects/yeye/control/MDK-ARM/yeye_control.uvprojx`，目标下拉选择 **MotorContinuous**，不能选仍会500ms停止的MotorBench。
2. 若在调试中先Ctrl+F5退出，再Project → **Rebuild all target files**。本机构建应0错误0警告，Code5164、RO424、RW64、ZI1288。新目标本地调试项已从已用的MotorBench复制，原目标设置保留；Options for Target → Debug应为CMSIS-DAP、SW、1MHz，Flash Download为STM32F4xx 512KB／0x08000000，Utilities使用Debug Driver。不要换为Simulator。
3. 点击 **Flash → Download**，等Programming Done、Verify OK。Keil直接使用`build/motor_continuous/motor_continuous.axf`，无需终端或手选BIN。退出调试；动力仍断开，拔插DAPLink USB使主板重启，KEY／BOOT0松开，确认每组1次待机灯。需要核版本时仅在电池拔开时用Watch查看0x020B1001、ms递增、fault0，然后退出调试再复位回待机。
4. 电机固定、轮子悬空、线束远离轴，确认Keil已退出调试。驱动OFF时连接XT30，再将驱动ON。先不按键，应无自行转动。待机每组1闪时，**KEY长按到常亮，再松开**：只A桥持续输出，不再自动切到双闪。B桥不运行，A不是已标定的左轮或前进方向。
5. **再按一次KEY即可停止并锁定**；真正切断动力使用驱动OFF／拔XT30，不只拔主板电源。00滑行不保证机械立即静止。若A仍完全不转／仅抖动，在约1–2s内停止并断动力，不保持堵转等待，也不自行提高占空比；持续输出本身不保证起转。

本目标没有编码器、堵转、电流或温度检测；持续模式不等于电机可无人看管运行。测试中不接动力单步／打断点。主控回报选中的目标、Verify结果、KEY松开后A是否转动／声音、KEY停止是否有效；没有反馈不标记通过。

## 实现、验证与产物

只在新目标增加`MOTOR_CONTINUOUS_A_TARGET=1`，复用现有SPL入口、PWM及看门狗。纯状态机在此宏下不执行500ms超时且step只允许0；无此宏的原目标行为保留。没有迁移HAL或改官方库；CMSIS的SysTick／内核异常支持继续保留。

电脑实际结果：持续目标113条／7场景通过，直接使用真实main／SysTick／PWM，模拟120秒持续输出、跨毫秒回绕、KEY与fault停止、停止锁定和非法阶段归零；另以持续宏运行R1启动154条／10场景通过。原R3诊断131条、原台架73项和协议55项全部通过。MotorContinuous与MotorBench均编译0错误0警告，原MotorBench BIN仍为5696字节／d09c4095…，与开工R3逐字节相同；原四目标的工程及本机调试设置结构不变。电脑120秒是快速模型推进，没有运行实体电机。

新产物目录`D:/Projects/yeye/control/firmware/build/motor_continuous/`：

| 文件 | 字节 | SHA256 |
| --- | --- | --- |
| motor_continuous.axf | 397460 | `e058c690d436f282d1ebc7276ac05297049b1c5626bc5346df015536f1c0072f` |
| motor_continuous.hex | 15957 | `366e915629db25e50be0f32ccd0f90a611bf5ea3c44859fe54c31de1f30f90d9` |
| motor_continuous.bin | 5652 | `5cd07579b14e1e50e736e2ba0553f21197d6784a305febb6402c9050a55a1eef` |

上表AXF已更新为2026-10-24新增MotorDirect后的回归构建实际哈希；前次端口复核AXF为f00bcbe5…，留存于`control/build/motor_direct_baseline/`。本次共享状态机增加独立宏分支与中文注释，原持续目标BIN／HEX逐字节不变、版本不变；AXF含调试信息，哈希发生变化，不因此要求重新烧录原持续目标。详见[新目标检查](motor_direct.md)与[端口复核表](../../hardware_preparation/motor_wiring_self_check.md)。

本地main、HEAD `82640aba4cf7aa4f30db14b486aef852936118fe`加未提交修改；保留其它工作，不切分支、不提交或上传、不自动操作板卡。BIN／AXF及日志被Git忽略。新日志为`control/firmware/build/MotorContinuous_build.log`、`control/build/motor_continuous_tests.log`、`motor_continuous_startup_tests.log`；开工源码、旧产物与本机uvoptx备份在`control/build/motor_continuous_baseline/`。新目标的本机uvoptx也被忽略，换电脑需按第2步核对CMSIS-DAP配置。

## 2026-10-24持续测试现场反馈

主控反馈“轮子不转，再次按Key后绿灯闪烁”。记录实际无转动与按键后的灯态；本轮未额外提供Verify、板内版本、启动时灯态、闪烁节奏或寄存器，不补造。闪烁与程序KEY停止后ABORTED提示相符，但灯态本身不证明控制线、驱动输出或机械停止正常。保持原程序与30%，不因持续时间增加仍失败就直接加功率。

已复用I-05反馈：电池7.4V、驱动Vin开关OFF为7.4V／ON为7.56V，驱动5V／3V3反馈正常（未报具体值）；不重复要求确认型号、整套接线或静态电压。下一步建议由主控／硬件在既有短时人工测试条件下，先测**驱动端AIN1对驱动GND**启动／停止两个直流电压读数，定位控制是否到达驱动入口。保持Keil退出调试；驱动OFF并拔XT30时固定表笔，黑COM接GND、红V接AIN1，用DCV档，不用电流档／通断档；再按原步骤给驱动供电，KEY启动，约1–2s读取后KEY停止并关驱动拔XT30，不带电挪探头。

3.3V高电平、30%占空比的理想平均值约0.99V，仅作万用表粗筛；实际仪表响应及输出电平未测，不据此设严格合格线。读到平均电压变化不能证明20kHz／30%波形、电机驱动输出或带载能力；先回报两个真实数值，再安排下一边界。当前没有执行该建议、没有新电压读数或根因结论，本轮只更新本地记录，无固件变更、构建、烧录或上传。

后续反馈：主控答复“是1v”。依上一问语境，暂按驱动AIN1对GND启动时约1V记录；停止值未报，也未另报测点／仪表档位，不补填为0V。此平均值与30%／3.3V的理想平均值相符，仍不证明真实波形、驱动输出或起转正常。下一步只核对驱动AIN2（PE11对应）在A启动时是否接近0V：完全断动力后换探头，黑接驱动GND、红接AIN2，RST解除上次KEY停止锁定并回待机，再按原短时人工步骤读取，随后KEY停止、OFF拔XT30。AIN2读数待主控回报；不改代码或功率。

随后主控答复“0v”，按上一问的驱动AIN2启动时对GND读数记录为0V。现有AIN1约1V／AIN2为0V与PWM／0的平均电平初筛相符，不能据万用表判定脉冲频率／形状或H桥输出正常。下一步建议粗测**驱动MOTOR-A功率输出AO1−AO2**的启动DCV读数，保持电机原连接，不测AIN控制针或编码器V／G。驱动OFF、拔XT30后固定红表笔AO1、黑表笔AO2（此处黑表笔不是GND），RST恢复主板待机，按原短时步骤供电并KEY启动，约1–2s读取后KEY停止、OFF拔XT30；带正负号原样记录。未实施此建议，功率输出电压仍待主控回报；平均值仅缩小边界，不单据此判定驱动或电机坏。原程序及30%保持不变。

上次反馈：“不开驱动板电源0v，开驱动板外接电源0.07v”。按上一问语境记录AO1−AO2的两个直流读数为0V／0.07V；当时测量是否已KEY启动并绿灯持续常亮尚未说明，因此先补问运行条件，没有直接判驱动故障。

最新补充：主控明确“KEY启动后绿灯持续常亮，仍为0.07V”。至此记录为人工启动、运行灯持续常亮时AO1−AO2的DCV读数约0.07V，电机仍未转；不再将该值仅视为待机读数。AIN1约1V、AIN2为0V仍为万用表平均读数，不能证明输入脉冲峰值／频率或H桥输出波形。没有取得新示波器证据或板内版本读数，不宣称驱动损坏或固件已解决。

资料复核：芯片厂家《AT8236-S409-V1.1》第4–6页说明逻辑高电平下限1.5V、PWM／0为快衰减、输入高电平至少5µs可触发休眠唤醒。当前20kHz／30%的名义高电平为15µs、低电平35µs，未发现必须修改唤醒时序的直接依据；这项计算不能替代实际波形。约1V平均值不等于峰值只有1V，也不能证明峰值已达到1.5V。[厂家手册的立创托管副本](https://atta.szlcsc.com/upload/public/pdf/source/20210923/1552D95CBAF8BE780D06AE79E7783380.pdf)与[本地归档](../../hardware_preparation/evidence/2026-10-18_i03/at8236_datasheet.pdf)为依据。已查亚博官方模块仓库，本次未取得能确认开关到芯片VM路径的完整板级原理图；不猜测芯片焊点，也不以静态Vin／5V／3V3代替实际VM。

下一步只补**KEY启动时驱动Vin+对Vin−的DCV读数**，区别于已有的未触发静态7.56V：驱动OFF、拔XT30及DAPLink USB后，黑COM固定顶部蓝色Vin端子的Vin−、红V固定Vin+，保持DCV档并隔开相邻触点；不测下方Vout，不挪动电机线。恢复主板供电／RST回待机、Keil退出调试，轮子悬空，驱动OFF时接XT30再ON；按原KEY长按松开方式启动，约1–2s内记运行读数后再次KEY停止、驱动OFF拔XT30。若明显下跌或跳动，先停在输入供电边界；若仍接近此前7.5V，只说明万用表时间尺度内外部Vin未明显塌陷，仍不证明芯片VM、PWM瞬态或输出正常。此读数待主控回报，禁止因本步骤自行继续B／AB或增加功率。

本次仅更新本地诊断记录，未改固件、未重编译、未烧录或上传；MotorContinuous版本及前述产物哈希保持不变。

### Vin运行读数补充与下一项断电检查

主控随后答复“均是7.54v”，按上一问记录待机／KEY启动时驱动外部Vin均约7.54V，万用表未显示明显压降；未提供瞬态波形，因此只排除了本次仪表时间尺度内可见的外部Vin明显塌陷，不代表电池带载能力、板内VM或驱动输出通过。电机不转及运行时AO1−AO2约0.07V的结论保持。

下一步改为**断电检查A电机动力线与绕组是否明显开路**，不再为此触发电机：驱动OFF、拔XT30及DAPLink USB，主板Type-C继续断开；记录A桥原接线位置，再只从驱动AO1、AO2拔下A电机的两根动力线，电机端保持接好，其余线不改。万用表黑COM／红VΩ，选电阻Ω档；先短接表笔记录表笔自身电阻，再测这两根已脱离驱动的线端之间的电阻，测量包含线束、接头与电机绕组。不要在驱动AO1／AO2裸针上测，也不测编码器V／G或接电池。以接线指南的M1→AO1、M2→AO2功能为依据，不能按任意线束颜色猜测。

回报实际数值及单位，或OL／超量程；若为OL，在接触可靠且量程合适的前提下定位该电机动力回路的开路，不直接认定电机损坏；有限阻值只说明未发现明显开路，不证明绕组、机械或驱动正常。当前没有厂家绕组电阻验收值，不设虚构的合格区间；接近表笔电阻也不能单据蜂鸣判短路。测完保持断电，等待结果后再安排，不恢复试转或更换功率参数。此项尚未执行，记录与状态更新仅保存在本地，固件产物不变。

电阻检查续报：主控询问测点后，01再次说明应测从AO1／AO2拔下、另一端仍接电机的两根动力线金属端，不测驱动插针或AIN控制线。主控随后反馈“阻值跟表笔短接相近”。按此语境归档为A电机动力回路的定性低阻反馈，未给出表笔短接值、电机回路值、显示单位或量程；不补造数值，也不据此判定电机短路／正常或实测通过。下一步只需补两个原始Ω读数（表笔短接、电机两线之间，连同显示单位／所选量程），以判断仪表能否分辨差值；保持全部供电断开，不恢复电机试转。仅更新本地记录，固件不变。

电阻原始值补充：主控明确“短接0.4，测量23欧，量程200欧”。记录表笔短接0.4Ω、A电机线束＋绕组回路23Ω、200Ω手动量程，取代上段仅有“相近”的定性判断。两者差值约22.6Ω，仅为扣除表笔后的粗算，不是厂家标定绕组电阻；该次读数显示回路导通，未显示明显开路或接近表笔短接的直接短接，不能据此证明电机绕组、换向器、机械或带载性能正常，也不能判驱动板损坏。

后续测量边界：普通DCV读到AIN1约1V不能区分真实PWM与异常的静态／失真电平，现有电阻和Vin读数也不能补齐这一缺口。下一步先确认现用万用表是否具有Hz频率／%占空比档，以决定能否在动力电池断开时粗测外部PWM；未确认仪表功能／输入条件前不安排频率接线或新试转。若无该功能，需要另选无动力静态输出诊断或借用波形仪器，不能将电脑测试、寄存器快照或平均值当作外部波形验收。保持全部供电断开、当前AO1／AO2动力线脱离驱动的检查状态，不自行重新接电池。固件、版本和产物未变化，仅本地保存记录。

### 主控接线自查续报与当前板内版本核对

主控按完整自查表再次反馈“我也查了一遍接线没有任何问题”。本次记录为主控逐项人工自查一致，不继续要求重认型号或重复检查整套接线；该反馈不自动代填逐线仪表导通或波形验收。没有新试转通过结果。当前持续版0x020B1001仍未取得主控回报的板内Watch版本，先核对当前实际应用身份、fault及滴答，再解释当前版本的PWM快照，不把此前500ms R3快照直接当持续目标的新实测。

本次只读发现Keil工程MotorContinuous的`TargetOption/Utilities/Flash1/UpdateFlashBeforeDebugging=1`。这是正常下载调试便利设置，但进入调试可能先重写Flash，故不能直接用该入口保留“原先板内应用”的身份。**本次只读核对前**，主控先保持驱动OFF、XT30／UC2／主板Type-C断开，仅恢复DAPLink原五线给主板供电；在Keil打开当前工程、选择MotorContinuous，进入Project → Options for Target → Utilities，取消 **Update Target before Debugging**，其余下载器与Debug设置沿用已确认CMSIS-DAP，不点Flash → Download。代理本次没有修改这个工程选项或访问板卡，是否已由主控取消仍待实际操作确认。

之后Ctrl+F5进入硬件调试，禁用原断点，打开View → Watch Windows → Watch 1，加入`g_motor_bench_revision`、`g_motor_bench_fault`、`g_motor_bench_ms`；勾选View → Periodic Window Update，按F5保持Run。若停在main入口，先运行再读，不将尚未初始化的0作为最终版本。此步不按KEY，动力电池始终拔开；回报版本原值、fault原值及间隔约1s的两次ms值，当前持续目标期望版本0x020B1001、fault=0、ms持续增长。若连接或运行提示异常，保存提示，不先补烧录或强改Watch变量。IWDG保留，长时间Stop／断点会改变运行或引发复位，故保持Run读取。

取消Utilities选项阻止进入调试时自动烧录的含义见[Keil官方MDK5入门手册](https://www.keil.com/support/man/docs/mdk_gs/gs_MDK5_5_en.pdf)Utilities dialog说明及[Keil官方应用笔记APNT208](https://www.keil.com/appnotes/files/apnt208.pdf)关于关闭automatic Flash programming的说明。不是关闭看门狗或更换调试链路，也不是不转根因结论。本轮仅本地记录与操作说明更新，固件／产物不变，没有新编译、烧录或上传。

### 当前持续版启动核对通过后的无动力PWM快照

主控对上一组Watch检查回复“完全符合期望”。据此记录当前持续版revision符合0x020B1001、fault符合0、ms持续增长均由主控确认；未另给两次ms原始数值或截图，不补填。当前应用身份与启动检查已有主控确认，不再重复索要同一组值；这不是电机起转或PWM外部波形验收。

下一步复用既有诊断，不改代码／频率／功率：驱动仍OFF、动力XT30始终拔开，主板仅由DAPLink供电，Keil维持F5 Run及Periodic Window Update、禁用断点，不点Download。在Watch新增`g_motor_bench_pwm_diag`。若当前因先前KEY停止而快闪锁定，仅在电池拔开时RST，再F5运行回待机；否则不必复位。待机每组1闪时，KEY长按约1–2s到常亮，松开后等约1s，再按一次KEY停止PWM并锁定；此处按KEY停止输出，不点Keil Stop暂停CPU，不在之后RST／断主板电，否则RAM快照清除。

在CPU继续Run时展开诊断对象的active并截图，必要时分图保存。以下仅为本代码路径的待对照值，不是已测结果；十六进制前导零省略不影响判读：

| 字段（均属于g_motor_bench_pwm_diag） | 一次A启用并按KEY停止后的期望 |
| --- | --- |
| enable_calls／enable_count | 各1；若此前已启用过，保留实际次数，不强改为1 |
| active.valid／active.mask | 1／1 |
| active.tim_cr1 | bit0=1，当前通常0x81；计数器仍可运行，不能据此认为停止失败 |
| active.tim_psc／tim_arr | 0／799（0x31F） |
| active.tim_ccer／tim_bdtr | 当前0x1111／0x8C00，分别包含普通通道使能和MOE |
| active.tim_ccr1／tim_ccr2／tim_ccr3／tim_ccr4 | 240（0xF0）／0／0／0 |
| active.gpio_moder | 四脚位掩码0x3CCC0000下应为0x28880000；无其他PE配置时整值即0x28880000 |
| active.gpio_afrh | 四AF域掩码0x0FF0F0F0下应为0x01101010；无其他PE高半组AF配置时整值即0x01101010 |

若active.valid=0或enable_calls=0，先保留完整诊断对象及live state／fault，检查是否真正松键进入RUNNING，不反复触发。若MOE、CCR或GPIO字段不符，保留实际原值定位对应板内边界，不用期望值覆写。若全部符合，也只说明当前持续版板内配置路径符合；不能单据此排除固件其他问题、确认引脚实际波形或判定驱动坏。停止帧仍由既有程序保留，可随后核查；本步先收active原始截图。未取得本轮快照前不标为通过，不连接动力。仅保存本地文档，无新编译或板卡操作。

### 当前持续版活动帧已收到：2026-10-24

主控连续提供两张Watch图，原样归档于[本次证据](../../testing/2026-10-24_motor_continuous/watch/README.md)。第一张request／enable／active.valid均0，代表未取得快照，不能把其中全0字段解释为实际寄存器全0；第二张已为request_count／enable_calls／enable_count=1、active.valid=1、state4／fault0／mask1。实际TIM1 CR1=0x81、PSC0、ARR0x31F、CCER0x1111、BDTR0x8C00、CCMR1／2均0x6868、CCR1–4为0xF0／0／0／0；GPIOE MODER0x28880000、AFRH0x01101010、ODR0、IDR0x271、时钟使能符合。当前持续版的板内A启用路径与配置已有原始图支持；仍不称外部PWM实测通过或固件所有问题已排除，ODR0在AF模式不构成无输出证据。

第二张stop_count=0、stop_ms／elapsed_ms／stop_reason为0，尚无本轮停止证据；elapsed_ms仅在停止时更新，不将其0值视为运行计时失效。下一步只在动力电池保持拔开时按一次KEY停止，维持CPU Run、不暂停／复位／断主板电，回报stop_count／stop_reason及stopped展开截图；正常待对照值为1／2、stopped.valid1、MOE0、四CCR0及GPIO低。不能拿10-21旧R3停止帧替代本轮。代理本次只读取及归档图片、更新本地记录，没有改代码、编译、烧录或上传。

### 当前持续版KEY停止帧已收到：同日续报

主控第三张图已补齐同次停止，原图及逐字段判读见[配对证据](../../testing/2026-10-24_motor_continuous/watch/README.md)。request／enable／stop各1，stopped.valid1／run_id1／state6／fault0／mask1；start_ms0x68366、stop_ms0xBA250、elapsed_ms0x51EEA（335594ms），实际软件差值相等，stop_reason2为KEY。stopped.BDTR=0x0C00（MOE0）、CCR1–4全0、GPIOE MODER0x14440000／ODR0／IDR0x75，四控制脚已为GPIO低；AFRH仍为0x01101010及CR1仍0x81均符合停止保留配置的设计，不解释为仍输出PWM。335.594s仅是无动力指导下的软件事件时差，不当作外部脉冲测量或动力堵转许可。

至此当前持续版的板内启用／KEY停止配对核对完成，未发现明确端口、AF、CCR或启停使能错误；仍不能证明外部排针波形、驱动VM／功率输出或电机起转正常，也不能排除固件其他问题。下一步不重复同组Watch或整套接线，先确认现用万用表有无Hz／%功能，再选择无动力外部测量；无此功能时再准备静态信号诊断或借波形仪器，不擅自改频率／功率或给动力。本轮只归档截图、核对数值、更新本地记录；固件／产物不变，无新编译、烧录或上传。

### 实验室示波器准备：同日续报

主控表示“我可以去实验室查看示波器”，据此改为准备[第一轮无动力示波器测量单](../../hardware_preparation/motor_scope_check.md)及[待填结果表](../../testing/2026-10-24_motor_continuous/scope_results.md)，不再因万用表有无Hz档阻塞准备。仪器型号／探头／可借用条件仍待实验室确认，尚无实测结果。第一轮仅在动力电池始终拔开时比较PE9和驱动AIN1，普通探头地夹只接公共GND，不接AO1／AO2；先冻结示波器保存实际波形，对照名义0–3.3V、20kHz／30%，不能复制预期值代替实测，再按KEY停，结束断主板电。沿用当前目标与程序，不重烧录／改参数、不测功率输出、不顺手给动力；示波器型号明确后可按实际面板说明操作。本轮只保存本地准备文件，没有操作仪器或板卡。

### 主控要求先不用PWM：独立电机直流诊断

主控最新提出“先用最简单的方法……不用pwm……直接给电”。本轮优先准备[A电机独立直流起转步骤](../../hardware_preparation/motor_dc_check.md)，先验证电机本身能否起转，暂不新增固件目标或把既有30%程序改成满功率。方法为全断电后把A电机六芯线在驱动端全部脱开，仅M1／M2接实验室限流电源；7.4V、初始限流1.0A、人工OUTPUT短时约0.5–1s后关断，编码器四线独立绝缘。7.4V为厂家推荐，限流／时长为本次工程诊断选择，不保证在限流条件下一定起转。该独立连接没有KEY／看门狗自动关断，不能把固件保护当成仍有效；实际供电由现场人员控制，代理不操作。实验室电源条件及起转结果待主控回报，若不具备则先返回条件，不用主板GPIO供电或裸线碰接电池替代。原程序、产物、接线资源及示波器方案保留；本轮没有改代码、编译、烧录或上传。
