AgrumeStly/yeye/project_planning/tasks/G-04.md

# G-04：正式版本上传与台式机Codex接续

日期：2026-10-25（北京时间）。负责角色：主控／03 GitHub与多设备同步。
依据：主控本轮要求“把所有内容上传github，当前版本是正式版本，已经很符合预期”，并要求台式机更新文档后继续使用台式机Codex。

## 本次范围与授权

保存并上传当前全部非忽略项目文件，包括Direct A/B、PWM重写、Keil工程、测试、实物验收记录、项目规则和技能。使用现有分支 `codex/current-version-20261025`，创建附注标签 `formal-2026-10-25` 固定本次正式快照。此处正式版本表示主控确认的当前项目基线；具体实测范围仍以模块证据为准。

本次不改业务实现，不合并main、不创建GitHub Release、不发送跨聊天消息、不操作台式机或板卡。主控后续在台式机修改的新内容是否上传，按后续明确要求执行。

## 已确认事实与验证范围

- 来源目录：`D:/projects/projectsyeye`；设备：`JokeBearDesktop`；开始分支：`codex/current-version-20261025`；起始HEAD：`0f033c6f67e5d4bef27b1c5afdd9d7014ac0456d`。
- 远端：`https://github.com/AgrumeStly/yeye.git`。本次先Fetch再检查分支；默认main仍可能是旧版，必须按下文选择当前分支。
- 当前PWM软件与人工验收见 [C-02B-PWM-R4](C-02B-PWM-R4.md)、[PWM记录](../../testing/2026-10-25_motor_pwm/acceptance_record.md)；Direct A/B见 [Direct记录](../../testing/2026-10-25_motor_direct/acceptance_record.md)。保留旧失败记录及证据原文，不把文字确认补成仪器测量。
- 本次检查文件清单、差异空白、文本与文档链接、Keil工程XML、已有电脑模型回归及上传提交。未重新编译Keil或进行实物测试；此前构建日志随 `testing/2026-10-25_motor_pwm/software/` 上传。
- Git继续忽略 `control/build/`、本机 `uvoptx`、`uvguix`、DebugConfig等输出／设备配置。它们保留在来源机器；台式机保留自身配置，不复制覆盖。全局账号认证、用户插件与Codex会话数据库不属于Git项目文件。
- 详细本机上传核对输出保存在忽略目录 `tmp/g04_upload/`。最终提交、推送结果和远端分支／标签核对以实际Git结果及03最终回报为准；不为在正文写入自身提交号循环提交。
- 本轮重跑六个现有电脑测试脚本全部通过：协议55项、台架73项、启动154项／10场景、PWM168项／9场景、持续115项／7场景及启动154项、Direct A/B各52593次断言／9场景及启动154项。检查220份项目文件、81份Markdown的752个本地链接和4份Keil工程XML；未发现超100MiB文件或所查常见私钥／令牌模式。原始测试文本中的8份UTF-16日志保留原编码；GitHub教程中的冲突标记为已核对的教学示例，未当成真实合并冲突。
- 暂存检查仅在3份Keil原始构建日志的Program Size行发现工具输出的尾随空格，按原始证据保留；排除这3份日志后的暂存差异空白检查通过。未改写日志来消除格式提示。
- 台式机本轮未实际操作。历史设备 `DESKTOP-0HLUQN7`、目录 `D:/Projects/yeye`；实际目录、分支、完整提交与Codex绑定仍须在台式机核对。

## 台式机已有仓库：更新步骤

先结束该目录内正在写文件、保存Keil工程或操作Git的工作。主控在台式机PowerShell逐项执行；目录不同则换成实际路径。

```powershell
Set-Location D:\Projects\yeye
git remote -v
git status --short --branch
git branch --show-current
git rev-parse HEAD
```

确认origin为 `AgrumeStly/yeye`。若出现 `M`、`??` 或暂存改动，先让台式机03保存并核对本地成果，再执行切换与拉取；不要用reset、clean或复制覆盖解决。工作区干净时继续：

```powershell
git fetch origin --tags
git branch --list codex/current-version-20261025
```

上条命令列出本地同名分支时，执行：

```powershell
git switch codex/current-version-20261025
git pull --ff-only origin codex/current-version-20261025
```

没有列出本地同名分支时，改为执行：

```powershell
git switch --track -c codex/current-version-20261025 origin/codex/current-version-20261025
```

最后核对：

```powershell
git status --short --branch
git rev-parse HEAD
git rev-parse origin/codex/current-version-20261025
git rev-parse 'formal-2026-10-25^{commit}'
```

刚取得本次版本时，三个完整提交号应与本轮最终回报一致，且工作区干净。标签固定正式快照；以后分支继续开发时，HEAD可比标签更新，此时用 `git merge-base --is-ancestor formal-2026-10-25 HEAD` 确认包含正式基线，退出码0表示包含。若拉取无法快进，保留现场交03核对本地提交，勿强推或强制覆盖。

## 台式机尚无仓库

安装Git后，在目标目录尚不存在时执行；已有工程用上一节：

```powershell
New-Item -ItemType Directory -Force D:\Projects | Out-Null
git clone --branch codex/current-version-20261025 https://github.com/AgrumeStly/yeye.git D:\Projects\yeye
Set-Location D:\Projects\yeye
git fetch origin --tags
git status --short --branch
git rev-parse HEAD
```

## 台式机继续使用Codex

1. 打开台式机现有Codex客户端，按需要完成登录。添加／打开本地项目文件夹 `D:\Projects\yeye`，选择本地运行（界面可能显示Local或This computer），确认聊天实际工作目录是这个仓库。已有项目绑定正确则继续使用，无需重复安装。
2. 台式机原有00／01／02／03对话可见且工作目录正确时，直接在对应对话继续；看不到旧对话时，在该本地项目内新建对话，按原职责接续。Git同步项目文件，不能据此推定另一设备聊天历史已经迁移；项目文档和任务文件用于恢复上下文。
3. 仅维护文档不需要先安装或配置Keil。代码编译、下载器、串口和芯片支持包按 [control/README.md](../../control/README.md) 另行核对。`AGENTS.md`、`.agent/skill/`和`.agents/skills/`已在仓库内；用户级插件及认证按台式机现状使用。
4. 台式机原00可粘贴下面内容；如新建对话，主控明确“接续现有00职责”后再沿用该职责，不另建第二套全局记录。

```text
主控已在笔记本确认当前版本为正式版本，并要求在台式机继续维护文档。
先核对本聊天工作目录、origin、当前分支、完整HEAD、工作区和正式标签formal-2026-10-25。
当前正式版本所在分支为codex/current-version-20261025，不要按旧main继续。
读取AGENTS.md、project_planning/collaboration_standard.md、project_planning/project_status.md、project_planning/tasks/G-04.md、project_planning/tasks/C-02B-PWM-R4.md及testing/2026-10-25_motor_pwm/acceptance_record.md。
按原对话职责接续。若本聊天为现有00，请核对PWM及Direct原始证据，顺序更新全局摘要中已过时的电机状态；保留历史失败和测量边界。主控已确认本次PWM流程符合预期，无需重复询问已确认的验收结果。
后续文档更新按模块权威来源和任务文件落地，保留台式机现有改动与下载器配置。先完成本地文档维护及检查；主控另行明确要求上传新改动后再提交推送。本次不自动烧录、试车或发送跨聊天消息。
```

若使用台式机已安装的Codex CLI，在该项目目录运行 `codex` 即可。

## 后续两台电脑怎样同步文档

开始工作前，在工作区干净时Fetch并仅快进当前分支。主控让Codex改完文档并检查后，若需要传到另一台电脑，明确说“把本轮文档修改提交并上传当前分支”。上传完成后，另一台电脑再Fetch／Pull。已有本地修改或提交分叉时先保留并核对，不同时在两台机器改同一份文档后强推。

本次固定标签保留不移动，后续提交继续在当前分支推进。主控可向现有00提供本任务路径，由00更新全局摘要。

官方依据（2026-10-25核对）：[本地运行环境](https://learn.chatgpt.com/docs/environments/modes)、[Windows客户端](https://learn.chatgpt.com/docs/app/windows)、[项目与聊天](https://learn.chatgpt.com/docs/projects)、[AGENTS.md](https://learn.chatgpt.com/docs/agent-configuration/agents-md)。菜单名称随客户端版本可能不同，以选择台式机实际本地仓库为准。
