AgrumeStly/yeye/.agents/skills/grill-me/SKILL.md

---
name: grill-me
description: Default project intake. Assess each project request and automatically interview about material unresolved planning or design decisions; execute clear requests directly.
---

Read ../../../.agent/skill/grill-me/SKILL.md (relative to this directory) and follow those instructions.
