AgrumeStly/yeye/report/README.md

# 报告与答辩

保存项目报告、答辩演示及正式提交材料。当前尚无正式报告。

按需创建 `source/`（报告生成器）、`assets/`（报告插图）、`release/`（按版本归档的最终提交包）、`archive/`（被替代稿件）。

项目排期放 `../project_planning/`，原始测试证据放 `../testing/`，开发代码仍保留在各模块目录。
