AgrumeStly/yeye/competition/README.md

# 比赛资料

保存主办方发布的原始规则、补充通知、正式赛程与报名凭据。当前原文为 [比赛文档.pdf](比赛文档.pdf)。

完整可检索转写见 [比赛文档.md](比赛文档.md)，含原通知全部正文、赛道原图和评分表。2026-10-26 已逐页核对原 PDF 共 6 页；转写说明及原文 SHA-256 见文末。赛道图保存在 `assets/track_figure_1.jpg`，从 PDF 直接提取。

项目必须执行的比赛依据与得分目标见 [AGENTS.md](../AGENTS.md)：比赛相关要求必须符合比赛文档，一切改进以提高比赛总分为目的。各任务在自身目标和验收中写明对应条款／评分项、得分收益或避扣分理由、验证指标和证据；本入口仅链接规则，不另建一套比赛标准。原文未明确的计分细则保留为待核实，队内测试指标须明确身份。

团队制定的进度安排放在 `../project_planning/`，不要混入官方资料。

2026-10-25主控确认报名已完成且保存成功凭据，见[报名状态记录](registration_status.md)。本轮未查看凭据附件，原赛事规则与后续正式通知仍分别保留。
