AgrumeStly/yeye/vision/README.md

# 视觉与语音开发

- `PORTING_REVIEW.md`：现有算法的移植审查与实现建议。
- `reference_code/`：原始C示例及头文件，尚未形成可直接运行的车载工程。
- `references/`：图像处理辅助文档。
- `data/`：样本与示例数据，当前包含二值图像表格。

新增可运行视觉代码放 `src/`，语音代码放 `audio/`，需要时创建。参考代码与正式实现分开保存；图像样本可按场景在 `data/` 下分类。整车试跑证据统一放 `../testing/`。

## 2026-10-25主控确认的进度

视觉已经能采图，尚未发送结果包；这是主控本对话确认，实际可运行采图脚本、固件环境与实拍样本尚未归档到本仓库。是否已有路径特征提取及语音运行结果未在本轮确认，不据采图能力推定通过。

下一项按[V-01](../project_planning/tasks/V-01.md)：复用采图成果，先提供按唯一[20字节协议](../control/docs/protocol_v1_draft.md)发送的固定测试包与样例，再接真实图像特征；固定／真实结果分开留证。视觉内部实现由视觉负责，02接收串口联调，主控继续编码器任务。
