AgrumeStly/yeye/hardware_preparation/i05_motor_power_diagnosis_task.md

# I-05：电机无动作的电气定位

日期：2026-10-21。状态：主控已转交02，测量说明与待填结果表已本地保存；现场无万用表，测量尚未开始。02负责组织、操作说明与证据，硬件负责仪表准备和电气测量，01在证据指向固件时处理实现。生成任务不代表已经发送消息。

## 已知事实与边界

- 型号沿用：天空星STM32F407VET6青春版、AT8236 Standard／YB-MNT03-V1.0、MD310Z20_7.4V双电机。主控确认按清单购买、接线无问题，不再要求型号识别或一套接线照片。
- 主板由DAPLink单源5V供电；驱动由独立2S电池供电，两板共地，不并联5V／3V3。
- 15%／500ms首次A无转动。01交付R2固定30%／20kHz／500ms，00核对代码、编译及产物一致；主控回报本轮Verify OK、绿灯正常，再按R2单次A步骤回报“完全没动，也没声音”。本轮灯态推进、Watch版本、实际Vin和波形未额外回报，不补写通过。
- 电池已与UC2断开、完全冷却且无鼓包／异味／接头变形，依据主控确认；这不代替电压或容量测量。UC2曾本体特别烫，继续停用，不能据此认定电机故障根因。
- 当前停止动力试转，要求驱动OFF、拔XT30；是否已经断开仍等主控实际执行，不从收到指导推定已执行。禁止继续B／AB、反复触发或再加占空比、延长脉冲、直接短接电池到电机、绕过保护。

依据：[现象记录](../testing/2026-10-21_motor_bench/no_rotation_record.md)、[R2交付](../control/docs/motor_bench_r2_task.md)、[接线标准](wiring.md)、[引脚资源](../control/docs/pin_plan.md)、[当前操作](../control/docs/motor_bench.md)。

## 执行要求

1. 先读AGENTS、默认技能、协作标准、状态及上述模块文件。保留当前代码／分支，先准备具体可执行的测量表和纯图形操作，不再修改PWM参数。现场无仪表，02先完成说明，硬件借用万用表；尚无仪表时明确等待实测，不用模拟结果代替。
2. 第一阶段不触发电机：优先测电池静置电压及极性，再在正确电压测量档下测驱动Vin+/Vin−实际电压及开关前后状态；测点和正常范围先用既定板卡官方资料核对，并引用页码／图。分清电池端、驱动输入与内部供电，禁止把Vout当5V入口。先定位明显供电缺失，不先要求示波器。
3. 主控是初学者，02须说明仪表插孔／电压档、参考地、可安全接触的测点和接线先后；严禁将电流档跨接电池、带电测通断或移动线束。硬件协助避免探针短路；本任务单不替代经板卡资料确认的现场测量步骤。不得为了观察电源灯而额外触发电机。
4. 供电若不符合资料，停止并依据具体证据提出修复，不提前认定电池没电、驱动损坏或线接错。记录数值、档位、测点、动力开关状态与版本。
5. 供电符合后，再计划控制输入与输出的同步测量。R2只有500ms／20kHz，普通万用表单次读数可能漏过或只是平均值，不能用显示0或无声音判定无PWM。若需要示波器／逻辑分析仪，由硬件准备，明确触发／捕获及安全接地；驱动输出属于H桥，不能随意用接地探头夹输出端。实际受控脉冲另形成测量步骤，保持人工触发、30%／500ms和停止保护，不擅自重复试转。
6. 若无动力Keil Watch确有必要，仍按原纯GUI方法，在电池拔开时确认版本0x020B0002、ms、fault及状态；不在动力接通时暂停／单步，不强改Watch值。软件读数不代替管脚波形。
7. 由电池→驱动输入→MCU及驱动输入→H桥输出逐段缩小范围；能定位到一个边界才提出下一动作。不要写成所有器件都已坏或全套换件。涉及固件的明确证据返回00，00再给01任务。

## 交付与授权

02先交付测量清单、官方测点依据、需要硬件提供的仪表及结果表。真实测量完成后在testing/2026-10-21_motor_bench/下补充带版本结果，00核对后更新进度。未测项目标待测，报告事实与推断分开。

仅本地文档与只读核对获授权；不自动操作板卡／仪表、烧录、驱动电机、改固件、提交／上传或跨聊天发送消息。实体操作由主控与硬件按明确步骤执行，当前任务不是自动复测授权。

## 02准备交付（2026-10-21）

- [初学者测量步骤与测点依据](i05_measurement_guide.md)：仪表插孔／DCV、探头布置、M01电池→M02驱动OFF的Vin→M03驱动ON的Vin，无KEY触发；结果分支、后续静态轨与条件式波形设计，保留R2。
- [待填结果表](../testing/2026-10-21_motor_bench/i05_measurement_results.md)：实测、开关与电源状态、仪表设置及证据分开填写，当前所有实测保持待测；未来动态捕获另由00安排，不把本版说明当新脉冲授权。
- 沿用既定型号与主控接线确认，不再次索取全套照片。当前仅完成准备，未取得电压／波形或根因结论，硬件借到表后先返回M01–M03。
