AgrumeStly/yeye/competition/registration_status.md

# 报名状态记录

日期：2026-10-25（北京时间）。记录：00项目总指挥，信息来源：主控本对话反馈。

主控对“报名是否已经完成并保存成功凭据”明确答复：“已完成并有凭据”。据此将报名提交及凭据保存记为主控确认完成，不再列为今天的待提交阻塞。

本轮未提供或查看凭据附件，尚未归档具体报名编号、提交时刻或正式队长身份，不补造上述信息；这不改变主控已经明确确认的完成事实。后续若需正式材料核对，引用实际保存的凭据，不要求重新提交报名。

项目原通知记载截止为2026-10-25 23:59；该日期作为历史规则保留，主控确认的报名状态与赛事群后续通知分别记录。
