AgrumeStly/yeye/docs/tasks.md

# 当前任务与对话入口

日期：2026-10-25（北京时间）。维护：00。

- [当前状态与任务清单](../project_planning/project_status.md)：唯一全局进度／阻塞索引。
- [任务文件规则](../project_planning/tasks/README.md)：一个任务保存目标、范围、授权、结果和验收，不另建重复看板。
- [协作标准](../project_planning/collaboration_standard.md)：00统筹、01固件、02整车、03版本与设备交接。
- [四对话完整接续Prompt](../project_planning/agent_initialization_prompts.md)：角色和当前任务一起加载。
- [ORG-02分层目录迁移](../project_planning/tasks/ORG-02.md)：本轮实际迁移、路径映射及验证。

明确的主控模块任务可直接找01，现场装配和联调找02，跨模块取舍回00。文件存在不代表已发消息、已开工、已上板或已验收。
