AgrumeStly/yeye/project_planning/collaboration_standard.md

# 项目协作标准与对话登记

版本：v2.1。更新：2026-10-25（北京时间，补ORG-02分层目录）。维护：00项目总指挥。
依据：主控原有职责决定，以及本轮“保留现有00”“实际整理管理文档”的确认。实施记录见[ORG-01](tasks/ORG-01.md)。

## 1. 项目怎样借助多个对话推进

文件保存项目事实；长期对话保持职责与工作连续性；任务文件连接一次具体工作与结果。目录按业务模块组织，同一技术事实只设一个维护入口。

主控可直接向01／02提出范围清楚的模块任务；新需求取舍、优先级、接口变化、全队依赖和整体验收进入00。执行对话保存结果后，由主控让00读取任务文件即可，无需再拼接全部历史。

00负责安排与核对证据，主控个人负责主控和最终集成；视觉负责采图、识别、K230D／CanMV与语音；硬件负责器件、结构和供电准备。管理全队任务不改变三位成员的实现责任。正式队长身份与报名另核实。

## 2. 固定职责与实际对话

以下原名和ID于2026-10-25通过Codex对话工具核对。登记身份不代表对话已经重新加载本版规则。

| 现有对话原名 | 固定职责与输出 | 主要写入范围 | 转出条件 |
| --- | --- | --- | --- |
| 00 项目总指挥 | 目标、优先级、排期、依赖、接口协调、风险、证据核对与验收；生成完整任务Prompt | `project_planning/`全局记录及报告统筹 | 固件实现→01；现场整合→02；版本同步→03 |
| 01 主控固件开发 | SPL／Keil工程、UART、电机、编码器、闭环、动作与故障状态机；模块学习和调试说明 | `control/`及所领任务单 | 跨板接线、仪表与真实表现→02；范围或接口取舍→00 |
| 02 整车联调与拼组 | 接收三方交付，组织装配、供电测量、跨板通信、悬空及跑圈验证，保存失败与复测 | `hardware_preparation/`、`testing/`及所领任务单 | 可复现主控缺陷→01；视觉／硬件内部问题→对应角色，经00协调 |
| 03 GitHub与多设备同步 | Git状态、获授权的提交／上传／PR／合并、设备与环境交接 | 版本记录及任务范围内的Git操作 | 代码逻辑冲突→模块负责人；功能验收→00／02 |

实际ID：

- 00：`01a14d0a-72a4-7202-ba48-4e091608e265`
- 01：`01a14d20-031c-7f50-9862-3224b49eab0f`
- 02：`01a14d20-8fe4-7d93-81ae-766498c0862f`
- 03：`01a14d28-5be8-7d73-9967-2da2936a8edc`

本轮体系整理对话：`01a17113-7922-74d3-88f3-51d038b8e353`，承担ORG-01及主控随后明确要求的ORG-02目录迁移；交付后回到现有00，不自动接替总指挥。读到本文件不赋予任何新对话00身份，身份由主控当前指派决定。

旧对话“项目初期-硬件准备”保留采购历史，相关当前工作进入02／硬件。其余旧规划或环境对话按成果归属查文件，不建立第二套全局记录。归档聊天由主控另行决定，本轮未归档、改名、创建或发送聊天消息。

### 按需使用的临时对话

只有存在独立产出时才拆出临时审查、研究、报告或专题学习对话。每项写明任务ID、读入版本、输出文件及结束条件；结束后留下结果即可。纯审查默认只读，修复回原执行负责人。视觉、硬件若自行使用Codex，可采用同一任务格式维护其模块；主控侧不为凑齐对话数量接管其实现。

## 3. 哪类信息以哪里为准

| 信息 | 唯一主要入口／维护者 |
| --- | --- |
| 比赛硬约束、正式时间与报名凭据 | `competition/`原文与正式通知；正式队长确认 |
| 工作区规则及授权边界 | 根目录`AGENTS.md`；主控本轮明确指令优先 |
| 对话职责、交接方式与文档效力 | 本文件；00维护 |
| 当前全项目结论和有效任务 | [project_status.md](project_status.md)；00汇总证据 |
| 一项工作的目标、允许范围、执行结果和验收条件 | 新任务`tasks/<ID>.md`；现有任务可沿用已归档原文件，状态页只链接 |
| 原目标、里程碑与历史投入假设 | [project_plan.md](project_plan.md)及其生成源；实际进展另看状态 |
| 视觉→主控结果包、未来动作反馈 | [protocol_v1_draft.md](../control/docs/protocol_v1_draft.md)；主控维护、视觉共同确认、硬件复核电平 |
| MCU资源分配／实际接线 | [pin_plan.md](../control/docs/pin_plan.md)／[wiring.md](../hardware_preparation/wiring.md)；01维护资源，02记录实物并由硬件复核 |
| 当前主控实现和操作入口 | [control/README.md](../control/README.md)及其技术说明；01维护 |
| 主控软件验证／首次板级实测 | [validation.md](../control/docs/validation.md)／[board_self_test_record.md](../hardware_preparation/board_self_test_record.md) |
| 视觉实现、环境与移植边界 | [vision/README.md](../vision/README.md)导航；视觉维护，PORTING_REVIEW为历史审查 |
| 实物清点、装配、供电、测量方法 | [hardware_preparation/README.md](../hardware_preparation/README.md)导航；硬件提供、02接收；清点表尚待建立 |
| 现场发生了什么、哪个组合通过 | [testing/](../testing/README.md)内带日期、版本的记录；02留证 |
| 哪个设备持有什么版本 | [version_handoff.md](version_handoff.md)；03实际检查后记录 |
| 报告可引用的结果 | [report/](../report/README.md)引用原始证据，代码／参数仍留模块 |

协议与引脚沿用原路径。共同确认后，在原文件写版本、日期、角色、适用范围与未测项；冻结约定与实物通过分别记录。根docs/interfaces.md提供C模块API和跨板协议导航，不复制整套字节包规格。

ORG-02已按主控确认把STM32工程分层放在control内；新工程位于control/MDK-ARM，Core、App、Drivers_Custom、Drivers、Algorithms、Tests的边界见[架构](../docs/architecture.md)。根docs按主题导航，当前状态仍在本目录，实际硬件和测试证据原位保留。[ORG-02](tasks/ORG-02.md)记录新旧路径与验证；历史任务里写的旧工程路径按该映射接续。

已确认按清单采购的型号继续沿用，只有具体替换或不符才核实差异。型号确认、导通、电压、运行效果分别留证；照片没有铭牌不把型号重新写成未知。实物清点的采购角色和保管角色分开记录。

## 4. 一项任务怎样闭环

1. **立项**：主控提出需求；00处理跨模块或重大未决选择，清晰模块任务由对应对话直接执行。先查已有记录，只询问影响下一步且无法自行取得的信息。
2. **领任务**：读取规则、当前状态、任务单和相关模块说明；检查目录、分支、HEAD及已有修改。跨轮或跨对话任务采用[任务模板](tasks/README.md)，保留既有ID，先写清验收范围。
3. **执行**：任务负责人修改授权范围，保存代码／资料与适当验证。新主应用代码采用详细中文注释，Keil／SPL及人工操作习惯按AGENTS。
4. **回写**：模块负责人保存详细证据，并在任务单写完成／未完成、版本、验证方法和下一步。全局状态由00顺序汇总，执行对话不同时争写状态页；若主控明确指定执行者更新摘要，先确认独占写入。
5. **核对**：主控向00发“读取任务ID／文件路径”。00读取成果和必要原证据，分别判断软件交付、板级结果、整车验收与主控实际体验；未达标则在同一任务保留差距。
6. **继续**：无需换对话的修正继续原任务；需要另一个职责时，00给出合并最新约束的完整Prompt。无后续任务时明确结束，不制造新待办。

状态页只保留摘要、依赖和证据链接。长现场流水进入`testing/`，详细实现进入模块文档，历史全局流水进入`archive/`。归档保持原日期、原失败与授权范围。

任务主状态采用原计划的“未开始／进行中／待验收／完成”；阻塞另列原因，来源不足时标“待核实”。完成必须写明完成的是资料、软件还是实物，不用“通过”概括不同层次。“继续”、无回复、跨对话自报完成均不算主控验收。

## 5. 共享目录、并行和Git

当前日常模式为同一checkout顺序写入；多个聊天不会自动隔离文件或当前分支。允许并行只读调查，写入前明确当前负责人和范围；同一文件一次一个写入者。Keil工程保存、构建、Git分支切换、烧录和硬件操作分别顺序执行。

需要并行开发时，使用独立worktree，记录来源提交、实际目录、未提交改动处理、工具依赖、合回负责人和检查。不能假设worktree自动具有本地未提交源码、被忽略的uvoptx／build／原图。两份MotorDirect工程共享输出目录；同一checkout不并行构建。功能依赖尚未具备时，用模拟包或离线样本推进，并标明模拟边界。

默认保存并验证本地。上传当前改动、合并、发布按本次实际授权分别执行；历史G-01／G-02及人工教程不是新任务授权。生成Prompt或登记任务不等于已发送、已开工、已烧录或已上传。跨聊天发送仍须主控本次明确授权；本体系默认文件交接、主控触发读取。

换电脑时，03核对实际目录、分支、完整提交、未提交／未上传项、被忽略但需另存的证据和环境。Git文件一致不能证明IDE、驱动、板卡与车辆验证一致。

## 6. 冲突与历史内容

事实按来源类型判断：规则查原文，约定查共同决定，实现查对应代码，效果查对应版本实测。日期较新本身不决定效力。

- 文档与代码冲突时，分别记录约定、当前实现、影响与修复负责人。
- 没有找到证据写“未归档／待核实”；从源码确证缺失才写“未实现”。
- 历史操作页有旧端口、供电、采购或上传表述时，先由模块入口确定适用页；有未解决冲突时暂停依赖该冲突的现场动作，由责任角色校正，独立工作继续。
- 生成内容先查[内容源表](../DIRECTORY_GUIDE.md)，修改源后才重生成、检查PDF。历史采购和原计划保留，不因当前状态变化改写原日期。
- 新文档注明日期、维护角色、依据、适用范围和待确认项；导航只链接事实源，不再复写所有参数。

## 7. 本体系的使用与检查边界

四个现有对话的完整接续Prompt见[初始化与接续](agent_initialization_prompts.md)。新对话只需加载所属角色和当前任务相关材料，不要求每轮重读全库。

本轮已审查整理前52份正式Markdown、17份PDF共96页及相关生成源／配置。PDF正文完整读取，全扫描板卡13页及视觉图示页补充渲染查看；其余PDF未重新逐页做排版验收。完整清单、发现和本地检查见[体系审查](organization_review.md)。未重新验证固件、远端、板卡或整车；规则已保存不等于主控使用体验已通过。

Codex能力边界参考[OpenAI Docs：AGENTS.md](https://learn.chatgpt.com/docs/agent-configuration/agents-md)、[执行环境](https://learn.chatgpt.com/docs/environments/modes)、[Worktrees](https://learn.chatgpt.com/docs/environments/git-worktrees)。具体职责与流程为本项目选择。
