AgrumeStly/yeye/project_planning/tasks/C-02E.md

# C-02E：双轮直行测试与输出修正

日期：2026-10-30（北京时间）。主状态：待验收（软件交付完成，实车待验）。责任角色：主控／01；主控人工验证，02可接收实车证据，00汇总全局。

## 当前接续：3秒直行修正版0x020E0002

主控本轮原始反馈：“现在车子会拐弯，右轮转速偏快”，要求只直行3秒并留出左右轮速度偏移调试变量。这是上一版试车出现跑偏的现场文字反馈，未提供精确转速、计时、停车或录像，不补填相关验收。

当前交付替代下方历史快慢要求：恒定前进3000ms后撤驱动；`straight_test.c`提供`volatile int32_t g_straight_trim_permille = 20`。单位为0.1个百分点，正数降低右轮、负数降低左轮；默认左50%／右48%，只作为右轮偏快的试调起点。每次启动读取并锁定、限幅到±基准，各轮输出0..50%，不提高旧输出上限；按键停止、看门狗及异常保护保留，版本升为`0x020E0002`。这次主控明确要求的3秒试车仅用于本独立工程，不改C-02D的台架约束。

验证：ARMCC5.06u5零错误零警告，Code4816／RO424／RW56／ZI1056；BIN SHA-256 `8c913d58a821e6768b577032f3714056100fcf02a99c39b2b7d3f8047f03ce81`。纯逻辑覆盖3000ms、回绕、参数正负／极值／启动锁定、按键及终态；集成模型7场景90项通过，确认独立左右PWM、极性、自动撤驱动、非法输出与故障锁定。方法、日志、调参示例和Keil步骤见[当前模块说明](../../control/docs/straight_test.md)。软件证据不表示新版实车已走直。

本轮仅本地改代码、检查、构建和文档，未下载、启动电机、提交或上传。下一步由主控重新编译下载，先验证方向和3秒撤驱动，再固定场地／电池条件，每次改变修正5–10并记录跑偏方向和横向偏移。比赛收益仍对应基本功能60分的完赛／触边／出界风险控制，实际收益待现场对比；全局状态留00读取后汇总。

## 首版历史：快1秒／慢1秒0x020E0001

以下记录保留首版授权、软件结果及当时未测边界；当前固件参数与接续要求以上方3秒修正版为准。

依据：主控本轮要求“现在测试小车是否能跑直线，写一个两个快速前进1s慢速前进1s的程序”；按双轮快1秒、慢1秒连续执行实现。主控补充：“左轮（先转的）朝车头、右轮（后转的）朝车尾”。

## 目标与授权

新增独立StraightTest工程，双桥同时50%运行1000ms、30%运行1000ms后撤驱动并锁定。人工长按松开启动，保留运行KEY停止、启动限时、看门狗及异常保护。当前前进极性采用MotorPwm顺序A左朝前／B右朝后，因此反转B桥。保留已有六目标、MotorPwm和EncoderBench。不启动C-02D闭环及协议变更。

本次授权：本地实现、构建、电脑验证及操作说明。未烧录、未操作动力、未提交、未上传、未跨聊天发送。原C-02D的单轮500ms限制不被改写，本次主控明确要求的2秒双轮测试仅属于本独立工程。

## 验收与得分依据

比赛第三部分项目要求及评分表：基本功能60分，自动顺时针一圈、用时不超过5分钟，触边扣分、完全出界失败。本次发现左右动力／转向差异，支撑减少触边和提高完赛率；没有直接或实测加分结论。相关规则、赛道及评分读取与边界见[模块证据](../../control/docs/straight_test.md)。

软件验收：零错误零警告；双桥方向／PWM正确；快慢各1000ms、2000ms撤驱动；短按不启动、运行KEY停止、完成锁定、故障零输出；保留既有目标文件。实车验收另需两轮朝车头、两段快慢及自动撤驱动、平地跑偏情况与录像。不把电脑模型作为直行实测；队内未设官方不存在的偏移阈值。

## 执行结果

- 工程：[straight_test.uvprojx](../../control/MDK-ARM/straight_test.uvprojx)；应用：`control/App/Diagnostics/straight_test.c/h`；入口：`control/Core/Src/straight_test_main.c`；硬件适配：`control/Drivers_Custom/Motor/straight_pwm.c/h`。新主应用代码采用中文说明，继续SPL。
- 操作、参数、版本、软件方法、日志位置和实车回报要求集中在[straight_test.md](../../control/docs/straight_test.md)，模块入口已加导航。
- ARMCC5.06u5零错误零警告，BIN SHA-256 `47b41a76abbc043d00ac9914079f473d22c1df2d965b70ffa00d7d09a5527588`。纯逻辑检查及集成模型5场景61项通过。原工程与驱动文件未改，不宣称已重新构建所有旧目标。
- 实物结果：尚未烧录本程序；主控方向反馈属于此前MotorPwm旋转，不能外推本次双轮地面直行或停车已验收。
- 下一步：主控按模块说明Keil下载，先悬空验证双轮前进和撤驱动，再地面记录跑偏。00可读取本任务汇总，本轮不改全局状态页。

## 接续位置

目录`D:/projects/projectsyeye`；分支`codex/current-version-20261025`；来源HEAD `9520eeb481169f88146afe541b4d53617c7728eb`。开工已有`control/docs/validation.md`、`testing/README.md`未提交及`testing/2026-10-30_new_board_flash/`新板记录，本轮保留这些共享修改，未覆盖。当前新增固件／文档均只保存在本地；构建产物、本机uvoptx及日志受Git忽略。
