AgrumeStly/yeye/project_planning/tasks/V-01.md

# V-01：已有采图成果归档与结果包发送交付

日期：2026-10-25（北京时间）。主状态：未开始（本次发送交付任务待主控转交）；已有能力：主控确认视觉已经能采图，尚未发送结果包。责任：视觉实现／交付，00汇总，02接收联调。生成Prompt不代表已发送或已开工。

## 已确认事实与缺口

主控明确反馈：“已经能采图，尚未发送结果包”。沿用现有采图成果，不重新安排从零采图；尚无是否已完成路径特征提取的确认，不能从能采图推定已能循迹。仓库vision/目前仅归档C参考、移植审查与离线样本，实际采图脚本／环境／样本仍待视觉提供。

主控侧已有20字节协议解析，UART默认关闭、真实互通未验收；两马达分别PWM起转与自动停转已通过，主控下一步做C-02C编码器。视觉发送器可以同步推进，不等待速度闭环。

## 目标、交付与验收

1. 复用并归档已有K230D／CanMV采图程序、实际固件环境、启动入口与少量实拍样本，按vision/README.md放置，已有成果不重写。语音进展与附件情况另列，不阻塞本次串口最小链路。
2. 与主控对照唯一control/docs/protocol_v1_draft.md确认UART与20字节协议；布局、单位／正负号、序号、有效标志、CRC及节奏有差异先列出，不自建重复协议或擅自宣布冻结。
3. 第一阶段在视觉板实现最小发送器，先发送明确标注模拟的固定路径／无效路径等测试帧，交可执行脚本和十六进制样例、发送周期／序号行为；这用于02检查字节接收，不代表实际视觉识别通过。START／STOP样例按协议提供，车辆动力断开时测试，代理不自动发送会启动实车的命令。
4. 固定包链路可验证后再接真实图像特征。若路径提取尚未实现，明确其缺口及后续计划，不用固定偏差冒充视觉实拍结果；丢线需按约定发新序号无效包，不能无限复用旧路径。
5. 视觉交真实／模拟分别标明的代码、输入样本、处理耗时、发送间隔及原始日志。02后续验收固定包、CRC／序号、START／STOP和无效／超时行为；本任务的发送软件检查与真实跨板接收分别记状态。
6. 视觉负责图像、CanMV发送及语音内部实现，主控只接收接口／验收并维护STM32侧，硬件协助供电／电平／结构。不得因主控在开发编码器而让主控代做视觉。

## 接续与本次授权

00本机目录D:/Projects/yeye，分支codex/current-version-20261025，基线HEAD 0b0343577895d8eb03a337165da6ce9c5e433519。视觉若在另一设备／目录，先记录实际位置与获取来源；00本轮新任务尚未上传，不假定文件自动共享。主控可转交下方完整Prompt，缺任务文件时建立相同V-01，不新造重复ID。

当前00只保存任务和交接要求；主控转交后允许视觉按角色本地实现与验证，结果回写本任务和vision/，全局摘要由00更新。无代理自动上传、跨聊天发送、烧录、驱动车辆或发送真实启动命令授权。共享写入、Keil构建与硬件操作按协作标准顺序协调。

## 给视觉的完整Prompt

执行V-01：复用已有采图成果，实现最小结果包发送与交付。主控已确认视觉能采图、尚未发送结果包；不要从零重做采图，也不要将采图能力写成循迹／串口已经通过。

先读项目AGENTS.md、project_planning/collaboration_standard.md、tasks/README.md、tasks/V-01.md（若已同步）、vision/README.md、PORTING_REVIEW.md和唯一control/docs/protocol_v1_draft.md。主控侧基线为codex/current-version-20261025、HEAD 0b0343577895d8eb03a337165da6ce9c5e433519，00本机D:/Projects/yeye；不同设备使用实际Clone路径，保留已有改动。新任务未上传时可按本Prompt建立同一V-01。

先归档能运行的K230D／CanMV采图程序、固件环境、入口和实拍样本。随后实现与现有20字节协议兼容的最小发送器：先固定路径／无效路径等模拟包，提供十六进制样例、递增序号、CRC、发送间隔与日志；参数按协议逐项确认，差异返回00，不另建最终协议。固定包成功后再接真实路径特征，若尚未实现特征提取则明确差距，固定数据不得冒充真实识别。START／STOP样例供02在车辆动力断开时做链路验证，不自动启动实车。

视觉负责具体采图、识别、发送和语音实现，硬件负责供电／电平与附件；主控侧并行C-02C编码器，不接管视觉。只本地保存代码、运行说明和证据，真实／模拟、软件／实物结果分开记录；不自动上传、跨聊天消息、烧录或操作车辆。结果写回同一V-01任务，交00读取并安排02联调。
