AgrumeStly/yeye/project_planning/tasks/G-03.md

# G-03：当前完整版本上传与笔记本Codex接续

日期：2026-10-25（北京时间）。负责角色／执行对话：主控／03 GitHub与多设备同步。
依据：主控本轮要求“把当前版本全部上传github，在我笔记本上clone时，我怎样才能直接继续用codex工作？”

## 范围与授权

本次授权保存并上传当前项目全部相关成果，包括10-18以来的固件、硬件与测试证据、ORG-01管理资料及ORG-02目录迁移。保留这些已有成果的内容与原验收边界，不把上传或构建成功写成主控已验收。

本次上传任务分支 `codex/current-version-20261025`，未包含合并main、发布、跨聊天发送或板卡操作授权。Clone时显式指定该分支即可取得本轮完整版本。远端默认main可能仍为旧版，不能省略分支后按旧目录继续。

## 已确认事实与待确认项

- 台式机：DESKTOP-0HLUQN7，D:\Projects\yeye；开始时main、HEAD为82640aba4cf7aa4f30db14b486aef852936118fe，联网核对远端main同号；大量后续成果尚未提交。
- 开工保存191份非忽略现存文件的路径、大小和SHA256快照，用于检查上传过程中是否被其它工作更改；删除旧路径与新增路径须一起入库，不能仅上传新目录。
- 项目默认grill-me及grilling的正文已在 `.agent/skill/`；其4份Codex发现入口位于 `.agents/skills/`，原被忽略，Clone时会缺失。本次只放行这两项项目技能，继续忽略其它本机配置。
- Obsidian共享设置随项目保留；`.obsidian/workspace*.json`为本机窗口缓存，新增忽略但不删除。账号、令牌、`.codex/`、编译输出、下载器本机配置及tmp原始日志不自动上传。
- 笔记本未实际检查。设备名、实际目录、Git账号、Codex登录／插件、编译器、IDE、芯片包、驱动及串口均待核实；台式机上传成功不等于笔记本已同步。

## 本次交付

1. 将当前固件分层、SPL及六目标、电脑测试、硬件资料、原始实测图片／记录和现有文档一并保存到任务分支。
2. `.gitignore`仅放行两项项目技能发现入口，继续排除本机账号与缓存。
3. 本任务记录笔记本Clone、Codex加载项目规则和恢复模块上下文的方法；[版本交接记录](../version_handoff.md)保存设备边界；全局状态留给00接收后顺序汇总。

## 验证与实际结果

2026-10-25在台式机重跑现有六个电脑测试脚本：55项协议／状态机、73项台架逻辑、154项／10场景启动、131项／8场景PWM诊断、持续A的113项／7场景及154项／10场景启动、Direct的52593次断言／9场景及154项／10场景启动均通过。断言数量不是独立场景数量。

提交前审计200份待上传现存文件：75份Markdown、707个本地链接、167份文本编码、189项Keil工程／Include引用和16项SPL来源清单哈希均通过；没有匹配到所查常见令牌／私钥模式。厂家stm32f4xx.h含原始非UTF-8字节，按来源清单SHA256确认原件并保留，没有转码。git diff --check通过，六个Keil目标全部0错误0警告。开工191份文件中，除本轮明确修改的.gitignore、README及版本交接记录外，全部原始内容哈希保持不变，包括本机Obsidian窗口缓存。

具体上传完整提交、远端同号核对和全新Clone验证以03最终回报为证。日志在本机被忽略的tmp/g03_upload；这些检查没有连接板卡、烧录、驱动电机或新增实车验收。

主控对ORG-01／ORG-02实际使用体验以及MotorDirect真实起转的反馈仍未取得，不因本轮上传改变原状态。

## 笔记本首次取得版本

先安装Git并确认能访问仓库。在PowerShell中执行；D:\Projects\yeye必须是尚不存在的新目录，已有工程不能覆盖：

```powershell
New-Item -ItemType Directory -Force D:\Projects | Out-Null
git clone --branch codex/current-version-20261025 https://github.com/AgrumeStly/yeye.git D:\Projects\yeye
Set-Location D:\Projects\yeye
git branch --show-current
git rev-parse HEAD
git status --short --branch
```

预期分支为codex/current-version-20261025，完整HEAD与03最终回报一致，工作区无修改。首次认证按GitHub自己的登录窗口完成，不在聊天中填写令牌。已有Clone则先保留修改，再Fetch、切同名分支并仅快进；遇到分叉保留现场交03。

## 笔记本如何直接接续Codex

1. 安装并登录笔记本的Codex客户端。在项目入口添加／打开本地文件夹D:\Projects\yeye；已有项目的菜单中可用Edit project／Add folder设置该文件夹，并将它设为primary。界面不同则以选择本地项目目录为准，不能只打开GitHub网页。
2. 在该项目内创建本地聊天，确认聊天工作目录指向笔记本实际Clone位置。Codex从该目录发现AGENTS.md及项目技能；项目规则、任务、模块文档随Git恢复。全局个人偏好、账号认证、用户技能／插件及连接器权限仍按笔记本安装情况核实。
3. Git传递项目文件，不传递Codex会话数据库。旧对话能否显示及其工作目录是否适用要在笔记本实际检查；即使旧对话不可用，新对话也可读取仓库文件继续。共享文档中的对话ID是历史登记，不自动创建聊天或改变角色。
4. 若继续主控固件，直接向笔记本项目内的新聊天粘贴下面完整Prompt；不必把所有历史聊天重新复制一遍。若继续协调／联调／同步，使用[职责接续Prompt](../agent_initialization_prompts.md)中相应角色，保留已有00的总协调身份。

```text
本对话在主控笔记本承担01主控固件开发的接续工作。当前项目为本聊天绑定的yeye本地Clone目录；来源分支codex/current-version-20261025。先自行核对实际目录、远端、分支、完整HEAD、未提交改动，并读取AGENTS.md、project_planning/collaboration_standard.md、project_planning/project_status.md、project_planning/tasks/README.md、project_planning/tasks/G-03.md、project_planning/tasks/ORG-02.md、docs/architecture.md及control/README.md。

沿用STM32F407、SPL、Keil5及现有六目标；工程已迁到control/MDK-ARM/yeye_control.uvprojx，MotorDirect独立入口是同目录motor_direct.uvprojx，不恢复旧firmware/src工程。算法、应用与驱动按现有分层继续。协议及现场证据保持现有权威路径。

先报告现有实现、已验证范围、待实测和笔记本工具环境差距；优先复用已有配置与实测记录，不要求主控重新报已确认型号。当前MotorDirect实际起转仍未验收，组织／迁移实际体验亦待主控反馈。00继续总协调，不能因为读取文档自认00。详细结果写任务或模块证据，由00顺序更新全局状态。

本轮先只读恢复上下文并给出当前最小接续动作；不自动烧录、上电、驱动电机、切换正在使用的共享分支、上传、合并、发布或发送跨聊天消息。后续按主控当前明确任务执行。
```

若用Codex CLI，安装登录后在项目目录运行 `codex`，或运行 `codex --cd D:\Projects\yeye`。无需使用API开发的场景不要求为此创建API密钥。

## 环境与交接边界

Codex能阅读修改项目不要求已配置Keil；实际编译、下载和调试另按[主控入口](../../control/README.md)核验Keil5.24a、ARMCC5.06u5、STM32F4xx_DFP2.17.1及已确认CMSIS-DAP链路。电脑模型测试需要gcc。现有setup_debug.ps1是旧双目标模板，不保证六目标调试自动配置齐全；不要覆盖已有uvoptx。

笔记本完成后，主控向03提供设备名、目录、分支、完整HEAD、工作区状态与环境检查结果，03再将待确认项更新为实际结论。原始tmp日志、编译输出和用户级Codex配置并不在此Git版本内，需要时单独核对；无需复制整个.codex或认证缓存。

官方依据：[项目与聊天](https://learn.chatgpt.com/docs/projects)、[AGENTS.md](https://learn.chatgpt.com/docs/agent-configuration/agents-md)、[本地技能发现](https://learn.chatgpt.com/docs/build-skills)。本项目具体职责及上传边界以本轮主控要求与AGENTS为准。
