AgrumeStly/yeye/project_planning/tasks/ORG-01.md

# ORG-01：项目文件与Codex对话协作体系整理

> 后续更新：主控已明确要求并确认ORG-02物理分层。此任务保留当时管理文档范围和验收记录；现行工程路径及最新完整交接使用[ORG-02](ORG-02.md)。

日期：2026-10-25（北京时间）。主状态：待验收（本地体系已落地，主控实际使用体验待反馈）。
执行：本轮体系整理对话；接收与后续维护：现有00项目总指挥。

## 依据、已确认选择与范围

主控要求分析怎样合理利用Codex各个对话构建项目，在阅读项目全部文档后构建文件与对话体系。本轮主控明确确认：

1. “采用推荐方式，保留现有00”：现有00为唯一总指挥；明确模块任务可直接找01／02；任务与结果存文件；体系整理完成后返回现有00。
2. “采用推荐范围，实际整理管理文档”：保留固件工程、技术协议、原始证据路径，实际整理导航、协作规范、任务入口和历史。

现有三位成员的主控／视觉／硬件实现责任不变。Codex对话不是额外团队成员或独立工程副本。清晰的文件整理已获本轮授权，不另要求主控逐文件批准。

## 目标、允许修改与验收

- 复用00／01／02／03，写明职责、写入范围、转交条件和实际对话ID，消除共享文档自称“当前对话就是00”的身份误用。
- 首页和模块入口按使用场景导航；任务、规格、当前状态、历史和实测证据各有明确维护位置。
- 当前状态保留有效结论，原状态流水与目录快照完整归档；修正已有证据与旧摘要不一致处，不补造实测。
- 提供可直接复制给四个现有对话的完整接续Prompt、任务模板及给00的独立交接。
- 验证文档链接、编码、冲突标记、差异格式、归档完整性及已有非本轮文件保护情况。

本次授权仅含本地文档整理、读文件／读现有对话和适用检查。未授权本轮远端上传、发布、合并、跨聊天发送、归档旧聊天或实物操作。未创建新用户聊天。

## 执行结果与证据

正式结果入口：

- [协作标准](../collaboration_standard.md)：四对话职责、实际ID、权威来源、任务闭环、共享checkout与授权。
- [当前状态](../project_status.md)：最新有效摘要、任务与日期；G-02已有结果和本地合并证据已核对，笔记本仍待确认。
- [完整接续Prompt](../agent_initialization_prompts.md)：四个现有对话可独立采用，任务已明确时不再停在只读初始化。
- [任务模板](README.md)：目标与结果放同一任务文件，由00按证据汇总。
- [体系审查与逐文件阅读清单](../organization_review.md)：52份原正式Markdown、17份PDF共96页及生成源／配置；列明仍未修的技术文档与环境问题。
- [目录与内容源](../../DIRECTORY_GUIDE.md)：业务目录、工程入口、生成源和本机文件边界。
- [原状态快照](../archive/2026-10-25_project_status_snapshot.md)、[原目录快照](../archive/2026-10-25_directory_guide_snapshot.md)：保留整理前记录，仅改归档后的显式相对链接。

本轮检查结果以[审查记录的检查段](../organization_review.md#本轮验证)为准。已存在的固件编译／电脑模型结果仅复核文档，不算本轮重新运行。软件、下载、板内、电气、机械与整车结果分开记录。

保留项：全部固件／测试源码、Keil配置、工具、生成器、PDF、接线／协议正文、原始照片与已有现场记录。本轮补主控和硬件README场景导航及测试入口，未修技术实现。原技术文档、调试模板的遗留问题另列，不宣称已经修复。

## 接续位置与未完成

目录：D:/Projects/yeye。分支：main。完整HEAD：82640aba4cf7aa4f30db14b486aef852936118fe。

该HEAD之外存在原有固件／文档与本轮管理资料的未提交修改；不能用HEAD代表当前全部工作文件。本轮没有切分支、提交、推送或合并，也没有改全局Git信任设置。原Git所有者保护以单次safe.directory参数处理。

待主控实际体验：四个现有对话采用本版职责后，是否能按任务ID直接接续、是否减少重复报事实与复制Prompt、是否仍出现两个对话争写状态或混用旧步骤。保存并通过静态检查不自动等于这些体验验收通过。

当前技术事实：MotorDirect独立工程入口已由01修复，版本0x020B2001；代码和电脑验证有记录，下载／无动力演练／实物起转回报仍缺。原电机无动作根因没有结论。报名与三方实物进展仍由00按证据跟进，本轮未重新排期。

## 可直接交给现有00的完整Prompt

```text
任务：接收ORG-01项目文件与对话体系整理成果，继续担任原有“00 项目总指挥”。
项目：D:/Projects/yeye。主控已于2026-10-25明确保留现有00为唯一总指挥，本轮体系整理对话只负责ORG-01，不替代00。

先读取：
1. AGENTS.md与.agent/skill/grill-me/SKILL.md。
2. project_planning/collaboration_standard.md。
3. project_planning/project_status.md。
4. project_planning/tasks/ORG-01.md。
5. project_planning/organization_review.md。
6. project_planning/agent_initialization_prompts.md及tasks/README.md。
7. 按当前技术问题再读control/README.md、hardware_preparation/README.md和对应实测证据。

已确认的体系：文件保存事实；00安排与验收；01固件；02实物与整车联调；03按需负责Git和设备交接。明确模块任务可直接进入01/02，跨模块/接口/范围/排期由00处理。任务与结果放同一任务文件，状态页只保留摘要，长历史已归档。主控只提供任务ID/路径时，00自行读取，不要求重贴全部回报。

当前版本基线为main、HEAD 82640aba4cf7aa4f30db14b486aef852936118fe，但有大量原有及本轮未提交修改。保留它们，不按HEAD假设工作区干净。体系已本地落地，静态检查范围和未修技术问题看审查记录；主控实际使用尚未验收。工程、协议、接线正文、PDF及原始证据路径保留。

已核对03的G-02历史完成回报和本地PR#2合并提交，不代表本轮联网复核或笔记本同步。MotorDirect独立入口已修复，0x020B2001，尚无下载/演练/起转新回报；旧PWM与持续版未转，不能判电机损坏。报名凭据和三方当前进展仍待证据，不把原计划日期算作完成。

本次只要求接收体系并给出当前项目判断、主要阻塞和一个最小下一步；有必要分配时提供包含最新约束的完整Prompt。不要重复整理一套体系、重跑未受改动的固件测试、自动安排新的试转或改动固件。需要技术/工具修订时先区分审查记录中的组织新增、技术文档缺陷和环境问题。

默认本地保存和适用核对；本条不授权上传、合并、发布、跨聊天发送或板卡操作。00更新自身后续任务和全局摘要时顺序写入，保留其它工作。确认已采用本版职责及文件入口，并指出还需主控实际反馈的部分；无需把历史全部抄回状态页。
```
