AgrumeStly/yeye/control/docs/protocol_v1_draft.md

# 视觉 → 主控：结果包协议 v1 草案

制定日期2026-10-12。主控代码已按本草案实现，视觉确认量纲与发送方式后再冻结；硬件确认电平、共地与引脚。正式共同接口后续只保留一份，本文件目前为主控实现配套草案。

## 字节布局

建议UART 115200、8N1、3.3V逻辑电平，TX/RX交叉、共地。固定20字节，不传整幅图像。多字节字段均小端，无浮点，无文本换行。

| 偏移 | 长度 | 字段 | 含义 |
| --- | --- | --- | --- |
| 0 | 2 | 帧头 | A5 5A |
| 2 | 1 | version | 固定1 |
| 3 | 1 | type | 1路径；2命令 |
| 4 | 1 | payload_length | 固定12 |
| 5 | 1 | sequence | 每种type独立计数，0..255循环 |
| 6 | 1 | flags | bit0路径有效，bit1终点候选；其他位0 |
| 7 | 1 | confidence | 0..100，视觉质量分，不宣称统计概率 |
| 8 | 2 | error | int16，-1000..1000，右为正。目标中线相对图像中心的偏差 / 图像半宽 ×1000，限幅 |
| 10 | 2 | heading | int16，-9000..9000，单位0.01度，右为正；当前控制未使用 |
| 12 | 2 | bend | uint16，0..1000，视觉定义的弯道强度，非物理曲率；>500演示降低基础请求 |
| 14 | 2 | processing_ms | uint16，0..1000，本帧处理耗时；超过100ms不能用于启动/保持运行 |
| 16 | 1 | command | 路径包固定0；命令包1启动、2停止、3状态查询 |
| 17 | 1 | reserved | 固定0 |
| 18 | 2 | crc16 | 对0..17字节计算CRC；低字节先发 |

CRC-16/CCITT-FALSE：poly0x1021、init0xFFFF、refin/refout=false、xorout0。标准校验向量ASCII `123456789` 得0x29B1。

命令包除offset16的command外，offset6..17均为0。置信度、方向和弯道特征的算法定义由视觉与主控确认；字段暂未使用也不能改变布局。

## 主控接收行为

- 逐字节滑窗解析，处理分包、连包、噪声、截断和错误CRC；格式错误包不更新路径时间。
- 每个type只接受向前1..127的序号增量；重复/倒退包不刷新数据。视觉不可在短时间内跳过超过127号。
- 一个type静默≥200ms后允许重建序号基线，用于板卡重启；车辆仍需新启动命令。本协议不抵御恶意重放。
- 合法STOP包始终停机，重复或旧STOP也生效；新STOP序号阻止之前延迟到达的START重新启动。
- START仅在已有有效路径、置信度≥40、处理耗时≤100ms、本地路径接收年龄<200ms时成功。
- RUNNING收到新无效/低质量路径立即FAULT；没有新鲜路径达到200ms则FAULT，左右请求归零。恢复数据不自动启动。
- STATUS当前仅解析，无回包或语音应答；终点候选仅记录，不自动认定跑完一圈。

200ms、100ms、40及转向比例均为待实测参数，不能据此认定实车已停稳。processing_ms不含完整采集/排队延迟，端到端延迟需上板实测。

## 示例与视觉交付

有效直道路径，seq1、置信度80、处理20ms：

```text
A5 5A 01 01 0C 01 01 50 00 00 00 00 00 00 14 00 00 00 92 01
```

启动命令seq1：

```text
A5 5A 01 02 0C 01 00 00 00 00 00 00 00 00 00 00 01 00 4D 12
```

停止命令seq2：

```text
A5 5A 01 02 0C 02 00 00 00 00 00 00 00 00 00 00 02 00 BB 88
```

视觉参考 [Python编码器](../tools/protocol_example.py)。电脑运行只输出十六进制和.bin文件，不向串口发启动命令；CanMV发送接口由视觉按固件适配。丢线仍发送新序号的无效包，避免无限复用旧路径。

建议路径约50Hz，命令仅在事件发生时发；这些是目标，尚未板上验证。先用模拟样例核对字节，再连接真实UART。
