AgrumeStly/yeye/project_planning/archive/2026-10-25_project_status_snapshot.md

> ORG-02补记：随后主控明确授权物理目录迁移，本快照仅将已迁移文件的显式链接目标转向新位置，历史正文／日期／授权含义不改写。新旧路径见[ORG-02](../tasks/ORG-02.md)。

> 历史快照：2026-10-25组织整理前的原文。原始位置：`project_planning/project_status.md`。仅为保留当时记录；其中“当前”“下一步”和授权均属原记录时点。现状读取[项目状态](../project_status.md)，规则读取[协作标准](../collaboration_standard.md)。正文仅调整显式相对链接以适应归档位置。

# 当前状态与任务

最后核对：2026-10-24（北京时间，01补充MotorDirect固定GPIO单次诊断代码及电脑验证，实物待主控）。汇总：00项目总指挥。依据：本地工作区、现有验证记录及主控汇报。

本文件是项目当前状态的统一入口。维护方法见 [对话分工与标准文档](../collaboration_standard.md)。状态摘要链接原始证据，详细技术参数留在所属模块。

当前协作方式：00项目总指挥统筹整个项目的目标、任务、排期、接口、风险和验收；01负责主控固件开发，02负责整车联调与拼组，03负责GitHub与多设备同步。主控个人负责主控与最终集成；视觉、语音具体实现归视觉，硬件准备归硬件。主控向00汇报需求或成果，00核对记录并生成可复制Prompt，由主控转交执行对话或对应角色。

## 1. 当前判断

项目已具备主控基础工程，首次板级双闪自检已有通过记录。下一阶段是实物/接线核对、跨板串口与电机/编码器基础验证。现有证据尚不足以认定W1整车目标完成。

视觉正式程序、整车接线与跑圈结果尚未在当前仓库归档；这不表示视觉或硬件在其它电脑上没有开展工作。

## 2. 模块状态和证据

| 范围 | 可确认状态 | 证据／边界 | 下一步与负责角色 |
| --- | --- | --- | --- |
| 硬件采购／到货 | 2026-10-11确认已购买、10-14确认主控部分到齐；10-18确认按原清单采购；10-20主控确认硬件已到齐 | [硬件导航](../../hardware_preparation/README.md)、[采购型号确认](../../hardware_preparation/wiring.md)；电机MD310Z20_7.4V、驱动AT8236 Standard／YB-MNT03-V1.0、天空星STM32F407VET6青春版；主控到齐汇报不代替逐项电气验收 | 沿用既定型号完成I-04接线，不重复询问；实际差异再登记 |
| 主控基础工程 | SPL工程新增MotorDirect固定GPIO，只A人工一次500ms，原五目标保留，现为六个Keil目标 | [主控导航](../../control/README.md)、[MotorDirect说明](../../control/docs/motor_direct.md)；无TIM1／AF／PWM，R1及人工停止／超时锁定保留 | 主控当前简化试验选择MotorDirect，下载及首次演练拔动力电池；不将台架视为整车程序 |
| 电脑端验证 | 2026-10-24六个Keil目标均0错误0警告；MotorDirect实际main／GPIO模型9场景、R1启动154项／10场景通过；原持续113项、启动154项、R3诊断131项、台架73项回归通过 | [软件验证记录](../../control/docs/validation.md)、[MotorDirect交付](../../control/docs/motor_direct.md)；旧MotorBench／MotorContinuous BIN逐字节不变；协议55项为既有记录，本轮未重跑 | 电脑验证不证明排针电平或起转；主控先无动力确认500ms后锁定，再仅一次悬空A；实际结果待回报 |
| 主控实物自检 | 2026-10-14 USB DFU写入及1868字节读回一致；主控确认双闪正常 | [板级实测记录](../../hardware_preparation/board_self_test_record.md)；只覆盖记录列出的基础检查 | 主控后续验证SWD、UART及真实外设；已有双闪结果可作为历史起点 |
| 视觉→主控串口 | 20字节结果包已有主控实现；协议仍为草案；UART默认关闭 | [协议草案](../../control/docs/protocol_v1_draft.md)、`control/firmware/include/board.h`；无实际互通记录 | 主控与视觉共同确认协议，硬件复核接线，再做固定包联调 |
| 电机、编码器与闭环 | 原PWM台架与持续A均未起转；活动／停止板内快照配置符合，外部波形未测。新增MotorDirect只A固定电平500ms，电脑完成、实物待验；编码器／闭环未实现 | [新目标](../../control/docs/motor_direct.md)、[持续版Watch证据](../../testing/2026-10-24_motor_continuous/watch/README.md)、[原R3记录](../../control/docs/motor_bench_r3_task.md)；不认定不转根因或电机损坏 | 主控按新目标无动力演练、一次悬空A后OFF拔电池；不转不继续B／AB或延时；彻底隔离电机仍需独立限流电源条件 |
| 视觉与语音 | 当前仓库为C参考代码、移植审查与一张60×94二值样本；尚无 `vision/src/`、`vision/audio/` 正式实现 | [视觉导航](../../vision/README.md)、[移植审查](../../vision/PORTING_REVIEW.md) | 视觉补充实际板卡/固件状态及已有成果，优先归档采图脚本和样本 |
| 结构、供电和接线 | I-03及C-02A资源已采用；主控确认动力、电机及九线正确；DAPLink单源5V供主板、独立2S供驱动；2026-10-24回报电池7.4V、Vin OFF 7.4V／ON 7.56V | [接线核对v0.3](../../hardware_preparation/wiring.md)、[接线指南](../../hardware_preparation/dual_motor_wiring_guide.md)、[I-05电压反馈](../../testing/2026-10-21_motor_bench/i05_measurement_results.md)；另收到驱动5V/3V3均正常反馈、未报具体值；未确认运行掉压、内部VM或PWM | 不重复索要照片或型号；静态供电反馈已收到；先确认硬件波形仪表条件，保持两板共地且不并联稳压输出，不触发试转 |
| 整车联调与测试 | `testing/`已有MotorBench原版下载及启动故障证据，无归档的跑圈或整车故障停车证据 | [测试目录](../../testing/README.md)、[启动问题及证据](../../control/docs/motor_bench_startup_issue.md)；基础板级自检另存硬件目录 | 主控补R1自主启动证据，后续跨板联调另建带版本记录，硬件与视觉补证据 |
| 报告 | `report/` 当前只有说明文件，无正式报告 | [报告目录](../../report/README.md) | 三人持续保存模块素材，主控到集中写作阶段汇总 |

## 3. 日期与计划

日期全部为2026年北京时间。以下来自本地比赛原文和原计划，没有将内部目标重新承诺为新工期。

| 节点 | 原定日期 | 当前证据状态 |
| --- | --- | --- |
| W1：装车、供电、电机、采图、协议确定 | 10/18，内部默认21:00 | 只可确认上述已归档部分；完整验收待三人补证据 |
| 内部报名检查 | 10/23 | 正式队长身份、是否已提交及成功凭据待核实 |
| 官方报名截止 | 10/25 23:59 | 本地比赛通知第4页；后续正式通知由正式队长核对 |
| W2：闭环、路径输出和实际串口链路 | 10/25 | 尚无完整链路测试记录 |
| 连续3次低速完整跑圈 | 11/01 | 队内目标，尚无试跑归档 |
| 冻结候选版本与报告终稿 | 11/29 | 队内目标，后续依据进展复核 |
| 现场验收 | 暂定12/05 | 本地比赛通知第4—5页，仍需赛事群后续确认 |

完整里程碑见 [原项目规划](../project_plan.md)。调整时同时保留原目标、预计完成日期、原因和确认记录。现有“规划主控硬件后续步骤”对话曾提出重估排期、计入学习排错、量化验收的三项问题，截至已读取记录未见主控答复，仍为待讨论建议。

## 4. 当前任务与交付依赖

以下任务从已有实施规划提取，不表示已经开工或重新承诺截止日期。正式执行时更新状态、时间和证据。任务状态沿用原计划的未开始／进行中／待验收／完成；进展未知时单列“待核实”。

00统一跟踪全部任务。P为项目协调项，C/I为主控及联调项，H/V由硬件/视觉负责，G为版本与设备交接项。跟踪全队进度不改变主控个人的实现职责。

| ID | 主责 | 任务与完成标准 | 当前状态 | 依赖／证据位置 |
| --- | --- | --- | --- | --- |
| P-01 | 主控（信息汇总） | 由00整理三方已验证进度、交付差距和阻塞，提出项目排期建议；主控核实无法从文件取得的现场事实。报名交由正式队长确认，不默认主控担任队长 | 待核实 | 原项目规划；状态表本节及日期表 |
| H-01 | 硬件 | 建立实际器件清点记录，包含采购角色与当前保管角色、订单/照片、缺项、验收情况 | 待核实 | 建议交付 `hardware_preparation/hardware_inventory.md`，尚未创建 |
| H-02 | 硬件 | 记录供电与信号接线；主控核对MCU资源，视觉核对视觉端接口和姿态 | 待实物核对；I-03已建立资料草案 | [接线草案](../../hardware_preparation/wiring.md)；硬件尚未签核线束导通/供电；[候选引脚](../../control/docs/pin_plan.md)未冻结 |
| C-01 | 主控 | 明确SWD/板上观察条件；核实HardwareBench在真实板上运行及复位后零请求 | 待核实 | [实施步骤第2步](../../hardware_preparation/control_bringup_plan.md)；DFU双闪不替代该目标验证 |
| V-01 | 视觉 | 归档当前固件版本、采图脚本、实际图像及音频附件缺项；如已有程序，保存运行入口 | 待核实 | [视觉导航](../../vision/README.md) |
| I-01 | 主控 | 与视觉共同确认唯一协议；硬件复核后完成固定路径包、START、STOP、无效路径及超时联调，保存版本和结果 | 待核实 | H-02；[协议草案](../../control/docs/protocol_v1_draft.md)；新记录放 `testing/` |
| C-02 | 主控 | 确认驱动真值表和资源后实现单轮/双轮悬空受控转停，随后标定编码器 | C-02B已交付独立PWM台架代码及电脑验证；真实转停待验收，编码器未实现 | C-02A、I-04；[台架说明](../../control/docs/motor_bench.md)；后续实施按新端口，不沿用历史PA0/PA1编码器候选 |
| I-03 | 主控（由02整理，硬件复核实物，01确认资源） | 核对电机、AT8236与天空星接口，输出逐线表、证据与01资源要求；接线冻结须有硬件与主控签核 | 资料整理验收通过；00已回填C-02A资源至wiring v0.3，实物接线签核待I-04回报；未上电 | [逐线接线草案](../../hardware_preparation/wiring.md)、[返回00/01交接](../../hardware_preparation/i03_handoff.md)、[照片及SHA256](../../hardware_preparation/evidence/2026-10-18_i03/README.md)；采购型号采用主控按清单购买的确认 |
| C-02A | 主控（由01执行） | C-02前置：按既定型号确定四路电机控制、双编码器、UART/SWD的F407资源，更新pin_plan.md并返回02可用的接线端口表 | 资源设计完成，00已采用并回填接线表；实物接线未冻结 | [资源方案v0.2及八线表](../../control/docs/pin_plan.md)、[官方原图证据](../../control/docs/evidence/2026-10-18_c02a/README.md)；TIM1 PE9/11/13/14四PWM，TIM3 PC6/7与TIM4 PB6/7编码器；PA0保留按键；[接线表v0.3](../../hardware_preparation/wiring.md)已同步，未改固件或操作板卡 |
| I-04 | 主控／硬件装配，00指导与核对 | 完成动力、电机及主板九线；最新主板供电改为DAPLink 5V0→天空星5V，主板Type-C与DAPLink 3V3留空，驱动5V／3V3不接主板 | 初始动力及九线接好由主控确认；DAPLink五线供电／下载方案已给指导，改接完成及电压未回报；待机不闪仍待定位 | [接线指南最新选择](../../hardware_preparation/dual_motor_wiring_guide.md)、[DAPLink五线表](../../control/docs/motor_bench.md)；未认定电气验收或试转通过，排查期间电池XT30拔开 |
| C-02B | 主控（由01实现，02／硬件定位现场问题） | 首轮双电机开环台架固件与真实转停验收 | 原15%未转，R2单次A主控回报完全没动、无声音；根因未定，暂停动力复测 | [现象记录](../../testing/2026-10-21_motor_bench/no_rotation_record.md)；转I-05，先实测供电，不继续B／AB或提高功率 |
| C-02B-R2 | 主控（由01执行） | 保留R1及停止保护，固定30%／500ms诊断 | 软件交付通过；主控回报Verify OK、绿灯正常，但单次A完全无动作／无声音，起转验收未通过 | [R2交付](../../control/docs/motor_bench_r2_task.md)、[现场记录](../../testing/2026-10-21_motor_bench/no_rotation_record.md)；不再加占空比，板内Watch／电气波形仍无实测证据 |
| C-02B-R3 | 01实现，主控采集，00核对 | 保留实际PWM启用／停止寄存器快照，30%／500ms和R1保护不变 | 已取得首次A板内快照：请求／启用／停止各1，活动MOE1／CCR240，500ms后MOE0／CCR全0／GPIO低；板内路径符合，外部电气仍待测 | [三张原图及读数](../../testing/2026-10-21_motor_bench/r3_watch/README.md)；截图未含revision，不补造独立版本读数；保留R3，转I-05静态测量 |
| 持续A测试（10-24主控直接要求） | 主控／01实现，主控手动测试 | 独立MotorContinuous目标，KEY长按松开后只A桥持续30%／20kHz，再按KEY停止锁定，保留R1及诊断 | 电机未转；AIN1约1V／AIN2为0V、AO1−AO2约0.07V、Vin均7.54V、A回路23Ω；接线及当前版本／fault／ms由主控确认。板内A启用／KEY停止配对符合，未发现明确端口／启停使能错误。上一轮已准备独立电机直流方案；现主控暂不能去实验室，本轮新增MotorDirect见下一行，限流电源方案保留 | 原独立检查方案保留：[独立电机直流检查](../../hardware_preparation/motor_dc_check.md)：电池／主板全断电、A电机六线完全脱离驱动，仅M1／M2接实验室限流电源，7.4V／初始限流1.0A，人工OUTPUT约0.5–1s关断，回报实际V／I／CV-CC及转动；无固件自动停止，不裸线碰接电池。原[无动力示波器方案](../../hardware_preparation/motor_scope_check.md)、[板内证据](../../testing/2026-10-24_motor_continuous/watch/README.md)及固件保留；不自动操作板卡或上传 |
| I-05 | 02组织、硬件测量，00验收；01按证据修复 | 定位A无动作：先测电池／驱动输入，再测控制与输出边界 | 2026-10-24主控回报M01=7.4V、M02=7.4V、M03=7.56V，随后M04/05反馈均正常但未报具体值；静态供电无明显异常反馈，根因仍未定 | [测量步骤](../../hardware_preparation/i05_measurement_guide.md)、[电压及稳压轨反馈](../../testing/2026-10-21_motor_bench/i05_measurement_results.md)、[R3证据](../../testing/2026-10-21_motor_bench/r3_watch/README.md)；主控限定万用表；KEY后两闪及E2A/E1B为3.3V已归档，阶段后0V不证明无PWM；建议00转01准备无动力静态控制脚诊断，保留R3，不继续B/AB或自动触发 |
| MotorDirect（10-24主控直接要求） | 01实现，主控手动验证 | 无需PWM／示波器的原接线短时A试转：固定PE9高、PE11／13／14低，KEY人工一次500ms后锁定 | 本地代码、六目标编译及电脑模型通过；版本0x020B2001；没有下载、上电或实物起转结果 | 主控暂不能去实验室，按[纯Keil操作](../../control/docs/motor_direct.md)先电池拔开下载／演练；正常后悬空轮子只一次A，再OFF拔XT30。固定电平相当于满导通，强于30%PWM；失败不能单独判电机坏，不延时、不循环，不自动操作板卡或上传 |
| C-02B-R1 | 主控（由01执行） | 修复IWDG启动／配置／更新等待顺序及无超时阻塞；保留安全输出、看门狗与既有台架语义，交付新编译与验证及Keil复验步骤 | 代码与电脑验证完成；主控回报新版绿灯正常闪烁，原不闪症状已恢复；独立断电启动及ms／fault／stage具体结果待补，不代填通过 | [完整修复记录](../../control/docs/motor_bench_startup_issue.md)、[复验第11节](../../control/docs/motor_bench.md)、[现场记录](../../testing/2026-10-20_motor_bench/acceptance_record.md)；主控按清单确认运行与自主待机后继续C-02B，电机结果另验收 |
| G-01 | 主控（由03执行） | 上传当前协作规则、初始化Prompt、状态表及导航更新到GitHub任务分支，核对远端提交并提供笔记本接续步骤；主控已于2026-10-18明确授权上传当前改动，不含合并或发布 | 完成，00已验收；笔记本接续待确认，未合并main | 00于2026-10-18独立核对本地HEAD及git ls-remote，任务分支最终提交均为2e16e84205e5fc44440092935a2fbfb01abfc0fe；相对main共8份Markdown，2次提交；验收开始时工作区干净；详见[版本交接](../version_handoff.md) |
| G-02 | 主控（由03执行） | 将G-01文档及00本地验收、任务授权记录提交至任务分支，通过PR合入远端main，随后同步台式机本地main并核对；主控于2026-10-18明确授权“合并至main” | 进行中（03已接收，保存记录并推进PR合并） | 03重新联网确认来源分支2e16e84205e5fc44440092935a2fbfb01abfc0fe、远端main为9c2db9bcedf01e40dcfddde3ee7dfcc3b618cb0f；00验收及授权记录保留并纳入本次提交；[G-02交接步骤](../version_handoff.md)。合并及台式机main同步结果以03最终回报为证 |

## 5. 冲突、待确认和后续修订

| ID | 问题与依据 | 当前采用口径 | 处理角色及下一步 |
| --- | --- | --- | --- |
| D-01 | 采购方案有16字节/80ms等早期通信建议，后续主控协议为20字节/200ms过期判定 | 结果包实现以协议草案为入口；阈值仍待实测，尚未冻结 | 主控、视觉共同确认I-01；硬件采购文件中的旧算法参数仅供历史参考 |
| D-02 | 硬件聊天中讨论了取消额外电池检测、暂缓470μF、保留电机端100nF×2；采购PDF与生成源仍列原第18项 | 已有精简需求与建议，但实物最终清单尚未归档；不继续按旧PDF认定全部是现阶段必购 | 硬件通过H-01核实实际收到和采用项，主控确认功能范围，再决定是否生成新版采购清单 |
| D-03 | 聊天讨论了格氏800mAh 2S改XT30的替代电池；BOM仍为Tattu型号 | 现有聊天不足以证明最终实物品牌与标签 | 硬件归档订单、标签与接口照片，不把候选当成已收货型号 |
| D-04 | 旧GitHub教程写主控尚无完整工程，并含私有仓库、每次收工上传等历史表述 | 工程状态查主控README；上传规则查AGENTS；远端可见性以实际设置为准 | 主控后续修订教程Markdown并重生成PDF；本次未改该阅读版 |
| D-05 | 引脚候选及主控实施步骤含“实物未到货”等制定时起点，后续已有主控到货与双闪记录 | 历史步骤用于顺序，现状以实测记录和本状态表为准；候选引脚仍未冻结 | 主控、硬件在H-02确认后同步候选表状态和正式接线版本 |
| D-06 | 首次板级记录末尾写“等待上传”；后续规划对话记录了上传和合并 | 该措辞反映记录当时状态。G-01已联网核对远端main为9c2db9b，与本地main一致；新协作文档另行上传至codex/project-coordination | 设备接续按[版本交接](../version_handoff.md)核对；任务分支上传不表示已合入main或笔记本已更新 |
| D-07 | `control/stm数据手册.pdf` 文件名容易被理解为芯片完整数据手册 | 已逐页查看，为13页天空星开发板资源/产品资料；不作为芯片完整电气、时序或复用表的唯一依据 | 主控、硬件按实际芯片/板卡版本补充原理图及相应器件资料索引 |
| D-08 | 原计划要求10/18完成多项实物目标；10/14主控实施步骤估计约6个有效工作日完成基础控制，学习和排错未独立估算 | 证据未齐，保留原目标并注明差距；此前grilling提议尚未确认 | 主控在P-01核对事实后讨论预计日期、学习/实现/验证/返工时间及可测验收条件 |
| D-09 | 电机端与驱动口的功能排列不同，线束另一端尚待导通核对；厂家F103示例ADC用PA2，与本项目UART候选冲突。先前将照片缺铭牌写成型号未知，现已纠正 | 主控2026-10-18确认按原清单采购，型号沿用[接线表基准](../../hardware_preparation/wiring.md)；按功能核对线束，ADC本次不接，PWM采用[C-02A方案](../../control/docs/pin_plan.md) | 01已完成资源设计；硬件补两束线断电导通及供电证据，不重复要求主控确认既定型号；02回填接线并保留未实测状态 |
| D-10 | C-02A核对官方板级资料发现PA0连接WKUP用户按键；旧接线草案和历史实施步骤曾列PA0/PA1、TIM2编码器候选 | [pin_plan.md v0.2](../../control/docs/pin_plan.md)取消该候选，A桥改PC6/PC7、TIM3 AF2，保留PA0按键；B桥仍PB6/PB7、TIM4。四PWM采用TIM1 PE9/11/13/14 | 00于10-20回填wiring v0.3及首次接线指南，旧PA0/PA1接法失效；历史步骤的旧端口不得照接。硬件核对实际排针，资料设计不等于已改线或实测 |

## 6. 确认记录与更新方式

已确认的长期约定：角色称呼用主控、视觉、硬件；三人投入按每周约三个整天规划；项目默认使用grill-me；本地保存验证，上传由主控明确指示。分别以 `AGENTS.md`、原项目规划及对应历史对话为依据。

2026-10-18最新职责决定：主控明确00担任整个项目总指挥，并要求后续需求与成果统一向00汇报，由00生成任务Prompt分配给对应agent。执行对话统一为01主控、02联调、03GitHub与多设备同步。主控个人仍负责主控及最终集成，视觉、硬件保留各自实现职责。该决定替代此前限制00只做主控侧总览的表述，完整文本见 [初始化Prompt](../agent_initialization_prompts.md)。

2026-10-18的00规则整理阶段仅修订本地协作规则与初始化文本，没有新增技术验证结果，也没有创建执行聊天、发送任务或进行远端操作。当前00对话名称为“00 项目总指挥”；其它执行对话是否初始化以主控实际操作为准。

2026-10-18同步请求：主控明确要求“现在与github同步”。00登记G-01并提供03执行Prompt；本地预检通过，尚未提交或推送。当前指令授权上传相关改动；合并至main、发布以及目标设备已同步均未在此处确认。

2026-10-18 G-01执行：03重新读取规则并核对7份已有文档，确认其它项目对话空闲后，将修改保留并带入新任务分支codex/project-coordination。41个本地Markdown链接与git diff --check通过；7份文档提交7471643e2fad03666caf825b0654c8f0ee70d454已推送，git ls-remote确认远端任务分支同号，main仍为9c2db9bcedf01e40dcfddde3ee7dfcc3b618cb0f。03建立[版本与设备交接记录](../version_handoff.md)，本段及交接记录通过随后记录提交交付，最终提交与远端核对结果见03给00的回报。本次没有固件改动，未重跑固件或实车测试，未合并、发布或操作目标设备。

后续每个任务更新关联行及证据；主控汇总跨模块影响。重要决定追加日期、决定、依据、受影响文档及确认角色。正式通知与报名凭据存入 `competition/`；详细接线与实物记录存入 `hardware_preparation/`；跨模块运行证据存入 `testing/`。

2026-10-18 I-03验收及型号纠正：主控明确“02生成完了”“都是按照那个硬件清单买的”。00已读取02的接线表、交接及证据索引，资料整理验收通过；电机MD310Z20_7.4V、驱动AT8236 Standard／YB-MNT03-V1.0、主板天空星STM32F407VET6青春版作为已确认的采购型号。照片缺少铭牌不再列为型号未知，也不阻塞01资源设计。00登记C-02A并提供转交01的资源分配Prompt；真实导通、供电及运行结果保持待测。本次只保存本地文档，未修改固件、操作板卡或上传。

2026-10-18 G-01验收：主控带回03完成回报，00通过只读Git检查及git ls-remote独立确认本地与远端任务分支均为2e16e84205e5fc44440092935a2fbfb01abfc0fe，本地与远端main均保持9c2db9bcedf01e40dcfddde3ee7dfcc3b618cb0f。任务分支包含原定7份文档及新增交接记录，共8份文件、2次提交，验收开始时无剩余工作区改动。文档上传与交接说明符合G-01范围，验收通过；笔记本实地同步仍待确认。00尚未创建PR、合并或发布；本次验收回填仅保存本地，未重新上传，不改变已核验的远端交付提交。

2026-10-18 G-02授权：主控明确要求“合并至main”，本次授权包括保存并上传00本地验收/授权记录、创建或更新对应PR、合并本次文档至远端main，以及台式机本地main接续核对。00仅登记并生成03执行Prompt，尚未提交、创建PR或合并；笔记本实际同步和发布仍未执行。

2026-10-18 G-02执行准备：03确认其它已显示的本项目对话空闲，重新读取规范并审阅完整文档差异；开始时仅有00的project_status.md修改，暂存区为空，无无关改动。联网核对远端来源分支、main及PR，尚无对应开放PR，main为来源分支祖先。03保存00记录并补充从main接续的交接说明，检查通过后创建PR、使用普通merge commit合并并快进同步台式机main。最终PR状态、来源提交、合并提交、本地与远端main及剩余改动由03最终回报提供，不为写入文档自身提交号重复提交；笔记本保持待确认。

2026-10-18 C-02A执行：01按主控转交Prompt及既定型号完成[引脚资源方案v0.2](../../control/docs/pin_plan.md)，保存[官方原图索引](../../control/docs/evidence/2026-10-18_c02a/README.md)。四桥输入选TIM1 PE9/PE11/PE13/PE14 AF1，A桥编码器改TIM3 PC6/PC7 AF2，B桥保留TIM4 PB6/PB7 AF2；避免PA0板载按键，保留UART/SWD等现有资源。八线端口与连接器端点唯一性、官方排针转写、AF与定时器分组、保留端口不重叠检查通过；最终51个本地链接、4张原图SHA256及git diff --check通过，固件差异为空。开始及结束均main，HEAD为82640aba4cf7aa4f30db14b486aef852936118fe，保留已有I-03与规划文档改动；本次未切分支、提交、上传、编译或操作板卡。资源设计待00验收，02待回填wiring旧候选；实物导通、电平、轮侧与运行仍待后续任务。

2026-10-20 I-04接线指导：主控确认硬件到齐，要求先讲完整接法，接好并回报后再编码。00读取01的C-02A方案、官方排针原图及02的驱动／电机照片和厂家逐线图，采用既定资源，纠正wiring旧PA0/PA1候选，保存双电机首次接线指南。当前只指导断电布线，XT30电池端和主板USB-C保持未插合；未测供电、未确认实物接线、未实现PWM或操作板卡。下一步等待主控接线回报，先核对供电，再生成01编码任务。本次仅保存本地文档，未提交、上传或自动发消息。

2026-10-20 I-04阶段回报：主控确认已接电池至驱动、电机至驱动的线，提出主板暂用电脑USB-C供电。00确认阶段方案为电脑USB供主板、电池后续供驱动，两板共地，仅接四路控制、四路编码器和GND；驱动5V、3V3不接主板，车载USB-A供电转接暂不实施。主板九线尚待主控完成回报，导通、供电及试转均未认定通过；继续先接线后编码。

2026-10-20 I-04完成汇报与C-02B安排：主控回复九根线‘已接好’。00按已约定的先接线后编码顺序生成01执行Prompt，允许在现有工程准备双电机开环短时试转固件、编译和电脑验证并交付下载／检查／试转步骤；不自动发送聊天、烧录、上电、驱动电机或上传。当前供电方案继续为电脑USB供天空星，驱动电池在准备阶段拔开，两板只连信号和GND，不并联5V／3V3。接线完成基于主控汇报，电气与转停实测结果仍待后续记录。

2026-10-20 C-02B执行回报：01完成独立MotorBench及详细中文注释，原三个目标与原应用源保留。TIM1四PWM为20kHz／15%，每次500ms后四脚00滑行；上电及阶段间先松键1s，WKUP长按约1–2s再松开，逐次触发A、B、AB，运行中原始按键停止并锁定，第三次结束不循环；独立IWDG监督中断停滞。Keil四目标及UART开启分支均0错误0警告，原55项及新增73项电脑检查通过，目标隔离／官方库哈希／BIN向量／78个文档链接与4段下载示例语法检查通过。BIN为4672字节，SHA256为8593c996b152dc3a7f67515dbe66b3bfa323acaf81d42222c2bbe95d3749b8a4，构建日志与BIN为被忽略的本地输出。已核实现有dfu-util 0.11可执行及既有DFU板测路径；本次未枚举或访问板卡。下载／备份／读回、电池连接时机、单轮与双轮步骤和故障排查已写入control/docs/motor_bench.md，供主控手动执行。仍为main，HEAD为82640aba4cf7aa4f30db14b486aef852936118fe，有本地未提交修改且保留已有成果；未切分支、提交、上传、烧录、上电或试转。真实导通、电压、复位窗口零驱动、起转／停止与滑行停稳待现场记录，代码交00验收不等于台架通过。

2026-10-20 C-02B验收准备：主控报告01已完成并请求验收方法。00只读检查MotorBench操作说明、按键状态机、PWM停止及监督代码，核对本机4672字节BIN哈希与01交付一致，构建日志为0错误0警告；未重跑已有检查、未访问板卡或改变固件。建立待填现场验收表，指导主控按电池断开下载／读回、USB待机、动力上电零输出、A／B／AB独立触发、停止锁定及静止复位顺序执行。所有现场结果保持待测，后续由主控带回，00再判定实物验收。

2026-10-20图形操作偏好：主控要求不使用终端，希望使用Keil5。00核对MotorBench工程已生成HEX，补充Keil5编译＋STM32CubeProgrammer USB DFU图形烧录步骤；当前单USB接法可保留。Keil本工程直接Download需要另接DAPLink／SWD，不能将板载USB当调试器。常用路径未找到CubeProgrammer，安装及实际连接未确认；本次未安装软件、改固件或操作板卡，现场验收仍待主控结果。

2026-10-20直接Keil下载偏好：主控希望像此前电协测试题一样直接用Keil5下载。00将首选路径调整为已购立创DAPLink＋SWD四线＋Keil CMSIS-DAP，主板仍电脑USB供电，DAP的5V0／3V3不接主板。已按官方DAPLink文档、H1原图及现有512KB算法补齐motor_bench.md第10节和快速入口；USB DFU路线留作备选。本次只保存操作文档，没有接线、改本机Keil设置、访问下载器、烧录或试转；下一步由主控确认SW Device识别及Verify OK，现场结果仍待回报。

2026-10-20待机异常回报：主控报告红灯常亮、绿灯不闪。00保留电池断开的排查边界，读取关键启动与LED代码及本机调试配置；确认MotorBench本机为目标调试而非模拟器，未取得实际下载日志或现场运行反馈，不能据灯态判定根因。记录C-02B待机异常，先取得Verify OK、BOOT0/WKUP释放后RESET观察及灯所在板信息；未改固件、未操作板卡、未认定台架通过。

2026-10-20 DAPLink单源供电选择：主控要求只用DAPLink供电和传输。00核对原清单立创DAPLink官方引脚表和天空星H1原图，提供5V0→H1.7主板5V、GND→H1.4/6、DIO→H1.5、CLK→H1.3、RST→H1.9的五线方案；天空星Type-C、DAPLink 3V3及驱动至主板5V/3V3均保持断开。电机仍由驱动电池单独供电，当前排查阶段电池拔开。未实际改接、测量或访问板卡；供电方案调整不等于绿灯不闪问题已解决，等待主控改接及Verify OK反馈。

2026-10-20下载证据补齐：主控提供MotorBench完整Keil日志，编译0错误0警告，Erase Done／Programming Done／Verify OK／Application running，结束20:36:59；明确红绿灯位于天空星主板，绿灯仍不闪。00归档用户日志并将下载链路标为通过，待机仍不通过；本机调试配置Run to main开启，后续用F5运行＋实时Watch采集毫秒计数、故障标志、按键与状态，区分启动停滞、复位循环及运行后灯输出问题。尚无板上运行变量，未下根因结论、未改代码或操作板卡，电池继续断开。

2026-10-20运行计数反馈：主控报告g_motor_bench_ms一直为0x000000。00将其作为现场观察归档，尚未取得其余Watch值及当前PC，暂不认定SysTick失效或看门狗死循环。继续在电池断开条件下通过Keil Run后短时Stop获取执行位置与Watch截图；不反复烧录、不改固件，现场验收保持未通过。

2026-10-20截图定位：主控停机截图PC在IWDG_GetFlagStatus，LR落在watchdog_init，PVU为1；ms/fault/state/raw为0，时钟变量16MHz。00将原图及SHA256归档，核对当前应用先无限等PVU/RVU、后Enable，而SysTick在该函数之后，ST官方F4初始化参考先Start再配置并限时等待。建立C-02B-R1交01修复，暂停原版动力试转，不要求重新接线／识别型号或重复烧录原版。修复后仍需主控独立上电和Keil观察验证，本次未改固件、自动发消息或访问板卡。

2026-10-20 C-02B-R1执行：01按主控转交任务核对ST RM0090 Rev22与官方F4初始化参考，在应用层将IWDG改为先Enable、再配置及限时等PVU／RVU、最后Reload；使用独立TIM5名义1MHz时基，各段等待10ms并保留时基失效的有限轮询保护，不依赖尚未启动的SysTick。初始化错误粘性锁存、保持零输出并禁止人工试转，IWDG及15%／500ms／停止锁定语义保留，官方库未改动。新测试先对旧main复现PVU等待卡住，再由真实main／SysTick通过154条模型断言／10场景；原73项与55项通过，MotorBench、原三个目标与UART开启分支均0错误0警告。新BIN5144字节，SHA256为9c165244e60585d5c9a9fbaf882dc4964a56c7c046a808ecfa37a66539c036dd，Watch版本0x020B0001；新AXF／HEX及完整证据见[修复记录](../../control/docs/motor_bench_startup_issue.md)。操作说明第11节已给纯Keil重新下载、退出调试并断电重启及运行中Watch步骤。本次仅本地保存，仍为main、HEAD 82640aba4cf7aa4f30db14b486aef852936118fe加未提交修改，保留已有成果；未切分支、上传、烧录、接电池或试转。新版实物仍待主控确认ms持续增长、fault=0、松键READY及用户灯每组闪1次，不能以电脑通过宣称症状已解决。

2026-10-20 R1交付核对：主控报告01完成。00读取应用修复、模型验证记录及Keil第11节，确认新版先启IWDG后配置并限时等待，失败锁存与零输出保留。独立核对本机新BIN5144字节及AXF／HEX三份哈希均与01产物表一致，MotorBench构建日志0错误0警告；本次不重复已通过检查、不改代码、不访问板卡。交主控用Keil重建／Download，再退出调试并通过DAPLink断电重启完成无动力自主启动复验；当前尚未取得R1实物通过证据。

2026-10-20绿灯恢复：主控确认新版绿灯正常闪烁，00记录原启动不闪症状恢复，不重复诊断原等待。计时／故障具体值和独立上电过程尚未逐项回报，不伪造验证；主控按清单自行确认后，退出调试进入A、B、AB悬空受控试转。当前没有电机转动或停止通过证据；00只更新本地记录并提供操作步骤，未改代码、访问板卡或上传。

2026-10-21电机A未起转：主控确认所有线接好、绿灯正常，KEY长按松开后显示每组2闪但电机不转；现场无万用表。00核对当前15%／500ms及状态机，确认已完成A软件阶段、进入待B，但不代表真实PWM／驱动／电机通过。停止继续B／AB，不直接调高占空比；先收集本次电池与开关、退出调试状态及驱动／主板接线照片，型号沿用既定清单，测量留给硬件协助。建立本日故障记录，本次未改固件或操作板卡、上传。

2026-10-21接线确认及R2分配：主控明确接线无问题，00沿用现场确认，不再以照片阻塞。当前15%／500ms可能低于起转区间但未确证，生成C-02B-R2交01准备固定30%／500ms诊断，保留R1、人工触发及停止锁定；主控先核对动力ON及退出调试并单轮A一次，仍失败不继续加功率，转硬件测量。00未改固件、发跨聊天消息、烧录、试转或上传；当前参数仍15%。

2026-10-21 C-02B-R2执行：01核对四路PE9／11／13／14的TIM1 AF1、CCxE、MOE及CCR，无确切源码配置不一致；固定占空比改为300‰，PSC0／ARR799、有效CCR240，对应名义20kHz，500ms与原人工A→B→AB／停止锁定不变。版本0x020B0002；R1看门狗、TIM5有界等待及故障零输出逐字复核保留，官方库未改。MotorBench编译0错误0警告，启动模型154条／10场景、台架73项、协议55项通过；原三目标／UART分支本轮未重编译。反汇编确认240已进入ARM产物，与R1的5144字节BIN仅版本与比较值两字节不同；新BIN SHA256为99b03ae743aa1021aeb5cb49192f2b24771e30d0872a577b17b3b29bbbd1d967，完整AXF／HEX哈希、修改清单及依据见[R2交付](../../control/docs/motor_bench_r2_task.md)。[操作说明第12节](../../control/docs/motor_bench.md)给出纯Keil重建／Download、无动力确认版本及待机、退出调试和独立重启，再只A一次的步骤。仍为main、HEAD 82640aba4cf7aa4f30db14b486aef852936118fe加本地未提交修改，保留已有成果；未切分支、提交、上传、访问板卡、烧录、接电池或试转。真实30%起转仍待主控，失败立即OFF拔XT30，不继续B／AB、不再加功率，由硬件借仪表补测，不能预先填写通过。

## 2026-10-21：UC2充电发热待核查

主控报告使用ISDT UC2给动力电池充电时，UC2“特别特别烫”。目前无实测温度，电池是否同时发热、输入电源规格及指示灯状态未确认；不能据此认定正常或确认损坏。00已建议先停止充电，待冷却并核对设备；尚未收到主控已断电的回报。在排除充电异常前，建议暂停动力试转，C-02B-R2的软件准备可以继续。

官方UC2页面列明输入5V/2A、充电电流0.8A、支持1S/2S且单节终止电压4.2V的LiPo，通过XH2.54平衡口充电；所查产品文字未给出可用于判断机壳温度的上限，不编造温度阈值。来源：https://www.isdt.co/uc2-2.html 。下一步需主控补充：热的是UC2本体还是USB供电头，电池有无发热/鼓包/异味，以及USB供电头输出规格；不得靠反复通电或触摸试温确认。

### UC2发热反馈补充

主控进一步确认：只有UC2小充电器本体发热。不能据此认定故障或正常；USB输入规格、实际机壳温度和指示灯仍待确认，断电操作尚未回报。维持先停止充电的建议，不要求再次通电或用手试温。

2026-10-21 R2交付由00核对：主控回报01完成。00读取当前宏300‰、周期800和500ms参数、main版本0x020B0002、PWM与R1保护说明及实际日志；确认MotorBench编译0错误0警告，已有启动154／10场景、台架73和协议55项日志通过。独立计算AXF／HEX／BIN三份SHA256，与01交付表完全一致，BIN5144字节。软件交付接受，真实起转仍未验证；未重复运行已通过测试、未修改固件或连接板卡。鉴于主控报告UC2本体特别烫且输入／温度未核清，当前仅指导电池拔开时用Keil完成R2下载、版本与独立待机检查，动力试转暂缓。没有把UC2发热认定为电机不转根因，也没有自动上传。
2026-10-21 R2现场下载反馈：主控回报“Verify OK、绿灯正常”，按本轮R2下载指导记录下载校验通过与用户灯正常。没有额外收到板内Watch版本、fault、ms及独立断电过程的逐项读数，不补造上述结果；A／B／AB真实转停仍未验证。UC2此前只有本体特别烫的反馈不变，当前未收到电池断开／冷却及外观状态确认；先停用UC2并核实电池状态，再安排动力试转，不把充电器发热当作电机未转根因。未改固件、重编译、访问板卡或上传。
2026-10-21电池状态确认与A试转安排：主控对上一轮确认问题答复“确认”，据此记录电池已与UC2断开、完全冷却且无鼓包、异味或接头变形。该反馈不等于电压、内阻或充电器故障实测；UC2继续停用另行核查。主控在退出Keil调试、轮子悬空、待机每组1闪后，按第12.3节驱动OFF接XT30再ON，仅KEY一次长按松开，观察A桥30%／500ms后撤输出及停稳，随后OFF拔XT30并回报；不继续B／AB，失败不重试加功率。当前仅发出人工指导，尚未收到本轮起转结果，00未操作板卡或上传。
2026-10-21主控决定停用UC2并请求替代推荐：00按既定2S／7.4V／800mAh／XT30电池，查阅厂家资料后建议SkyRC S65（SK-100152，交流直接供电、0.1–6A可调、2–4S LiPo）配适用的XT60输出至XT30电池成品主充电线及交流电源线，首次充电设置建议0.5A／LiPo平衡／2S／4.20V每节。记录见[替代充电器建议](../../hardware_preparation/charger_replacement.md)。仅选型建议，未确认购买／库存／价格／到货或实物充电；保留原采购历史，未把UC2发热确认为电机故障根因，I-05供电测量仍待完成。未下单、上传或操作实物。

2026-10-21充电预算补充：主控要求比S65便宜。00核对ToolkitRC C4官方参数与中文手册，给出低预算候选：交流直接输入、LiPo2–4S、0.5A档、LED进度，配XT60至现有XT30电池的主充电线。约120–150元仅为选购预算估计，国内实时成交价与配线费用未核验；不把不稳定导购价格当成交承诺。见[替代充电器建议的预算补充](../../hardware_preparation/charger_replacement.md)。未采购或验证实物，UC2保持停用，I-05测量待进行。

2026-10-21恢复电机调试：主控要求先不管电池／充电器选型，让马达转起来；后续确认上一次AT8236驱动板自身电源指示灯亮。00沿用该现场事实，不推定电压和驱动输出正常。只读复核现有TIM1／GPIO及SysTick路径未见确切配置错误，生成C-02B-R3交01增加活动与停止寄存器快照，保持30%／20kHz／500ms及既有保护，主控先不接动力电池通过Keil采集，不重复加功率。任务待人工转交，未实现或烧录；UC2继续停用，I-05实际电气定位仍需硬件仪表，不宣称故障解决。

2026-10-21 C-02B-R3执行：01在MotorBench增加244字节volatile保留诊断，真实启用后／完成安全停止后分别读取20个TIM1、GPIOE及RCC寄存器；保留请求、启用调用、MOE读回置位与停止计数，记录实际ms／差值、mask、state、fault、原因及配对run_id。相同1ms请求不重复计数，未启用valid0，停止不覆盖活动帧；下次启用或复位才替换／清除。30%／20kHz／500ms、原引脚、人工序列、停止保护和R1看门狗／TIM5限时等待保留，官方库及Keil配置未改。新增真实main／PWM模型131项／8场景、原启动154／10场景、台架73与协议55项通过；MotorBench最终编译0错误0警告，Code5208／RO424／RW64／ZI1288。版本0x020B0003，新BIN5696字节、SHA256 d09c4095c55eb34607d012c36611b239b6d24c00d2451497f925e812e994e0d8，完整AXF／HEX哈希与14份修改清单见[R3交付](../../control/docs/motor_bench_r3_task.md)。[操作说明第13节](../../control/docs/motor_bench.md)提供纯Keil下载、全程电池拔开、F5持续Run、一次KEY A后保留Watch列表与判定表，不在500ms窗口暂停或强改值。仍为main、HEAD 82640aba4cf7aa4f30db14b486aef852936118fe加本地未提交修改，保留R2历史及已有成果；未切分支、提交、上传、访问板卡、烧录、接电池或试转。当前尚无R3实板快照，寄存器即使符合也不能替代外部PWM／供电与驱动实测，I-05测量准备继续。

2026-10-21 R3交付核对：主控报告01完成。00读取诊断结构、真实MMIO读取、启用后活动采集与安全停止后采集位置、SysTick上下文和第13节纯Keil步骤，核对版本0x020B0003及30%／20kHz／500ms未变。已有MotorBench构建日志0错误0警告、诊断131条／8场景及154／73／55项日志通过；00独立算得AXF10340062…、HEXdb15063d…、BINd09c4095…三份SHA256与R3交付表一致，BIN5696字节。接受本地软件交付，未重复运行已通过检查，未修改固件、下载、连接板卡或上传；只安排主控在驱动OFF、XT30拔开时用Keil下载R3、F5持续运行并KEY一次A，事后读保留的活动／停止快照。实际请求、MOE、CCR、端口、停止时间与原因均待主控回报，不能据电脑证据宣称电机问题解决。
2026-10-21 R3首次A实板快照：主控提供三张Watch图，00原样归档至testing/2026-10-21_motor_bench/r3_watch/并计算SHA256。请求／启用调用／MOE读回／停止均1次；active／stopped配对run_id1，fault均0，开始0xBCE2至结束0xBED6，实际差500ms，原因1。活动TIM1 CEN1、PSC0、ARR799、CCER0x1111、MOE1、CCR(240,0,0,0)，PE9／11／13／14为AF1；停止MOE0、CCR全0、GPIO输出低；PE9 IDR单次采样高→低。板内启用与停止路径符合预期，未发现应继续改参数的证据，但未证明实际PWM频率／幅值或驱动供电／输出／电机正常，图中未含revision读数。00同时核对02已有I-05测量方案，当前只安排借万用表后M01–M03不按KEY的静态测量；保留R3，不回刷旧版。尚无电气数值或起转通过结果，未访问板卡、改固件或上传。

2026-10-24 MotorDirect软件交付：主控表示暂时无法去实验室，要求不用PWM快速验证电机。01新增独立GPIO目标0x020B2001，原PE9／11／13／14接线，KEY长按松开仅A一次500ms后四脚低且完成锁定，保留R1、看门狗及人工停止。固定电平相当于满导通，强于30%PWM；原PWM两个目标BIN／HEX逐字节保留。新main／GPIO电脑模型9场景及R1启动10场景通过，原模型回归通过，六Keil目标均0错误0警告；已修正Keil共享文件导致的旧目标隐式编入问题并回归。操作见[MotorDirect说明](../../control/docs/motor_direct.md)：先电池拔开下载和演练500ms锁定，通过后退出调试、断动力复位、轮子悬空，只一次A再OFF拔XT30。没有现场起转结果，不判电机损坏；不转不继续B／AB或延时，独立限流电源方案留待条件具备。仅本地未提交修改，未切分支、烧录、操作板卡、电池、电机或上传。

2026-10-24 MotorDirect入口修复：主控反馈没有该目标。01核对实际磁盘工程只剩五目标、Keil打开路径正确，未确定覆盖来源；已备份当时配置、恢复第六目标，并新增[单目标独立工程](../../control/MDK-ARM/motor_direct.uvprojx)，直接打开即显示MotorDirect，避免旧窗口保存影响该入口。独立入口编译0错误0警告，原五目标当前配置保留，固件源码及BIN／HEX不变；主控切换工程时保持动力电池拔开、退出调试，当前旧工程保存询问选No，再按[操作说明](../../control/docs/motor_direct.md)手动下载和无动力演练。未操作板卡、上传或认定起转通过。
