AgrumeStly/yeye/hardware_preparation/evidence/2026-10-18_i03/photo_01_driver.jpg

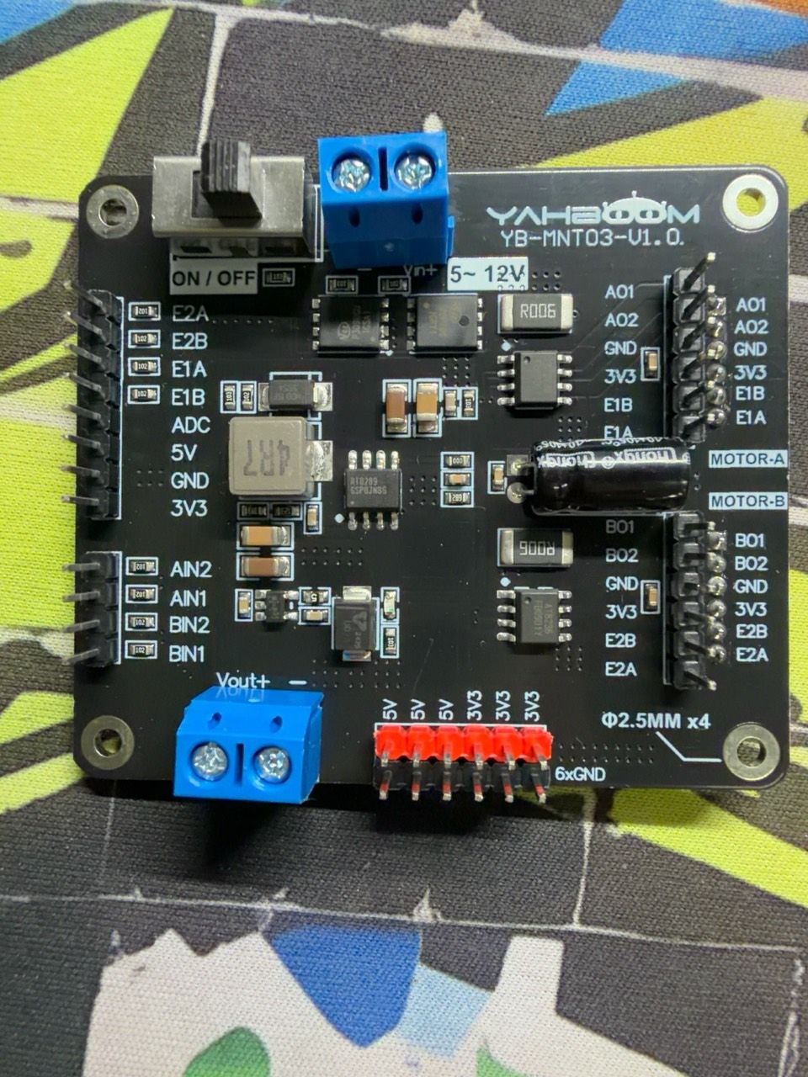
hardware_preparation/evidence/2026-10-18_i03/photo_01_driver.jpg
