AgrumeStly/yeye/hardware_preparation/evidence/2026-10-18_i03/photo_03_controller.jpg

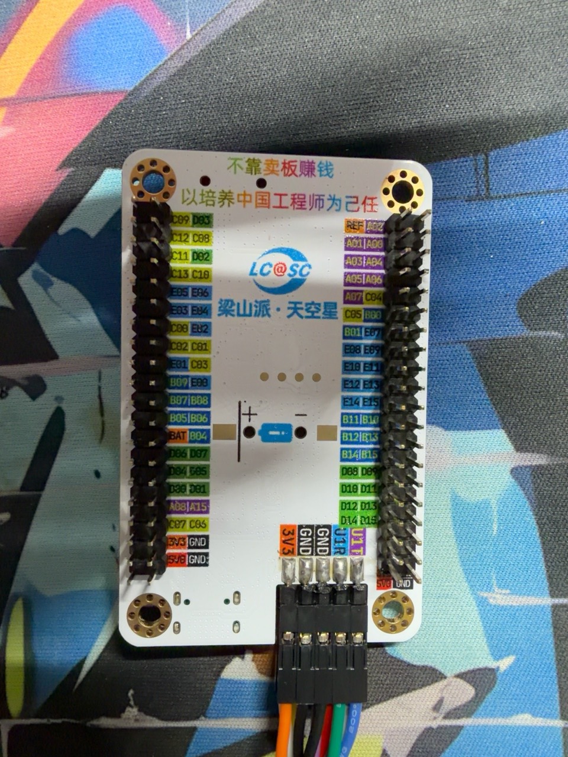
hardware_preparation/evidence/2026-10-18_i03/photo_03_controller.jpg
