AgrumeStly/yeye/hardware_preparation/size/万向轮固定孔.png

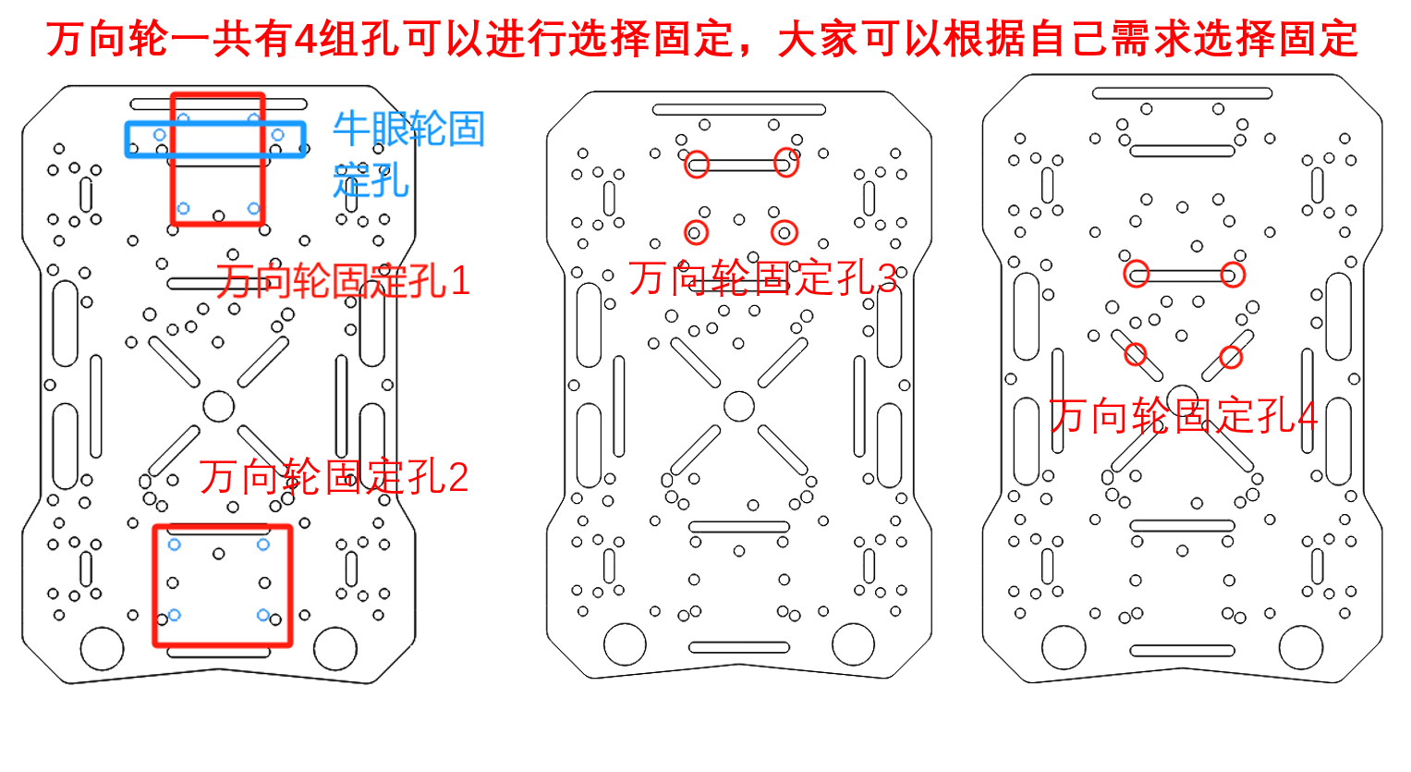
hardware_preparation/size/万向轮固定孔.png
