AgrumeStly/yeye/hardware_preparation/purchase_list_control.pdf

SMART CAR / PERSONAL PURCHASE LIST / 2026-10-10 | 1 / 1

# 主控队员购买清单

按原完整采购方案分配 / 原编号用于对账 / 2026-10-10

本单器件预计 207.8 元（未含运费）。主控207.8元、视觉211.0元、硬件207.0元，三人器件合计625.8元。全队另留20 元运费/价差，计划合计645.8元。

金额沿用原清单的展示价或预算估算，本次未重新核价；最终以实际订单为准。型号按原F407方案。蓝色文字可点击；标准件按规格搜索 购买。

编号 | 型号 / 必须选择的规格 | 数量 | 单价 | 小计 | 购买入口 / 搜索词
01 | 天空星 STM32F407VET6 开发板-青春版 只买核心开发板。 | 1 | 39.9 | 39.9 原展示价 | 立创商品 23849165 (https://item.szlcsc.com/23849165.html)
03 | 立创 DAPLink 调试工具
核对配套SWD下载线。
1 | 22.9 | 22.9 原展示价

立创商品 56199685 (https://item.szlcsc.com/56199685.html)

07 Yahboom AT8236 Standard 标准版 丝印 YB-MNT03-V1.0
带5V降压输出和总开关。
1 | 55.0 | 55.0 估算

亚博天猫驱动板 (https://detail.tmall.com/item.htm?id=700583380137)

11 Tattu TA-45C-800-2S1P-XT30 7.4V / 800mAh / 45C / 2S
动力头XT30；平衡头JST-XH 3P。
1 | 45.0 | 45.0 估算

厂家型号页 (https://genstattu.com/tattu-800mah-7-4v-45c-2s1p-lipo-battery-pack-with-xt30-plug/)
国内搜索完整型号

12 ISDT UC2 / 0.8A
支持2S LiPo，4.2V/节
USB-C输入，XH平衡充电接口。
1 | 35.0 | 35.0 估算

厂家型号页 (https://www.isdt.co/uc2-2.html)
国内搜索：ISDT UC2

15 USB-A公→USB-C公数据线
0.3m / USB2.0 480Mbps / 3A。
1 | 5.0 | 5.0 估算

搜索完整规格；须支持数据传输
本单1根，另一位队员另买1根

18 470μF/16V 105℃径向电解电容 ×2 100nF/50V X7R陶瓷电容 ×3
20kΩ及10kΩ / 1% / 0.25W电阻各×2。
1 | 5.0 | 5.0 估算

标准件逐项购买；5元为整组预
算

## 下单核对与交接

1. 驱动板选 AT8236 Standard 标准版；电池选2S、800mAh、XT30，充电器选UC2。确认电池平衡头与UC2的2S口匹配。
2. 第18项是上表全部电容、电阻，各按数量买齐；不另买整套“电子元件大礼包”。
3. DAPLink订单检查下载线；未含时可用硬件队员购买的杜邦线连接。
4. 本人买1根USB数据线。充电用USB电源由硬件队员购买；车上电源接头及紧固件也由硬件队员负责。

收到后：记录实付款，核对板子和电池接口；把电池/充电器交给硬件队员统一检查，再开展供电和电机调试。

## 采购与对账约定

每人只按本单数量下单；提交订单截图和实付款，包含运费。配件取消重复购买或增加补缺时，三人同步记账。若希望最终平均出资，可 把实际总支出除以3，再结算差额。

原方案工具、练习赛道未计入器件预算，装配工具优先借用。来源：hardware_preparation/hardware_purchase_list.pdf。本单是该方 案的分工版本。
