AgrumeStly/yeye/hardware_preparation/purchase_list_vision.pdf

SMART CAR / PERSONAL PURCHASE LIST / 2026-10-10 | 1 / 1

# 视觉队员购买清单

按原完整采购方案分配 / 原编号用于对账 / 2026-10-10

本单器件预计 211.0 元（未含运费）。主控207.8元、视觉211.0元、硬件207.0元，三人器件合计625.8元。全队另留20 元运费/价差，计划合计645.8元。

金额沿用原清单的展示价或预算估算，本次未重新核价；最终以实际订单为准。型号按原F407方案。蓝色文字可点击；标准件按规格搜索 购买。

编号 | 型号 / 必须选择的规格 | 数量 | 单价 | 小计 | 购买入口 / 搜索词
02 | 庐山派 Lite-K230D-CanMV / 128MB 标准套件，含GC2093小镜头定焦摄像头。 | 1 | 188.0 | 188.0 原展示价 | 立创商品 59063152 (https://item.szlcsc.com/59063152.html)
04 | MK米客方德 SDSDQAB-008G-MK
microSD / 8GB / Class 10。
1 | 15.0 | 15.0 估算

立创商品 58293428 (https://item.szlcsc.com/mro/58293428.html)

15 USB-A公→USB-C公数据线
0.3m / USB2.0 480Mbps / 3A。
1 | 5.0 | 5.0 估算

搜索完整规格；须支持数据传输
本单1根，另一位队员另买1根

19 铝散热片20×20×6mm ×1
带绝缘导热胶贴。
1 | 3.0 | 3.0 估算

搜索：20×20×6mm 铝散热片
导热胶贴

### 视觉套件需要包含什么

核对订单为 Lite-K230D-CanMV 128MB 标准套件，含GC2093小镜头定焦摄像头。原厂家包装图还列出摄像头钣金支架、 安装小螺丝和GH1.25转杜邦线；赠品以订单为准。

如果赠品缺少，请按下列规格补缺：GH1.25-4P→2.54mm杜邦母头线，至少1条，用于与主控串口通信。追加费用记录到全队对账中。

### 下单核对与交接

1. TF卡需要单买1张，规格8GB、Class 10。
2. 本人只买1根USB数据线，主控另外买1根；选可传数据的A-to-C线。
3. 散热片需带绝缘导热胶贴；若套件已含相同散热件，记录后从本单扣掉，避免重复买。
4. 摄像头不另买第二套。扬声器、扬声器转接线、视觉安装台和固定件由硬件队员购买。

收到后：先拍包装与配件照片，完成摄像头画面测试；将安装孔位、随配线材和支架交给硬件队员核对装车。

### 采购与对账约定

每人只按本单数量下单；提交订单截图和实付款，包含运费。配件取消重复购买或增加补缺时，三人同步记账。若希望最终平均出资，可 把实际总支出除以3，再结算差额。

原方案工具、练习赛道未计入器件预算，装配工具优先借用。来源：hardware_preparation/hardware_purchase_list.pdf。本单是该方 案的分工版本。
