AgrumeStly/yeye/hardware_preparation/wiring.md

# I-03 电机、AT8236与天空星接线核对

> 2026-10-29当前安装已变：主控重新规定物理A=左／B=右，旧前进转向现为对应新位置后退。实际驱动MOTOR-A/B与软件a/b不随这个命名自动改变；当前映射／旧CPR沿用与待核项统一见[wheel_mapping.md](wheel_mapping.md)。本页历史接线表仍按驱动固定信号名读，不能把AIN/BIN误读为新物理A/B。

状态：v0.3，采用C-02A资源方案；接线草案未冻结、未完成实物导通验收。更新：2026-10-20（北京时间）。整理：主控／02；采购确认与资源回填：00；实物、线束与供电复核：硬件；MCU资源及控制接口复核：主控／01；验收汇总：00。

主控2026-10-20确认硬件到齐，要求先完成双电机接线，回报接好后再编码。按步骤操作见[双电机首次接线指南](dual_motor_wiring_guide.md)；本阶段全部断电装配，XT30电池端保持未插合。

任务依据：主控本次I-03指令、[协作标准](../project_planning/collaboration_standard.md)、[当前状态](../project_planning/project_status.md)、[引脚候选](../control/docs/pin_plan.md)、[原采购方案内容源](source/generate_purchase_list.py)及其[历史PDF](hardware_purchase_list.pdf)。

本次只检查文件、照片及官方资料，没有操作实物、改接线、量通断、测电压、编译烧录或通电。下文“确认”只指可读丝印或厂家功能定义，**没有任何一条现装线束被认定为实物验证通过**。电压均为资料标称／预期值，实测值全部待补。未决项阻止接线冻结和上电放行，不阻止01开展资源设计。

## 1. 证据及器件身份

2026-10-18主控明确确认“都是按照那个硬件清单买的”。结合原采购清单，本任务采用的型号基准为：电机Yahboom MD310Z20_7.4V（1:20、450rpm），驱动Yahboom AT8236 Standard／YB-MNT03-V1.0，主板立创天空星STM32F407VET6青春版。该确认是采购身份依据，不是通断或电压实测；照片缺少铭牌不再构成“型号未知”或01资源分配的阻塞。后续仅在实物发现与清单具体不符时记录差异，无需重复要求主控识别既定型号。

原始照片按收到的字节复制，未裁剪、未重绘；来源、SHA256和厂家资料见[证据索引](evidence/2026-10-18_i03/README.md)。照片拍摄时间未知，2026-10-18为本次接收／核对日期。

| 证据 | 照片可确认 | 仍不能确认 |
| --- | --- | --- |
| P1：[驱动板正面](evidence/2026-10-18_i03/photo_01_driver.jpg) | YAHBOOM、YB-MNT03-V1.0；板载开关、降压电感、5V/3V3输出标识；布局与厂家标准版示例一致，可按AT8236 Standard板级身份进行资料匹配 | 采购订单、背面版本／改板情况、两颗芯片完整顶标、实际电压、输入端螺丝左右极性和开关覆盖范围 |
| P2：[电机端接口](evidence/2026-10-18_i03/photo_02_motor.jpg) | 按照片从上到下：M2、V、A、B、G、M1；六芯插头已插在该电机端；型号采用主控确认的MD310Z20_7.4V | 照片未展示铭牌；线束另一端、第二只电机的接线及左右轮对应尚未展示；待核的是连接关系，不是重新选择型号 |
| P3：[天空星背面](evidence/2026-10-18_i03/photo_03_controller.jpg) | 梁山派·天空星标识；A00/A01、B06/B07等端口丝印；底部调试口附近3V3、GND、U1R、U1T标识及已插线束；型号采用主控确认的STM32F407VET6青春版 | 照片未展示芯片正面和PCB版本；线束另一端未展示，不能认定SWD接法正确；具体PCB修订仅在影响引出位置时补核 |

板卡软件目标STM32F407VET6与主控确认的采购型号一致。01应直接按既定型号查原理图和复用资料；板级位置若存在具体版本差异，再由硬件定点补证，不将补齐所有顶标照片作为设计前提。

## 2. 来源编号与阅读方向

- S1：亚博[官方STM32接线教程入口](https://www.yahboom.net/study/Dual-MD-Module/6604/)，其官方仓库[PDF快照](evidence/2026-10-18_i03/vendor_driver_stm32.pdf)第1页。已渲染查看，电机逐线功能关系直接来自图中文字。示例MCU是F103，其GPIO分配不可照搬F407。
- S2：亚博[官方模块介绍](https://www.yahboom.net/public/upload/upload-html/1692605631/Introduction%20of%20Module.html)及[PDF快照](evidence/2026-10-18_i03/vendor_driver_introduction.pdf)：标准版输入5–12V，5V输出标称3A、3.3V输出标称500mA，电机口PH2.0-6P。额定输出不能作为本车带载测试结果。
- S3：杭州中科微《AT8236-S409-V1.1》[原厂内容PDF快照](evidence/2026-10-18_i03/at8236_datasheet.pdf)，第4页电气门限、第5页真值表；经第三方托管地址取得，正文厂商为杭州中科微。见证据索引的原URL与哈希。用于芯片层解释，板级走线、器件真伪及实际行为仍需硬件核对。
- S4：立创[天空星原理图说明](https://wiki.lckfb.com/zh-hans/tkx/hardware/schematic.html)：Type-C的5V与排针5V相连，调试口引出串口1；按实际PCB版本复核。ST [STM32F405/407 DS8626](https://www.st.com/resource/en/datasheet/stm32f405rg.pdf)复用表供01分配资源时核查。
- S5：本仓库[board.h](../control/Drivers_Custom/Board/board.h)、[board.c](../control/Drivers_Custom/Board/board.c)、[协议草案](../control/docs/protocol_v1_draft.md)、[引脚候选](../control/docs/pin_plan.md)。UART默认关闭，当前输出只更新调试请求变量。

P1保持开关在图上方：右上MOTOR-A从上到下为AO1、AO2、GND、3V3、E1B、E1A；右下MOTOR-B从上到下为BO1、BO2、GND、3V3、E2B、E2A。左下控制排针从上到下为AIN2、AIN1、BIN2、BIN1；左上排针从上到下为E2A、E2B、E1A、E1B、ADC、5V、GND、3V3。

为避免伪造厂家针号，本记录使用**照片位置号**：DA1–DA6、DB1–DB6为P1各电机口从上到下；M1p1–M1p6为P2电机插座从上到下。第二只电机的M2p位置号须取得照片后填写。位置号不是连接器厂家Pin1，插合面、出线面和板背面可能镜像，不能机械套用“直通／反序”。

## 3. 电机与驱动板逐线表

MA／MB只代表驱动A／B桥，不预先等于左／右轮。以下为S1确认的**应接功能关系**；全部线束导通实测、第二端插头腔位及装车轮侧仍待硬件填入。

| 线号 | 来源接口 | 来源针脚 | 目标接口 | 目标针脚 | 用途 | 电压／电气域（未实测） | 核对依据与状态 |
| --- | --- | --- | --- | --- | --- | --- | --- |
| MA-01 | 驱动MOTOR-A | DA1／AO1 | 电机MA六芯口 | M1（若使用P2电机：M1p6） | 电机绕组端1 | H桥功率输出，随VM/PWM变化；非逻辑电源 | P1、P2、S1；应接定义确认，线束待通断 |
| MA-02 | 驱动MOTOR-A | DA2／AO2 | 电机MA六芯口 | M2（P2：M1p1） | 电机绕组端2 | 同上；不能当GND | P1、P2、S1；待通断 |
| MA-03 | 驱动MOTOR-A | DA3／GND | 电机MA六芯口 | G（P2：M1p5） | 编码器地 | 0V参考地 | P1、P2、S1；待通断 |
| MA-04 | 驱动MOTOR-A | DA4／3V3 | 电机MA六芯口 | V（P2：M1p2） | 编码器电源 | 预期3.3V；须匹配既定电机编码器规格 | P1、P2、S1及主控型号确认；规格匹配与实际电压待核对 |
| MA-05 | 电机MA六芯口 | B（P2：M1p4） | 驱动MOTOR-A | DA5／E1B | 编码器B输出 | 预期0/3.3V脉冲；输出类型、上拉待核 | P1、P2、S1；待通断／后续电平测试 |
| MA-06 | 电机MA六芯口 | A（P2：M1p3） | 驱动MOTOR-A | DA6／E1A | 编码器A输出 | 同上 | P1、P2、S1；待通断／后续电平测试 |
| MB-01 | 驱动MOTOR-B | DB1／BO1 | 电机MB六芯口 | M1；物理位置待第二只照片 | 电机绕组端1 | H桥功率输出，非逻辑电源 | P1、S1；第二只及线束待核对 |
| MB-02 | 驱动MOTOR-B | DB2／BO2 | 电机MB六芯口 | M2；物理位置待核对 | 电机绕组端2 | 同上；不能当GND | P1、S1；待核对 |
| MB-03 | 驱动MOTOR-B | DB3／GND | 电机MB六芯口 | G；物理位置待核对 | 编码器地 | 0V | P1、S1；待核对 |
| MB-04 | 驱动MOTOR-B | DB4／3V3 | 电机MB六芯口 | V；物理位置待核对 | 编码器电源 | 预期3.3V，实际规格待核对 | P1、S1；待核对 |
| MB-05 | 电机MB六芯口 | B；物理位置待核对 | 驱动MOTOR-B | DB5／E2B | 编码器B输出 | 预期0/3.3V，类型和上拉待核对 | P1、S1；待核对 |
| MB-06 | 电机MB六芯口 | A；物理位置待核对 | 驱动MOTOR-B | DB6／E2A | 编码器A输出 | 同上 | P1、S1；待核对 |

P2可见颜色仅作寻找某一根线的辅助，不构成跨线束标准。不能把电机端与驱动端各自的“从上到下第n根”直接相连。若实测不符，先登记端点与照片，再由硬件重排／制作匹配线束；记录没有授权通电试错。

## 4. 驱动板与主控逐线表（采用C-02A资源）

下表采用[pin_plan.md v0.2](../control/docs/pin_plan.md)与官方排针图，属于资源设计确认，实物插接及导通仍待核对。板背E09=PE9、C06=PC6、B06=PB6，依此类推；P1/P2为原理图连接器号，不是芯片脚号。旧PA0/PA1编码器候选取消，PA0保留板载按键。E14与前三个PWM脚不在同一列，B06/B07也不在同一行，不沿单列连续数针。

| 线号 | 来源接口 | 来源针脚 | 目标接口 | 目标针脚 | 用途 | 电压／电气域（未实测） | 核对依据与状态 |
| --- | --- | --- | --- | --- | --- | --- | --- |
| C-01 | F407 TIM1_CH1 AF1 | PE9／E09，P1.15 | 驱动左下控制排针 | AIN1（自上第2） | A桥输入1 | 0/3.3V控制 | C-02A资源已定，实物待导通 |
| C-02 | F407 TIM1_CH2 AF1 | PE11／E11，P1.17 | 同上 | AIN2（自上第1） | A桥输入2 | 0/3.3V控制 | 同上 |
| C-03 | F407 TIM1_CH3 AF1 | PE13／E13，P1.19 | 同上 | BIN1（自上第4） | B桥输入1 | 0/3.3V控制 | 同上 |
| C-04 | F407 TIM1_CH4 AF1 | PE14／E14，P1.22 | 同上 | BIN2（自上第3） | B桥输入2 | 0/3.3V控制 | 同上 |
| C-05 | 驱动左上信号排针 | E1A（自上第3） | F407 TIM3_CH1 AF2 | PC6／C06，P2.35 | A桥编码器A | 预期0/3.3V输入 | C-02A替代旧PA0，实物待导通 |
| C-06 | 驱动左上信号排针 | E1B（自上第4） | F407 TIM3_CH2 AF2 | PC7／C07，P2.36 | A桥编码器B | 同上 | C-02A替代旧PA1，实物待导通 |
| C-07 | 驱动左上信号排针 | E2A（自上第1） | F407 TIM4_CH1 AF2 | PB6／B06，P2.23 | B桥编码器A | 同上 | C-02A资源已定，实物待导通 |
| C-08 | 驱动左上信号排针 | E2B（自上第2） | F407 TIM4_CH2 AF2 | PB7／B07，P2.22 | B桥编码器B | 同上 | 同上 |
| C-09 | 驱动左上信号排针 | GND（自上第7） | F407电源地排针 | P3明确标GND的位置，具体针号待核 | 控制与编码器共地 | 0V | P1/P3、S1；待测导通；电机大电流回路不经MCU信号地线串接 |

E1/E2在电机插口与左侧信号排针之间的板内导通关系须断电测量，不能只因丝印相同便填写“实测通过”。暂用MA→E1、MB→E2描述，01还需与硬件确定MA/MB对应车辆左／右。

## 5. 供电、UART与SWD逐线表

| 线号 | 来源接口 | 来源针脚 | 目标接口 | 目标针脚 | 用途 | 电压／电气域（未实测） | 核对依据与状态 |
| --- | --- | --- | --- | --- | --- | --- | --- |
| P-01 | 电池主放电接头 | 正端，经XT30U-M成品线接入，极性待测 | 驱动顶部蓝色输入端子 | Vin+；按板上正负丝印核对 | 动力及板载降压输入 | 模块标5–12V；按清单采用2S标称7.4V／满电8.4V | P1、S2、清单及主控确认；接线不据线色单独认极性 |
| P-02 | 电池主放电接头 | 负端，待确认 | 同上 | Vin−／GND；位置待核 | 电源回流 | 0V | 同上；电池接入前必须完成极性核对 |
| P-03 | 驱动明确标5V的输出排针 | 5V | 原方案USB-A供电转接板 | 标5V/VBUS的端子 | F407逻辑供电正线 | 标称5V | P1、S2、历史方案；转接板未展示，待导通/负载验证 |
| P-04 | 驱动GND输出 | GND | 同一USB-A转接板 | GND端子 | F407供电回流 | 0V | 同上；不接D+/D− |
| P-05 | USB-A转接板＋A-to-C线 | VBUS功能线 | 天空星Type-C | VBUS功能触点，经成品线连接 | 主控5V供电 | 标称5V | 历史方案、S4；不猜Type-C焊盘号，转接板到线端待导通 |
| P-06 | 同一转接板＋线 | GND功能线 | 天空星Type-C | GND功能触点 | 供电回流 | 0V | 同上；本次不实施供电 |
| U-01 | F407 USART2 | PA2／TX候选 | 视觉UART | 实际RX；物理针号由视觉交付 | 主控→视觉 | 3.3V逻辑，115200/8N1草案 | S5；本次未见视觉板，未冻结 |
| U-02 | 视觉UART | 实际TX；物理针号待交付 | F407 USART2 | PA3／RX候选 | 视觉→主控 | 同上 | S5；P3中PA3标A03，PA2位置需再核 |
| U-03 | 视觉板 | GND | F407／系统公共地 | 经确认GND | UART参考地 | 0V | S5；不用UART线中的5V跨接电源 |
| D-01 | 下载器 | SWDIO，型号及端子待核 | 天空星SWD | PA13／SWDIO，物理针号待核 | SWD数据 | 3.3V目标逻辑域 | 引脚候选、S4；P3不能辨认线束另一端 |
| D-02 | 下载器 | SWCLK，端子待核 | 天空星SWD | PA14／SWCLK，物理针号待核 | SWD时钟 | 同上 | 同上 |
| D-03 | 下载器 | GND | 天空星SWD | 确认后的GND | 调试共地 | 0V | 同上 |
| D-04 | 已供电目标板 | 3V3参考点 | 下载器 | 仅在该型号明确标VTref且要求检测时连接 | 目标电平检测 | 3.3V参考；不得假定为供电输出 | 下载器说明待交付；若端口是3.3V输出不能据此并接 |

当前不连接的接口：

| 接口 | 本次处理及原因 |
| --- | --- |
| 驱动底部蓝色Vout+/− | 是与顶部输入分开的接口，不能当5V稳压输出。厂家称可级联供电，暂按可能携带原电源电压处理；板内电源路径／开关关系待原理图与断电核对，不接F407的5V/3V3 |
| 驱动3V3与F407的3V3 | 编码器可按S1使用驱动3V3；不因此把两块稳压器输出并联。F407供电沿明确5V入口规划 |
| 驱动ADC | 电压采样接口；本任务不启用。不要照搬F103教程ADC→PA2，PA2已是视觉UART TX候选；比例及最大电压也未签核 |
| P3调试口U1R/U1T | 为串口1功能标识，不能当SWDIO/SWCLK，也不能当USART2的PA2/PA3；已插线束未验收 |
| 电脑USB、车载5V、DAP电源输出 | 不能凭“有防反接”认定允许多源并接。S4指出Type-C 5V与排针5V相连；确认供电方案前保持隔离 |

## 6. 控制电平、真值表与01资源要求

S3第4页列出芯片输入低电平最大0.7V、高电平门限最小1.5V，输入测试包含3.3V；因此F407的3.3V输出与该芯片控制输入在资料层面匹配。结论以实物确为该AT8236及模块无反相／改板为前提；不表示可向F407输入5V，更不表示本车电平已测。编码器预期为3.3V域，其实际允许供电、推挽／开漏和上拉由硬件补规格及测量证据。

| IN1 | IN2 | 厂家定义 | 集成注意 |
| --- | --- | --- | --- |
| 0 | 0 | 双输出高阻，滑行／休眠 | 请求归零不等于主动刹车，也不等于轮子立即停稳 |
| 1 | 0 | 正向电流OUT1→OUT2 | 不是已确认的车辆前进方向 |
| 0 | 1 | 反向电流 | 车辆镜像安装后需单轮标定 |
| 1 | 1 | 两输出低，刹车 | 停车模式与持续时间由01确定，再做悬空实测 |

S3表中PWM/0与0/PWM为快衰减两方向；1/PWM与PWM/1为慢衰减两方向。GPIO/PWM极性、占空比的含义不能跨模式照搬。输入有芯片级下拉，但主控复位、高阻、断连及固件异常时的**板级默认安全态仍待验证**，不能用内部下拉代替整车测试。

以下保留I-03最初的资源要求及后续实现范围；C-02A已经完成的引脚选择以第4节及pin_plan为准，不再重复分配：

1. 为AIN1、AIN2、BIN1、BIN2分配4根独立3.3V控制线。优先评估4路硬件PWM，满足各桥两个输入切换；若选2路PWM＋2路GPIO，必须说明正反转调制／反相占空比、滑行／刹车行为及换向顺序，不能将其等同四PWM方案。本次不指定任何最终PWM针脚。
2. 两路AB相编码器分别使用TIM3 PC6/PC7、TIM4 PB6/PB7；旧TIM2 PA0/PA1候选取消。保留这两个定时器的计数资源，不将同一定时器其它通道用于要求独立计数周期的PWM；通道不同不等于计数器独立。
3. 保留USART2 PA2/PA3现有适配、SWD PA13/PA14；若变更UART需列代码与接线影响并交视觉确认。P3底部U1R/U1T不是USART2。PA2的实际引出位置需硬件确认，不在照片上猜号。
4. 核对F407VET6封装复用、板载器件、启动脚、USB与现存调试资源；逐项返回MCU端口、定时器/通道、AF、真实连接器/物理针脚及占用冲突。保持现有PB2用户灯/BOOT1及复位启动条件可用，除非01有明确变更依据。
5. 返回实际时钟来源与定时器时钟、PWM频率/极性/限幅、编码器采样周期、上电/复位默认输出、STOP/FAULT停车方式、受控换向和台架自动退出条件。现工程为HSI 16MHz，不能按旧采购文字168MHz直接计算。
6. 返回MA/MB↔左/右轮、前进方向、编码器A/B及符号的标定方法。方向和计数极性留待真实台架，不在本次冻结。

## 7. 硬件断电复核及后续测试门槛

本次以下均为**待执行项**，无实测结果。硬件在取下电池、USB及下载器供电等全部电源、确认储能已释放后再量通断；不在通电板上使用电阻／蜂鸣档。

| 项目 | 负责角色 | 必须返回的证据 | 当前结果 |
| --- | --- | --- | --- |
| 采购型号基准 | 主控确认，00归档 | 2026-10-18主控确认按原清单采购；本节第1节列明三类核心器件 | 已确认采购型号；不等同电气实测，发现具体不符再登记差异 |
| 两束6芯线逐根导通 | 硬件 | 每条MA/MB线的两端功能名、插合方向、腔位、导通值／表读数和照片；排除错位、串线 | 待核对 |
| 板内编码器转接 | 硬件 | E1A/E1B、E2A/E2B插口至左排针的导通；对地／供电短路排查 | 待核对 |
| 供电路径 | 硬件 | 电池极性、Vin+/−、Vout关系、开关覆盖、5V与3V3电源路径、USB/DAP隔离方式 | 待核对 |
| 资源设计及实物位置 | 主控／01，00核对设计，硬件复核实物位置 | C-02A的八线端口及官方排针依据；实际针位、MA/MB轮侧及默认态另核 | 资源设计已采用；实物导通与默认态待测 |

完成上述记录后仍不自动授权上电。后续由00安排独立步骤：先确认供电方案，电机与主控/视觉负载断开时测稳压输出，再分级接逻辑负载测电压和编码器电平；01交付经编译及必要电脑验证的驱动后，轮子悬空进行单轮低输出短时转停，再双轮、编码器、闭环及低速直行。电压、限流、PWM和停止门槛须在对应任务明确，不在本记录虚构数值。

首次台架记录须包含代码提交/未提交差异、协议、接线版本、供电及参数、轮侧、触发时刻、输出停止时刻与真实停稳表现，保存到[testing](../testing/README.md)。未通过前不进入地面跑圈。

## 8. 签核与变更

| 核对项 | 负责角色 | 日期／证据 | 状态 |
| --- | --- | --- | --- |
| P1–P3及官方资料核对 | 主控／02 | 2026-10-18，本文件与证据索引 | 已完成资料整理 |
| 实物／线束／供电复核 | 硬件 | 待填 | 未签核 |
| 控制接口／资源分配 | 主控／01；00回填 | C-02A资源方案及原图，2026-10-20采用 | 文档设计确认，非实物验收 |
| 接线冻结与下一阶段任务 | 00汇总验收 | 待填 | 未放行 |

v0.1首次建立：仅照片/资料级核对，包含逐线应接定义与未决项；未修改`pin_plan.md`和固件，未上电。后续必须新增实际核对日期、角色与结果，不能将本版“应接”直接批量替换成“已接通过”。

v0.2：00归档主控按清单采购的确认，纠正型号未知的表述；保留实际接线、导通及电压未验证的事实。I-03资料整理验收通过，下一步为01完成C-02A资源分配。

v0.3（2026-10-20）：00按主控先接线后编码的指令采用C-02A方案，回填八线资源、取消PA0/PA1旧候选，建立双电机首次接线指南。未修改固件，未操作板卡；主控尚未回报接线完成。
