AgrumeStly/yeye/hardware_preparation/dual_motor_wiring_guide.md

# 双电机首次接线指南

状态：v1.0，断电装配指导，尚无接线完成或通电结果。日期：2026-10-20（北京时间）。维护：00；实际装配：主控／硬件；后续固件：01。任务：I-04，关联H-02、C-02A、C-02。

依据：[原采购源](source/generate_purchase_list.py)、[逐线接线记录v0.3](wiring.md)、[C-02A资源方案](../control/docs/pin_plan.md)、[驱动照片](evidence/2026-10-18_i03/photo_01_driver.jpg)、[电机照片](evidence/2026-10-18_i03/photo_02_motor.jpg)及[厂家资料](evidence/2026-10-18_i03/README.md)。主控已确认按清单购买，2026-10-20确认硬件到齐。本阶段先接好、核对并回报，再安排编码；没有自动发送其它对话任务。

2026-10-20阶段供电调整：主控已回报电池至驱动、两只电机至驱动的线已接好（尚无导通／电压实测回报），现阶段主板可采用电脑USB→天空星Type-C供电，驱动动力后续由电池独立供给。两板只连第5节的九根信号／地线，驱动5V、3V3都不连接主板，USB-A车载供电转接板本阶段不使用。以下第3节保留为后续车载供电方案，当前不实施。接线前仍拔下电池XT30与电脑USB；接完核对后可单独给主板USB供电，驱动电池保持断开，实际驱动供电与试转待接线确认、固件完成后安排。

2026-10-20接线续报：主控在九线接法说明后回复“已接好”。00据此记录动力、电机及九根信号／地线装配已完成（主控口头确认），进入C-02B首轮开环试转编码准备；导通、电压、上电及电机转动均无本次验证记录。后续以当前电脑USB供主板方案为准，不启用第3节的车载5V供电。

2026-10-20最新供电选择（替代上面的主板USB方案）：主控要求只用DAPLink供电与下载。采用DAPLink 5V0→天空星5V、GND→GND，再接DIO、CLK、RST，共五线；天空星自身Type-C拔开、DAPLink 3V3留空，驱动5V／3V3不接主板。电机驱动仍由电池单独供电，排查阶段电池拔开。具体针位和操作见[MotorBench第10节](../control/docs/motor_bench.md)。当前只给出改接指导，尚无主控改接完成或绿灯恢复回报。

2026-10-20 C-02B固件交付：01已新增独立MotorBench并完成电脑编译与逻辑检查，尚未烧录或试转。后续下载、电池连接时机、按键A/B/AB步骤及待测项统一见[双电机台架操作说明](../control/docs/motor_bench.md)；本指南第7节“先回报再编码”为此前阶段记录，不再表示当前没有台架PWM代码。供电方案继续为电脑USB供主板、2S电池供驱动、只接九根信号／地线；本次文档更新不代表电气验收通过。

## 1. 本次使用的部件及终点

天空星STM32F407VET6青春版、AT8236 Standard／YB-MNT03-V1.0、MD310Z20_7.4V两只、2S 7.4V XT30电池、XT30U-M公头18AWG成品线一条、USB-A母座螺丝端子板一块、A转C线一条、两条电机六芯线、母对母杜邦线、22AWG红黑供电线、绝缘固定件及万用表。

接线全过程拔下电池XT30、主板电脑USB及下载器供电，驱动开关置OFF。电机固定，轮子离桌面或先不装轮；板底绝缘。最终保持电池XT30未插合，主板Type-C端也先不插入；电源线预接到USB-A端子板并标记待测。不能以开关OFF代替拔下电池。

电源路径为：2S电池 → XT30 → AT8236的Vin输入；驱动电机口 → 两只电机；驱动稳压5V/GND → USB-A端子板 → A转C线 → 天空星Type-C。底部蓝色Vout不是5V稳压口。

## 2. 电池和XT30主电源线

1. 使用清单的XT30U-M公头成品线，与电池XT30母头配对；按金属针／孔和接头正负标记核对，不按店铺外壳公母叫法或观察左右猜极性。电池原插头保留，不剪电池线、不焊带电接头。
2. 在电池仍未插合时，把成品线红线固定到驱动顶部蓝色端子的Vin+，黑线固定到Vin−。以端子旁丝印为准，不接底部Vout。18AWG负责主电流，不用杜邦线代替。
3. 松螺丝，将剥好的铜线插入夹线孔后拧紧；剥线长度按夹持深度，夹住铜芯而非绝缘皮，铜丝不外露、不跨到相邻端。轻拉确认不会脱出；不要把裸线压在螺丝头外面。
4. 电池上的小白色三针JST-XH平衡头只用于匹配的2S平衡充电，本车动力不从它取电。本阶段两种电池接头都不接其它器件。

万用表检查成品XT30的+触点确实通向Vin+、−触点通向Vin−。驱动上有电容，通断档瞬时响不单独等于短路，也不证明正常；若持续低阻或持续蜂鸣，保持断电查因。电池电压／极性只能用直流电压档测量，不能用蜂鸣档测电池，不能让两表笔桥接两个触点。

## 3. 主板的5V供电线

驱动左侧排针标有5V、GND，或者使用底部明确标5V的红色针及其对应下排GND；不要使用标3V3的位置。

| 从驱动板 | 线材 | 到USB-A母座端子板 |
| --- | --- | --- |
| 5V稳压输出 | 22AWG红线 | 5V／VBUS／V+端 |
| GND | 22AWG黑线 | GND／G／V−端 |

USB-A板的D+、D−留空。USB-A公头插该母座，USB-C头留作之后插天空星Type-C。驱动排针端用匹配母端子或焊接固定并绝缘，不能把裸线绕在针上；螺丝端压紧铜芯，防止散股。端子板底部用绝缘支撑固定。

实际5V输出和USB端子极性尚未测量：本阶段C头保持未插主板，待接线回报后先测输出再接主板。电池7.4V／8.4V不能直接进主板5V、3V3或USB；驱动3V3也不与主板3V3并联。后续电脑USB下载时，先拔主板车载USB-C，确保该主板只从一处取电。下载器及其电源线本阶段留空。

## 4. 两只电机的六芯线

电机PH2.0六芯插头按防呆方向插稳，另一端逐根按功能接驱动。若为整块六针壳，先核对六个功能是否一一对应，不能因为能插上就认为线序正确；不兼容时先不通电，也不强插。

| 电机丝印 | A电机接驱动MOTOR-A | B电机接驱动MOTOR-B | 用途 |
| --- | --- | --- | --- |
| M1 | AO1 | BO1 | 电机绕组端1 |
| M2 | AO2 | BO2 | 电机绕组端2 |
| G | GND | GND | 编码器地 |
| V | 3V3 | 3V3 | 编码器供电 |
| B | E1B | E2B | 编码器B相 |
| A | E1A | E2A | 编码器A相 |

按已有P2照片，该束线电机端为：蓝=M2、红=V、绿=A、白=B、黑=G、黄=M1。由此该束线接MOTOR-A时为黄→AO1、蓝→AO2、黑→GND、红→3V3、白→E1B、绿→E1A。颜色只用于这张照片中的已识别线束，另一束仍以电机丝印及两端导通为准，不能把颜色当通用标准。尤其红色V是编码器电源，不是电池正极。

A/B暂作为电机编号，在电机和线束贴标签；装车后记录A/B实际对应左还是右。两电机镜像安装后的前进方向由后续代码和单轮试转确定，此时不随意交换编码器电源或AB线。

## 5. 驱动与主板九根信号／地线

用母对母杜邦线，逐根找主板背面端口丝印，接到同一物理针；观察背面时不要把图纸左右直接当实物左右。驱动按已有照片开关朝上。

| 驱动信号 | 主板背面标签 | MCU端口 | 原理图排针号 |
| --- | --- | --- | --- |
| AIN1 | E09 | PE9 | P1.15 |
| AIN2 | E11 | PE11 | P1.17 |
| BIN1 | E13 | PE13 | P1.19 |
| BIN2 | E14 | PE14 | P1.22 |
| E1A（左侧信号排针） | C06 | PC6 | P2.35 |
| E1B（左侧信号排针） | C07 | PC7 | P2.36 |
| E2A（左侧信号排针） | B06 | PB6 | P2.23 |
| E2B（左侧信号排针） | B07 | PB7 | P2.22 |
| GND | GND | GND | 使用明确标GND的排针 |

驱动控制针从上到下是AIN2、AIN1、BIN2、BIN1；编码器信号针从上到下是E2A、E2B、E1A、E1B，后面是ADC、5V、GND、3V3。E14换列，B06和B07不在同一行，不能把几根母头连成一排盲插。取消旧A00/A01编码器接法；ADC留空。

GND线提供可靠信号参考，USB供电线中虽也带地，仍保留独立信号地；动力大电流经电池到驱动回流，不能让电机电流串经主板细地线。

## 6. 清单其余物品本阶段的处理

- K230D、摄像头、TF卡、扬声器及MX1.25音频线、第二个USB-A转接板和第二条USB线保留给视觉，双电机独立试转暂不接。UART也暂不接。
- DAPLink与SWD线在后续编码下载阶段连接，本阶段留空，避免随配线中的5V／3V3造成多源供电。
- 分压电阻、电池采样线及额外电容本次不要求加入，沿用当前暂缓电池采样／额外470μF的决定。100nF电机抗干扰电容后续核对是否已有后，只能跨对应电机M1/M2功率端，不能跨A/B编码器端；本阶段不为了接全清单而盲焊。
- FR4底板、尼龙柱、扎带、魔术贴及热缩管用于固定和绝缘，不是电路连接；线束避开轴、齿轮和轮胎。
- UC2与小米USB电源是独立充电组合，不插入车载供电回路。需要充电时先把电池从车上断开，使用UC2匹配的2S口及厂家流程；不得把电池或充电器接到USB-A供电转接板。

## 7. 本阶段完成与回报

完成标准：主电源成品线已接驱动但XT30未插电池；电机六芯线功能对应；主板九根信号／地线连接；5V至USB转接板接好但C头未插主板；无裸露接头和松散铜丝。接线核对不能写成电压或电机试转通过。

主控回报接好及是否完成导通检查；如需核对位置，提供整套俯视、驱动Vin与USB端子、主板信号针三处清晰照片即可，不重复拍型号铭牌。下一阶段先核对并测稳压供电，再由00生成01固件任务；原工程目前尚无真实PWM输出，接好不会自动转动。本指南没有执行任何实物测量、改线、上电或编码，也没有上传。
