AgrumeStly/yeye/hardware_preparation/i05_measurement_guide.md

# I-05：电机无动作测量步骤

版本：v1.0，测量准备完成，现场未测。日期：2026-10-21（北京时间）。主控／02整理；硬件借仪表、接探头及测量；主控配合记录；00验收结果，证据指向固件时再交01。

依据：[I-05任务](i05_motor_power_diagnosis_task.md)、[现象记录](../testing/2026-10-21_motor_bench/no_rotation_record.md)、[当前接线](wiring.md)、[引脚资源](../control/docs/pin_plan.md)、[R2交付](../control/docs/motor_bench_r2_task.md)。填写[测量结果表](../testing/2026-10-21_motor_bench/i05_measurement_results.md)。

**今天先做的只有：借万用表，测电池静置电压、驱动Vin在OFF／ON下的电压。全程不按KEY，不触发A／B／AB。** 本文件先交付操作说明，没有执行实体测量；静态结果回来后再决定是否需要后续项目。第5节是条件式测量设计，不授权新的电机脉冲。

2026-10-21 R3后续说明：本方案编制时使用R2为代码依据；当前已交付R3，并收到[主控活动／停止快照](../testing/2026-10-21_motor_bench/r3_watch/README.md)，板内启用及500ms停止配置符合预期。静态M01–M03保持适用，不回刷R2；后续记录以现场实际版本为准。快照没有直接测到Vin、外部PWM或H桥输出，不能替代本方案实测。

2026-10-24当前持续目标续报：MotorContinuous 0x020B1001的[板内启用／KEY停止配对](../testing/2026-10-24_motor_continuous/watch/README.md)已由01核对符合。主控表示可去实验室查看示波器，当前第一轮改按[无动力示波器测量单](motor_scope_check.md)比较PE9与AIN1，动力电池始终拔开，只测逻辑输入，不复用下文R2的500ms／接动力捕获设计；仪器及波形未实测。下文保留历史测量准备，不表示重新要求静态电压或主控重复同组Watch。
## 1. 已知事实与本次边界

- 沿用已确认的天空星F407青春版、AT8236 Standard／YB-MNT03-V1.0、MD310Z20_7.4V和2S动力电池；沿用主控“接线正确”的确认，不重新识别型号或索要全套接线照片。
- 主控回报R2下载Verify OK、绿灯正常；单次A的30%／20kHz／500ms完全无动作、无声音。根因未定，不能把无声音或未转动等同无电源／无PWM。
- 保留当前固件。板内Watch版本尚未逐项回报，不补写成已核验。预期版本0x020B0002，BIN SHA256为`99b03ae743aa1021aeb5cb49192f2b24771e30d0872a577b17b3b29bbbd1d967`。
- 主板只由DAPLink的5V0供电；主板Type-C空着；驱动由独立电池供电；两板共地，驱动5V／3V3不接主板。绿灯正常不能证明驱动有动力电源。
- UC2继续停用、不参与测量。主控已确认电池与UC2断开、冷却且无外观异常；静态电压、单节平衡、带载能力仍没有测量结论。
- 开始前由现场实际执行驱动OFF并拔XT30，不能从上一轮操作指导推定已断开。硬件在场准备仪表以前，保持此状态，不继续试转。

## 2. 硬件借用清单与表笔准备

第一批只需一台可靠的数字万用表、完好绝缘表笔及能分别固定在两端且不碰邻针的绝缘微夹。仪表由硬件检查，主控不需要终端操作。暂不因缺示波器阻塞静态测量。

1. 万用表黑线插 **COM**，红线插 **V／VΩ**。红线不插A、mA、μA或10A孔。
2. 旋钮选 **直流电压V⎓／DCV**，不是V~、Ω、蜂鸣、二极管、电流或电容档。多功能同一档位由硬件用SELECT切到DCV，查看屏幕单位为V。
3. 自动量程可直接用DCV；手动量程选20V或更高的合适直流电压档，不选2V／200mV测2S电池。关闭HOLD、REL／相对归零，避免旧数值或人为归零误导。
4. 硬件先用已知低压直流源验证仪表能读出正确极性和大致数值；此项不使用UC2。测试完恢复DCV。
5. 黑表笔接指定负端／GND，红表笔接指定正端。夹具只能触及目标金属点，裸露端不能跨接相邻触点；电池接头由硬件使用适配绝缘转接或受控表笔接触，不把粗探针硬塞进XT30、不剪线、不改接头。
6. 除对独立电池触点作电压读数外，板上的探头位置均在**驱动OFF、XT30拔开、DAPLink USB拔开且确认无残余供电**时布置。固定探头后再按相应步骤供电；带电时不移探头、不拔插控制／电机线、不松端子螺丝。
7. 结束或换点先驱动OFF、拔XT30，再拔DAPLink USB；随后先移红探头、再移黑探头。始终保持电压档；本次不串电流表，也不做带电通断测试。

若只有无绝缘、不能稳定接触目标点的表笔，硬件先借适配夹具，跳过该点并记“接触条件不足”，不靠手滑风险完成读数。以上插孔、档位和先黑后红／先红后黑顺序依据F5。

## 3. 测点与资料依据

参考已归档的[驱动正面照片](evidence/2026-10-18_i03/photo_01_driver.jpg)，只用于找测点，不重新验型号或接线：**板上开关在上方时，上面的蓝色端子是Vin输入；下方蓝色端子标Vout，不能当5V输出。** Vin正负以端子附近丝印及现有已确认线的端点为准，不按照片左右或线色猜测。

| 点号 | 红探头／信号测点 | 黑探头／参考点 | 位置和依据 | 读数含义 |
| --- | --- | --- | --- | --- |
| BATT | 电池独立XT30主放电口＋触点 | 同口−触点 | 电池原接头正负标识；只测既定主放电口，不探白色三针平衡头 | 整包静置电压与测量极性 |
| VIN | 驱动顶部蓝色端子Vin+的可接触导电点 | 同端子Vin−的导电点 | P1照片、F1第1页接线图顶部电源端；硬件确保探到金属而非塑料／漆面 | 电池是否到达驱动外部输入端；**不等于已测芯片内部VM** |
| D5 | 驱动左上8针组丝印5V，自上第6针 | 同组GND，自上第7针 | P1照片；F1第1页5V/GND标识，F2第1页5V参数 | 驱动板载稳压输出，不能代替Vin／VM |
| D3 | 同组3V3，自上第8针 | 同组GND，自上第7针 | P1照片、F1第1页、F2第1页3.3V参数 | 编码器逻辑电源输出，不能据此证明H桥功率部分正常 |
| M5／M3（按需） | 天空星H1.7的5V／H1.2的3V3 | H1.4或H1.6 GND | F4官方H1调试口图；仅由硬件用安全夹具测，保持DAPLink供电接线 | 主板电源；灯正常而无电源异常证据时不优先测 |
| MCU_A1 | PE9，P1.15／E09 | 主板GND | 当前资源表；F4双排针图，不是芯片封装脚15 | R2 A桥控制源端 |
| DRV_A1／A2 | 驱动左下控制排针AIN1／AIN2，自上第2／第1针 | 驱动左上信号GND | P1照片与F1第1页；当前PE9→AIN1、PE11→AIN2 | 驱动实际收到的逻辑信号 |
| OUT_A | 差分测量正端AO1、负端AO2 | **不是用普通接地夹夹AO2** | MOTOR-A最上两针；F1第1页及F3第5页 | A桥绕组两端的动态电压，留待第5节 |

D5／D3位于相邻针，不能用大鳄鱼夹横跨两针。没有安全可及位置时不拆在用接线、不探芯片腿，记录未测。未取得本板开关与内部VM的完整电源走线确认，因此**不指定芯片VM／焊点为初学者测点，也不保证OFF时Vin或某稳压轨一定为0V**。

### 电压判读范围：资料值、筛查与局限

- 2S普通LiPo：标称7.4V，满电上限8.4V。F6第1页“Lithum Polymer (Lipo) battery warnings”第4条给出单节约3.3–4.2V，折算整包约 **6.6–8.4V**，仅作本次静置初筛；靠近边界时由硬件结合表精度判断，不把8.40与8.41机械分成好坏。整包在此区间不能证明两节均衡、容量／内阻正常或带载不掉压。
- 若明显低于6.6V、高于8.4V、读数异常跳动、极性与标识相反或无法可靠接触，先停在电池边界，不接驱动。由硬件核验仪表／接触及电池状态，结果返回00；不自行用UC2补充电，不认定一定损坏。单节核查由硬件用匹配2S电池检测器另行完成，不让初学者徒手探相邻平衡头。
- AT8236标准板厂家输入范围 **5–12V**（F2），而芯片原厂手册第1页给出VM范围5.5–36V（F3）；两者不是本车相同的验收范围。当前用2S电池，应先满足前述电池筛查，再检查Vin与电池读数相近且稳定，不能因5V落在模块宣传范围内就认定2S电池健康。
- ON且未触发电机时，VIN应接近BATT。记录`BATT−VIN`及仪表精度；若差异明显超过测量误差，先排查该段端子／连接／电源路径，不为没有资料的线损设一个伪“厂家合格阈值”。这也不能排除运行时的压降。
- D5、D3的资料标称分别为5.0V、3.3V（F2）。本次资料没有完整模块输出精度／负载曲线，故只把“接近标称、稳定”当静态筛查，不编造±5%合格证；0V、明显偏低、接近电池电压或明显不稳均停止后续动态测量并返回硬件核查。待机不转时，OUT_A为高阻态，单点／空载电压没有固定应等于电池电压的要求。

## 4. 第一批：硬件协助测电池和Vin，不触发电机

### 4.1 M01：独立电池静置电压

1. 驱动OFF、XT30拔开，DAPLink USB拔开；UC2及主板Type-C保持断开。电机与控制线保留，不重新接线。
2. 电池置于绝缘稳定位置。硬件检查万用表COM／V孔与DCV档，黑笔接电池−，红笔接＋，分别固定、防止接头短路。
3. 等显示稳定，记录三次相隔约1s的数值及单位、正负号、仪表量程。只测静置，不外接负载。
4. 先移红、再移黑。按第3节判断；异常先返回M01，**不继续连接驱动**。

### 4.2 M02：驱动OFF时Vin输入

1. M01符合静置初筛后，在全部电源仍断开的条件下，硬件将黑夹固定Vin−、红夹固定Vin+，隔开相邻端子并固定表线。保持DCV，不用螺丝刀在带电端子上调整。
2. 只恢复DAPLink给主板供电，Keil处于退出调试会话状态，不暂停、不单步；KEY、BOOT0均松开。确认独立待机每组1闪。异常灯态或主板复位则不接XT30；必要时改用第6节无动力Watch。
3. **驱动仍OFF**，由主控在硬件确认探头固定后接上电池XT30。不触碰KEY，记录Vin三次数值，并记录OFF状态。
4. Vin在OFF时仍可能接近电池电压，因为外部输入端不一定被板载开关隔离。也可能为0，取决于实际电路和可测端点；先如实记下，**不据OFF的数值单独判断开关好坏**。

### 4.3 M03：驱动ON时Vin输入

1. 原探头位置不动，KEY保持松开、轮子悬空，主板仍正常待机；由主控只把驱动开关置ON，不做任何试转按键操作。
2. 硬件读取Vin三次、记录范围和是否持续下跌。若异常发热、异味、冒烟、火花、非预期运动或显著异常电压，直接OFF并断XT30，结束测量。
3. 记录完成后立即OFF、拔XT30，再断DAPLink USB；先移红、再移黑。记录这些动作是否实际完成。
4. 对照M01／M02／M03，返回结果。**本批到此结束，不顺手按KEY、不继续B／AB，也不为再听声音重复A。**

### 静态结果决定下一步

| 结果 | 目前能缩小到的边界 | 下一动作（返回00后安排） |
| --- | --- | --- |
| M01电池本身不符合初筛或接触不可靠 | 还不能从电池端放行 | 硬件核对仪表／接头测量、必要时用2S检测器查单节；不接驱动，不自行恢复UC2 |
| M01符合初筛，M03为0或明显偏离M01 | 电池到驱动外部输入这一段尚不成立 | 全部断电后由硬件仅对这段XT30／端子／开关相关路径定点检查；不重新要求全套型号照片，不先判驱动坏 |
| M03接近M01且稳定 | 无负载时外部输入有电 | 若需要，先安排D5／D3静态读数；并行准备第5节捕获设计，但不放行新脉冲 |
| M03正常而D5／D3明显异常 | 稳压／局部电源边界待定位 | 硬件按具体轨核查；D5／D3不等同内部VM，不能直接判H桥正常或损坏 |
| 电源静态均无明显异常 | 仍不能证明脉冲期间供电、控制或输出正常 | 00依据结果决定有仪表的同步捕获任务；保持R2参数 |

D5／D3若另行安排，分别在全断电下固定各自探头，然后DAPLink启动待机、驱动OFF接XT30、再ON；不按KEY。每点记录OFF／ON数值，结束均OFF拔XT30、断DAPLink后才换点。它们只是测量，绝不把驱动5V／3V3接到主板。没有安全探头接触条件则跳过，返回“未测”。

## 5. 后续设计：控制输入与H桥输出同步捕获

**当前只准备，等待M01–M03及00的后续测量任务。不得按本节自行再触发一次。** 普通万用表留给静态电压；0.5s内显示0或一个平均数均不足以判定PWM有无。不可改为恒定输出、增大占空比、延长时间或用B／AB代替定位。

### 5.1 硬件准备和单次捕获设置

- 借能保存单次波形的示波器及匹配量程的差分探头；若需同时比较更多数字点，可加支持3.3V输入的逻辑分析仪。逻辑分析仪只接控制信号和系统GND，不接Vin、AO1／AO2功率输出。
- 接地示波器的普通探头地夹只能接已确认的**系统GND**，不能夹AO1或AO2。H桥两端电压使用额定共模／差模范围覆盖电池及开关瞬变的差分探头正端AO1、负端AO2。不能拆示波器保护地、不能以拔电脑电源或电池供电仪表的外观推定隔离；硬件核对DAPLink／USB／示波器接地路径后才布线。依据F7。
- 所有探头在全断电下固定；不用初学者带电手持探芯片腿。若只能接地无差分或无可靠输出接触点，先只计划逻辑输入捕获，输出项目标未测，不换成危险接地法。
- 建议单次Single捕获，以AIN1首个上升沿触发、阈值约1.5V，DC耦合，记录约1s并保留至少100ms前触发。采样率至少1MS/s，并保证约1s×1MS/s=每通道至少100万采样点；更高速需相应内存。以上是本次工程建议，不是厂商冻结参数。先核对仪表Single／存储深度／探头倍率及输入范围，不能按一次后才发现没武装捕获。
- 硬件按可用通道计划同时记录：Vin对GND、MCU PE9、驱动AIN1、驱动AIN2、AO1−AO2；如通道不够，用适配逻辑分析仪补数字边界，或在任务中列明本次未覆盖项。不能为了补齐通道就自动再次触发。
- 保留30%／20kHz／500ms、人工一次A及原停止保护；无动力Watch／独立待机正常后退出Keil调试。后续任务还须明确动力接入、捕获武装、一次A、OFF拔XT30与数据保存顺序，届时另列实体操作清单。本版不复用“再按一次”作为默认指令。

### 5.2 预期波形与判读边界

| 同步信号 | R2对应的预期 | 哪种证据影响下一步 |
| --- | --- | --- |
| Vin对驱动GND | 运行前及500ms窗口内不出现明显塌陷 | 只静态正常、脉冲时塌陷，应先回到动力供电段，不能据此独判电池内阻或驱动短路 |
| PE9（P1.15） | A阶段约0/3.3V、20kHz；周期50μs，高约15μs、低约35μs；包络约500ms | 先有有效触发/完整时间窗及版本／状态证据，才可把“源端无PWM”交00转01；未触发示波器不等于MCU没输出 |
| 驱动AIN1 | 应收到与PE9对应的脉冲 | PE9有而AIN1无／失真，边界在控制传输路径；硬件只对该段端点／共地做定点测量，不改写主控既有接线确认 |
| PE11／驱动AIN2 | A诊断中保持低，非反向调制 | 异常组合先返回实际端点、电平／波形及时间窗；不直接判固件或驱动坏 |
| AO1−AO2 | 驱动窗口内应存在与A桥输入相应的绕组激励；PWM关闭时为快衰减／随后00高阻 | 不强求每个关断区间恰为0；电机电感续流、反电动势会影响形状。输入和Vin窗口均有效而输出缺失，才缩小到驱动电源／使能／保护／输出边界，由硬件查，不直接换板 |
| 停止后 | 四控制脚撤低，00滑行 | 高阻输出的悬空电压不是固定验收值；车轮是否停稳另记，不能由输出清零代替 |

若驱动口确有激励而电机仍无动作，下一边界是驱动口到电机绕组及机械负载；可先由硬件在完全断电后作定点检查，不能短接电池直驱、重复大功率起转或据平均电压直接认定电机坏。每份波形保留时间轴、幅度、探头倍率、触发点及捕获是否成功。

## 6. 可选：只在无动力时读取Keil Watch

不是要求重新下载或重编译，也不是第一批电源测量的替代品。若版本／待机状态确实需要补证，驱动OFF且**XT30已拔开**，DAPLink按既定五线给主板供电：

1. Keil打开现有工程选MotorBench，Ctrl+F5进入硬件调试；不用Download、不改代码。禁用断点，View → Watch Windows → Watch 1加入下表变量。
2. 勾选View → Periodic Window Update，按F5 Run，保持KEY松开。Run to main停在入口的零值不作故障结论；运行数秒后记录两次读数，不强改值。
3. 正常预期：`g_motor_bench_revision=0x020B0002`；`g_motor_bench_ms`连续增长；`g_motor_bench_fault=0`；`g_motor_bench_watchdog_stage=4`；`g_motor_bench.state=READY(1)`；`g_motor_bench.output_mask=0`。
4. 异常值如实返回，停在无动力边界，不自行烧录或清fault。Ctrl+F5退出调试；拔DAPLink USB至灯灭后再恢复，KEY/BOOT0松开，观察独立待机。后续任何接动力测量都不保持暂停／单步状态。

Watch仅解释软件运行状态，不能证明管脚PWM、驱动输入电平或H桥输出。方法沿用[MotorBench第12.2节](../control/docs/motor_bench.md)。

## 7. 依据索引及验证范围

| 编号 | 已核对的原始来源 | 页码／图及用途 |
| --- | --- | --- |
| F1 | [亚博官方STM32教程](https://www.yahboom.net/study/Dual-MD-Module/6604/)，[原始PDF副本](evidence/2026-10-18_i03/vendor_driver_stm32.pdf) | 第1页整板接线图：Vin顶部输入、5V／GND、AO1／AO2和AIN1／AIN2功能；只沿用模块端，不照搬F103针脚 |
| F2 | [亚博官方仓库模块介绍](https://github.com/YahboomTechnology/2-Channel-Motor-Driver-Module/blob/main/1.Introduction%20of%20Module/Introduction%20of%20Module.pdf)，[本地副本](evidence/2026-10-18_i03/vendor_driver_introduction.pdf) | 第1页“standard version”参数表：输入5–12V，输出标称5V／3.3V；不是已测稳压精度或开关拓扑 |
| F3 | [AT8236原厂内容副本](evidence/2026-10-18_i03/at8236_datasheet.pdf)，第三方托管性质见[来源索引](evidence/2026-10-18_i03/README.md) | 第1页芯片5.5–36V；第4页门限；第5页H桥逻辑与快衰减；00高阻、10正向、11刹车，芯片范围不替代模块范围 |
| F4 | 立创[双排针原图](../control/docs/evidence/2026-10-18_c02a/schematic_20240815_203023.png)、[H1原图](../control/docs/evidence/2026-10-18_c02a/schematic_20240815_044555.png)及[官方页面](https://wiki.lckfb.com/zh-hans/tkx/hardware/schematic.html) | P1.15=PE9、P1.17=PE11；H1.7=5V，H1.2=3V3，H1.4/6=GND。当前实际功能由R2及资源表确定 |
| F5 | [Fluke直流电压测量说明](https://www.fluke.com/en-ie/learn/blog/digital-multimeters/how-to-measure-dc-voltage-with-a-digital-multimeter) | 网页Step 1–4及接孔提醒：DCV、COM／V、不将A／mA孔跨接电源 |
| F6 | [Gens ace／Tattu通用LiPo说明](https://genstattu.com/content/instock/Tattu-Soft-UAV-pack-Manual.pdf) | 第1页“Lithum Polymer (Lipo) battery warnings”第4条：约3.3–4.2V/节；2S换算为本次静置初筛，不作为实测或本车起转门槛 |
| F7 | [Tektronix探头说明](https://www.tek.com/en/documents/whitepaper/abcs-probes-primer) | 网页“Floating Measurements”“Differential Measurements”：浮动节点的接地短路风险、差分／隔离测量，不移除示波器保护地 |
| F8 | [当前PWM适配](../control/Drivers_Custom/Motor/motor_bench_pwm.c)、[参数](../control/Drivers_Custom/Motor/motor_bench_pwm.h)、[入口](../control/Core/Src/motor_bench_main.c)、[操作第12节](../control/docs/motor_bench.md) | 本地R2：PE9 PWM／PE11低、20kHz／30%／500ms、版本0x020B0002与Watch命名；不是实物波形证据 |

本次使用grill-me执行清晰任务；使用diagnosing-bugs停在建立真实测量反馈的准备阶段。因未获现场操作授权、无仪表，未运行实物复现或测试根因假设，没有用电脑模型替代测量，也未进入修复阶段。采用PDF阅读流程复看F1／F2页图，核对F3已有页图及F6原文；没有生成或编辑PDF。

开始位置：D:/Projects/yeye，main，HEAD `82640aba4cf7aa4f30db14b486aef852936118fe`，已有未提交修改。保持原分支及R2产物；本次仅保存测量说明、待填表及状态/导航，未重编译、烧录、访问板卡／仪表、发跨聊天消息、提交或上传。
