AgrumeStly/yeye/testing/2026-10-25_encoder/software/BoardSelfTest_build.txt

*** Using Compiler 'V5.06 update 5 (build 528)', folder: 'C:\Keil_v5\ARM\ARMCC\Bin'
Build target 'BoardSelfTest'
compiling stm32f4xx_gpio.c...
compiling misc.c...
compiling stm32f4xx_usart.c...
compiling board_self_test.c...
compiling board.c...
compiling stm32f4xx_rcc.c...
linking...
Program Size: Code=1380 RO-data=440 RW-data=48 ZI-data=1152  
FromELF: creating hex file...
"..\build\firmware\board_test\board_self_test.axf" - 0 Error(s), 0 Warning(s).
Build Time Elapsed:  00:00:01
