AgrumeStly/yeye/testing/2026-10-25_encoder/software/EncoderBench_build.txt

*** Using Compiler 'V5.06 update 5 (build 528)', folder: 'C:\Keil_v5\ARM\ARMCC\Bin'
Build target 'EncoderBench'
assembling startup_stm32f407xx.s...
compiling encoder_bench.c...
compiling encoder_counter.c...
compiling stm32f4xx_gpio.c...
compiling stm32f4xx_tim.c...
compiling stm32f4xx_iwdg.c...
compiling encoder_hw.c...
compiling misc.c...
compiling encoder_bench_main.c...
compiling stm32f4xx_rcc.c...
linking...
Program Size: Code=4500 RO-data=424 RW-data=60 ZI-data=1236  
FromELF: creating hex file...
"..\build\firmware\encoder_bench\encoder_bench.axf" - 0 Error(s), 0 Warning(s).
Build Time Elapsed:  00:00:02
