AgrumeStly/yeye/testing/2026-10-25_encoder/software/HardwareBench_build.txt

*** Using Compiler 'V5.06 update 5 (build 528)', folder: 'C:\Keil_v5\ARM\ARMCC\Bin'
Build target 'HardwareBench'
compiling board.c...
compiling misc.c...
compiling stm32f4xx_rcc.c...
compiling stm32f4xx_usart.c...
compiling stm32f4xx_gpio.c...
linking...
Program Size: Code=2112 RO-data=424 RW-data=36 ZI-data=1108  
FromELF: creating hex file...
"..\build\firmware\yeye_control.axf" - 0 Error(s), 0 Warning(s).
Build Time Elapsed:  00:00:01
