AgrumeStly/yeye/testing/2026-10-25_encoder/software/LogicDemo_build.txt

*** Using Compiler 'V5.06 update 5 (build 528)', folder: 'C:\Keil_v5\ARM\ARMCC\Bin'
Build target 'LogicDemo'
"..\build\firmware\logic\logic_demo.axf" - 0 Error(s), 0 Warning(s).
Build Time Elapsed:  00:00:00
