AgrumeStly/yeye/testing/2026-10-25_encoder/software/MotorDirect_build.txt

*** Using Compiler 'V5.06 update 5 (build 528)', folder: 'C:\Keil_v5\ARM\ARMCC\Bin'
Build target 'MotorDirect'
compiling motor_bench.c...
compiling stm32f4xx_iwdg.c...
compiling misc.c...
compiling stm32f4xx_gpio.c...
compiling motor_direct_main.c...
compiling motor_direct_gpio.c...
compiling stm32f4xx_rcc.c...
compiling stm32f4xx_tim.c...
linking...
Program Size: Code=3888 RO-data=424 RW-data=64 ZI-data=1184  
FromELF: creating hex file...
"..\build\firmware\motor_direct\motor_direct.axf" - 0 Error(s), 0 Warning(s).
Build Time Elapsed:  00:00:01
