AgrumeStly/yeye/testing/2026-10-25_encoder/software/MotorDirectB_build.txt

*** Using Compiler 'V5.06 update 5 (build 528)', folder: 'C:\Keil_v5\ARM\ARMCC\Bin'
Build target 'MotorDirectB'
assembling startup_stm32f407xx.s...
compiling motor_bench.c...
compiling motor_direct_main.c...
compiling stm32f4xx_tim.c...
compiling stm32f4xx_rcc.c...
compiling misc.c...
compiling stm32f4xx_iwdg.c...
compiling motor_direct_gpio.c...
compiling stm32f4xx_gpio.c...
linking...
Program Size: Code=3872 RO-data=424 RW-data=64 ZI-data=1184  
FromELF: creating hex file...
"..\build\firmware\motor_direct_b\motor_direct_b.axf" - 0 Error(s), 0 Warning(s).
Build Time Elapsed:  00:00:01
