AgrumeStly/yeye/testing/2026-10-25_encoder/software/MotorPwm_build.txt

*** Using Compiler 'V5.06 update 5 (build 528)', folder: 'C:\Keil_v5\ARM\ARMCC\Bin'
Build target 'MotorPwm'
assembling startup_stm32f407xx.s...
compiling motor_bench.c...
compiling stm32f4xx_rcc.c...
compiling stm32f4xx_gpio.c...
compiling motor_bench_pwm.c...
compiling motor_bench_main.c...
compiling stm32f4xx_iwdg.c...
compiling misc.c...
compiling stm32f4xx_tim.c...
linking...
Program Size: Code=4908 RO-data=424 RW-data=64 ZI-data=1288  
FromELF: creating hex file...
"..\build\firmware\motor_pwm\motor_pwm.axf" - 0 Error(s), 0 Warning(s).
Build Time Elapsed:  00:00:01
