AgrumeStly/yeye/testing/2026-10-25_motor_pwm/software/MotorBench_build.txt

*** Using Compiler 'V5.06 update 5 (build 528)', folder: 'D:\software\Keil5\ARM\ARMCC\Bin'
Build target 'MotorBench'
compiling motor_bench.c...
compiling motor_bench_pwm.c...
compiling motor_bench_main.c...
linking...
Program Size: Code=4908 RO-data=424 RW-data=64 ZI-data=1288  
FromELF: creating hex file...
"..\build\firmware\motor_bench\motor_bench.axf" - 0 Error(s), 0 Warning(s).
Build Time Elapsed:  00:00:00
