AgrumeStly/yeye/testing/2026-10-30_new_board_flash/record.md

# 同型号新主板烧录与电机复测记录

日期：2026-10-30（北京时间）。执行范围：主控授权的本地编译、DAPLink烧录与校验；现场硬件信息由主控确认。本记录供01／02接续、00核对，不替代全局状态页。

记录分为首次EncoderBench烧录与后续电机复测两个阶段；下方原烧录结果保留当时的验证边界，最新现场反馈见文末“电机复测续报”。

## 来源、版本与验收范围

主控反馈原主板和驱动板均已损坏，已购买新主板、新驱动，新主板已连接；随后确认“配置型号都和之前的一模一样”。沿用天空星STM32F407VET6青春版、原驱动型号与既有下载链路。损坏原因为待核实，未据此改写旧板历史测试，也未确认新驱动的供电、接线或动作通过。

工作区：`D:/projects/projectsyeye`；分支：`codex/current-version-20261025`；来源HEAD：`9520eeb481169f88146afe541b4d53617c7728eb`，开始时工作区干净。本轮未改固件源码、受版本管理的工程或轮侧参数。

按[主控入口](../../control/README.md)与[C-02C](../../project_planning/tasks/C-02C.md)，本轮“最新程序”采用独立`control/MDK-ARM/encoder_bench.uvprojx`的EncoderBench，版本`0x020C0001`。它读取双编码器，初始化后持续将PE9／11／13／14保持低电平，不提供电机试转或整车循迹功能。已有MotorPwm等入口保留。

比赛依据：[比赛文档](../../competition/比赛文档.md)第三部分项目要求与评分表，基本功能为顺时针自动完成一圈、5分钟以内，碰边扣分、完全出界失败，基本功能满分60分。本轮恢复固件载入能力，为后续编码器反馈及运动验证提供基础；没有实测加分或完赛结论。队内本次验收指标为编译零错误零警告、产物与既有版本一致、实际下载日志出现Programming Done和Verify OK。

## 实际操作与证据

- Windows实际枚举到LC DAPLink、MBED VFS及CMSIS-DAP接口；未发现运行中的Keil窗口。下载器存储信息为DAPLink 0258，USB VID_0D28／PID_0204。
- 使用本机`D:/software/Keil5`、ARMCC 5.06 update 5 build 528，执行现有`control/tools/build_encoder_bench.ps1`。结果Code4500／RO424／RW60／ZI1236，零错误零警告。[原构建日志](build.log)。
- BIN为4984字节，SHA-256：`e5587b20177dde0119215350b6b59f4e21d4820a3541945588a7a2e2ee5ea7f8`，与C-02C已归档版本一致。实际AXF路径：`control/build/firmware/encoder_bench/encoder_bench.axf`。
- 本机缺少EncoderBench的uvoptx，因此从既有MotorPwm本机配置生成独立配置，只调整目标名、列表路径和Watch变量，去除旧界面分组。沿用CMSIS-DAP／SWD／1MHz、STM32F4xx_512.FLM、FLASH起点0x08000000及512KiB范围；调试自动下载关闭，沿用不勾Reset and Run。uvoptx被Git忽略，仅为本机设置。
- 通过Keil命令行`-f`对该独立工程执行显式下载，Keil进程退出码0。[原下载日志](download.log)显示：

```text
Erase Done.Programming Done.Verify OK.Flash Load finished at 21:03:18
```

此为Keil实际下载／校验结果；未另外执行整片Flash导出或RAM运行变量读回。

## 结果与边界

本轮新主板的EncoderBench编译、烧录及Keil校验完成。没有启动额外调试会话、主动执行下载后复位运行、发送启动命令或安排电机动作；实际灯态、独立重启、编码器读数、新驱动及整车表现待现场验证，不用旧板结果补填。

主控保持驱动OFF、动力电池拔开，按新主板RST复位后，正常预期为绿灯亮／灭各约500ms；这是操作预期，尚未收到现场结果。KEY（对应WKUP）在此固件中不会启动电机。接续操作见[EncoderBench教程](../../control/docs/encoder_bench.md)，当前物理轮侧与软件通道对应仍以[轮位入口](../../hardware_preparation/wheel_mapping.md)为准。

本次只本地留证，未提交、上传或跨聊天发送消息。00可读取本记录更新全局摘要；本轮执行不接替00身份。

## 2026-10-30：电机复测续报

维护：主控／01记录，主控执行现场操作。依据为主控在同型号新主板、新驱动板复测对话中的直接反馈；不是代理操作板卡取得的结果。

主控先要求沿用原连线测试左右两个马达，随后询问烧录按键以及驱动板ADC／5V／GND／3V3与主板的连接方式。在收到MotorPwm工程选择、A→B→AB分阶段触发说明及当前DAPLink单源供电接线说明后，主控明确回报：

> 旋转正常，记录

据此登记本次新主板、新驱动板组合的**电机旋转正常（主控现场文字确认）**。本轮已取得机械旋转反馈，不再将新板电机动作概括为完全未验；具体项目按以下证据边界记录。

| 项目 | 本次证据与结论 |
| --- | --- |
| 电机旋转 | 主控明确确认“旋转正常”；未逐一拆分A／B测试结果 |
| 指导所用工程与参数 | MotorPwm，`control/MDK-ARM/motor_pwm.uvprojx`；源码预期版本0x020B0004、1kHz／50%／每阶段500ms。仅为本次指导基线，未取得本轮目标版本读回或MotorPwm下载日志 |
| 接线与供电 | 主控说明连线接口与之前相同；已指导驱动GND接主板GND，ADC／5V／3V3不接主板，主板沿用DAPLink供电。未收到逐线照片、导通或电压实测，不把接线指导补写为逐项实测 |
| 当前左／右轮与驱动A／B对应 | 未单独回报，继续以[当前轮位入口](../../hardware_preparation/wheel_mapping.md)为准，不由物理名称猜通道 |
| 两轮均向车头前进、AB同时运行 | 未单独确认，不以“旋转正常”外推为前进极性标定或双轮并转验收 |
| 自动撤驱动、机械停稳与灯态 | 未单独回报，不补写为约500ms自动停转、KEY停止或灯态均通过 |
| 附件与板内证据 | 本轮新增证据仅为上述文字反馈；原build.log／download.log属于EncoderBench烧录，不能作MotorPwm下载证据；未新增Watch、波形、录像或精确计时 |

比赛对应：支撑[比赛文档](../../competition/比赛文档.md)第三部分“基本功能实现”60分项的运动基础，降低无法起转导致无法完赛的风险。本次验证指标为新板组合能产生主控确认的正常旋转，证据为上述原始回报；没有实测得分、直行、碰线、用时、闭环或整圈验收结论。

本次记录完成；后续若需采用为双轮前进或停车验收证据，再补当前轮侧／驱动通道、方向、AB并转与停止表现。仅更新本地记录和模块索引，未改固件、构建、烧录、提交或上传；全局状态由00读取本记录后顺序汇总。
