AgrumeStly/yeye/testing/2026-10-29_wheel_swap/record.md

# 2026-10-29左右轮换位：主控反馈与文档更新

日期：2026-10-29（北京时间）。01按主控直接授权保存；00仍为总协调。本次范围为全局及关联文档更新，不含固件、板卡动作或跨聊天发送。

## 主控明确反馈

主控表示已交换左右轮位置，并明确：以前右轮的前进旋转方向，现在对应左轮的后退旋转方向；以前左轮的前进旋转方向，现在对应右轮的后退旋转方向。机械轮位及旧前进转向与新前后关系已有直接来源，不把旧10月25日安装作为当前状态。

01已询问此次是否只交换机械位置、驱动板MOTOR-A／MOTOR-B六芯线插口未互换，或两插口也互换。该问题直接影响当前软件a/b轮侧，不是重复询问型号或既有端口；答复到达前通道映射保留待确认。

## 与旧标定的关系

旧[10月25日手转记录](../2026-10-25_encoder/acceptance_record.md)属于原安装：原左轮a前进正、1060.8 counts/圈；原右轮b前进负、1058.6。它们已由00核对，但当前机械换位后不能无条件继续使用该左右／符号组合。原始PNG、结构化JSON、软件日志和源码记录不改写。

当前完整映射及采用条件只维护于[wheel_mapping.md](../../hardware_preparation/wheel_mapping.md)。对轮组CPR的引用为历史参数转移参考，不伪造10月29日重新测量；电机电气前进极性仍与编码器符号区分。

## 本次授权、规则与验证

- 主控本轮明确要求更新全局文档，01仅在此授权下顺序修改全局摘要和关联入口，不接替00身份、不自动向其它对话发送消息。
- 开工目录D:/Projects/yeye，分支codex/current-version-20261025，HEAD 0b0343577895d8eb03a337165da6ce9c5e433519；保留已有未提交修改。写入前保存目标文件及源码／工程／旧编码器证据的哈希快照，并检查共享文件未被其它写入覆盖。
- 比赛依据：原文PDF第2—4页、图1及表1已核对；修订服务于60分基础完赛及避免触线扣分／出界失败，无实测加分承诺。原PDF SHA256仍为e7af6ca7eee908ae5460710f1f91d0658c401de208e9e3e570d48d76fe45931d。
- 只做文字、映射一致性、链接及文件范围检查；本次没有编译／模型运行、烧录、接电池、驱动、电气测量、提交、上传或分支切换，不声称新安装已经通过台架或整车验收。

## 主控补充：当前A/B是重新命名

主控先回复“机械位置换了，我忘了之前了，机械位置换完后，左轮为A右轮为B”，随后明确“左轮为A右轮为B是我现在规定的”。因此采用新物理命名A＝左、B＝右，**不将该答复理解为驱动MOTOR-A/MOTOR-B或软件a/b已经逐一配对确认**；也不继续要求回忆旧插口。

当前左新A来自原右轮，继承旧轮组CPR参考1058.6；当前右新B来自原左轮，继承1060.8。仅在编码器AB相序未改前提下，可由“旧前进现为后退”推导新A前进原始正／系数+1、新B前进原始负／系数−1；此处明确为推导，不是新手转截图读回，更不是电机PWM前进极性。

待确认只涉及当前安装的物理新A/B→驱动插口→软件a/b对应及实际前进读数，不影响先更新已经明确的机械变更和命名。旧10月25日原图与JSON不修改。本轮不执行这些硬件核对，也不将推导值写成固件参数。

## 本轮执行结果

已同步14份全局／任务／硬件／主控入口文档，包括project_status、C-02C历史补记、C-02D任务及完整Prompt、当前wheel_mapping、硬件wiring／README、控制入口与编码器／引脚说明、根docs的hardware／pinmap／interfaces／architecture，以及本记录。没有修改原10月25日实物表、原始PNG／JSON或软件日志。

检查通过：当前物理A左／B右命名明确；实际驱动／软件通道未猜测；历史原图与旧标定保留；新旧参数适用范围、推导及待核项已区分；现有源码／Keil配置和旧编码器证据共70份哈希未变，本地文档链接与git diff --check通过。检查详情见[checks.json](checks.json)。源码未变，不重复执行无关构建／模型，不把文档检查当作新安装试转或比赛实测得分。

保存于本地未提交工作区，分支及HEAD保留；未上传、未跨聊天发送。唯一后续接续点是按当前实物对应驱动插口／软件通道后再用于C-02D，不需要主控回忆旧插口，也不因本次重命名自动改代码。
