AgrumeStly/yeye/testing/2026-10-25_motor_direct/acceptance_record.md

# MotorDirect A／B马达现场起转记录

记录日期：2026-10-25（北京时间）。现场操作与结果回报：主控。归档：本对话按主控要求记录，后续现场证据由主控／02维护。关联任务：C-02／C-02B、MotorDirect。测试方法与固件入口见[MotorDirect A](../../control/docs/motor_direct.md)、[MotorDirectB](../../control/docs/motor_direct_b.md)；原PWM／持续版失败保留在各自历史记录中。

## 已收到的现场反馈

| 对象 | 本次主控回报 | 可以确认的层次 |
| --- | --- | --- |
| A马达 | “已经通电测试A马达完好”；此前同日补充长按KEY后松开，A转动约500ms后自动停止、绿灯闪烁 | 主控观察到A马达在当时的驱动与供电链路下起转、停转。500ms为现场估计，不是仪器计时 |
| B马达 | “马达b也正常” | 主控确认B马达本次实物测试正常；未提供更细的动作、时长和灯态描述 |

本次B测试是在主控要求“现在测试B马达”后进行。代理在本地准备独立Keil目标MotorDirectB，编译设定为版本`0x020B2002`、单次只驱动B桥；电脑构建0错误0警告，并通过A／B各9个GPIO／入口模型场景。上述软件证据不能单独证明板内实际版本。主控未在本次反馈中提供B版目标栏、Flash Download／Verify提示、Watch版本读回、具体电源／接线读数或录像，因此**不把实物结果严格归属到版本0x020B2002**，也不补造B的精确500ms、自动停转方式或故障位读数。

## 验证边界

2026-10-25本轮补充：主控再次明确“AB马达均通过直接通电旋转的测试”，并据此确认硬件、插线没有问题。后续PWM工作沿用该硬件与接线确认，不重新要求主控证明型号或重插线；新任务见[C-02B-PWM-R4](../../project_planning/tasks/C-02B-PWM-R4.md)。此补充未提供新的仪器数值、固件版本读回或录像。

本次现场反馈支持“两只马达分别已起转且主控判断正常”，其中A另有自动停转和绿灯现象描述。尚无B桥输出电压／波形、编码器计数、反转、速度闭环、双马达同时运行、地面行驶或整车跑圈验收记录。原PWM及持续A目标未转的历史现象不因本次Direct起转而改写；根因仍未定位。

待主控／02补充的原始证据：B测试实际Keil目标和Verify结果、实际哪只轮转及是否自动停、停止后绿灯状态、电池断开收尾状态、若有录像则保存位置。未收到的项目保持未记录，不影响本页保存已回报的现场结果。
