AgrumeStly/yeye/testing/2026-10-25_motor_pwm/acceptance_record.md

# 2026-10-25：重写PWM起转测试

记录：主控／01准备软件，主控操作实物，02维护后续现场证据。任务：[C-02B-PWM-R4](../../project_planning/tasks/C-02B-PWM-R4.md)。方法：[MotorPwm操作](../../control/docs/motor_pwm.md)。

主控本轮确认AB直接驱动均能旋转，沿用现有硬件与插线；此前细节见[Direct记录](../2026-10-25_motor_direct/acceptance_record.md)。这是本次前置结果，不补造波形、版本读回或接触电阻测量。

## 软件与设定

| 项目 | 记录 |
| --- | --- |
| 工程／目标 | control/MDK-ARM/motor_pwm.uvprojx／MotorPwm |
| 版本 | 本次工程预期0x020B0004，未单独提供板上Watch读回 |
| 提交 | codex/current-version-20261025，HEAD 0f033c6f67e5d4bef27b1c5afdd9d7014ac0456d，加本地未提交重写与既有Direct改动 |
| PWM | TIM1、HSI名义16MHz、PSC0、ARR15999、CCR8000，1kHz／50% |
| 控制脚 | A PE9 PWM／PE11 GPIO低，B PE13 PWM／PE14 GPIO低；停止四脚GPIO低 |
| 次序 | A一次500ms，正常后B一次500ms；均长按KEY松开触发，本轮不触发AB |
| 软件验证 | Keil0错误0警告，电脑模型与哈希见software/日志 |
| 外部仪器／波形 | 本轮未使用、未测 |

## 实物结果

2026-10-25，主控在收到本轮MotorPwm下载及A/B分步测试流程后回报：“全部符合预期”。按该完整流程记录下载、无动力演练、A/B分别起转与自动停转、对应灯态及断动力收尾符合预期，确认本项人工验收通过。证据来源为主控本对话文字回报，未另附下载日志、Watch、仪器计时或录像；下表中的约500ms为流程预期及主控整体确认，不是精确计时测量。

| 验收项 | 实际结果 |
| --- | --- |
| 下载Programming Done／Verify OK | 主控整体确认流程符合预期，未单独提供下载日志 |
| 无动力演练，1闪→长按常亮→松开约500ms→2闪 | 主控确认符合预期 |
| A：仅A转动、自动撤驱动、停止后2闪 | 主控确认符合预期 |
| B：仅B转动、自动撤驱动、停止后3闪 | 主控确认符合预期 |
| 异常／KEY提前停止 | 未报告异常；未单独报告主动按KEY提前停止测试 |
| 驱动OFF、XT30拔开 | 包含于主控对完整流程的确认 |
| 原始视频／Watch／波形 | 未提供；未单独读回revision或测量波形 |

本轮已取得主控对A/B分别PWM起转、自动停转及灯态的人工验收，任务范围完成。电脑模型和主控文字回报分别保留；不把文字回报补成板内版本读回或外部波形测量。旧PWM与持续A失败记录原位保留；本次同时更换实现和参数，不能根据成功结果单独归因旧失败。编码器、闭环、反转、双马达同时运行、整车测试均无本次验收结果。
