AgrumeStly/yeye/testing/2026-10-20_motor_bench/acceptance_record.md

# C-02B 首次双电机台架验收记录

状态：现场反馈待机异常，尚无通过结论。建立及首次反馈日期：2026-10-20（北京时间）；反馈角色：主控。00维护验收汇总，主控现场操作，硬件协助电气核对。

操作顺序及完整DFU命令以[MotorBench说明](../../control/docs/motor_bench.md)为准。依据：[接线v0.3](../../hardware_preparation/wiring.md)、[九线与电脑USB供电方案](../../hardware_preparation/dual_motor_wiring_guide.md)。

## 版本与现场

- 目标：MotorBench；源码基线main，HEAD为82640aba4cf7aa4f30db14b486aef852936118fe加本地未提交改动；测试前若变化，填写实际版本。
- 待下载BIN：control/firmware/build/motor_bench/motor_bench.bin，4672字节。
- 00于2026-10-20核对本机BIN SHA256：8593c996b152dc3a7f67515dbe66b3bfa323acaf81d42222c2bbe95d3749b8a4；与01回报相同。构建日志MotorBench为0错误0警告。本次核对未重新编译／运行电脑测试、未访问板卡。
- 输出约定：20kHz、15%占空比；每步500ms后00滑行。占空比不是转速百分比；0.5秒是电驱动窗口，不是机械停稳承诺。
- 供电：电脑USB供天空星，2S电池供AT8236；只共地及信号连接，不连接两板5V／3V3。
- 最新供电方案：主控要求改用DAPLink 5V0→天空星5V，主板Type-C拔开，DAPLink 3V3不接；DIO／CLK／GND／RST连接。上项为初始方案，本轮后续以实际改接确认后的供电记录为准，驱动仍电池独立供电；改接尚未回报完成。
- 实际BIN／读回哈希、备份目录：待填。
- MOTOR-A对应轮侧：待填；MOTOR-B对应轮侧：待填。
- 电池Vin实测：待填；编码器V/G实测：待填；测量工具：待填。
- 照片／录像文件：待填。

## 逐项记录

每行填写通过／失败／未测及真实现象。没有仪器的定量项目写未测，不用灯光或肉眼观察替代波形证据。任一单轮未起转、持续受驱动或异常发热，先断动力，不继续下一步。

| 项目 | 操作及预期 | 实际结果／证据 |
| --- | --- | --- |
| 断电接线与供电 | XT30／USB均拔开核对极性、九线、六芯线及公共地，无错位、短接；动力线不经主板 | 待测 |
| 下载与校验 | 电池拔开；按所用路径下载MotorBench并完成校验，备份及独立读回按实际执行记录 | 主控提供Keil日志：MotorBench编译0错误0警告、Programming Done、Verify OK、Application running，结束20:36:59；[原始回报](keil_download_report.txt)。Keil下载与校验通过；无本次独立DFU备份／读回哈希回报 |
| 待机提示 | BOOT0松开后RESET，先松开WKUP至少1s，用户灯每组闪1次，表示待A；供电依当前DAPLink五线方案，实际连接按现场记录 | 异常持续：已确认灯在天空星主板，红灯常亮、绿灯不闪；Keil Verify OK已补齐，运行时变量与PC仍待采集，原因未定位 |
| 动力上电不自转 | 轮子悬空，开关OFF插XT30，再开驱动，WKUP保持松开；两电机不自行转动，无异常复位／气味 | 待测 |
| 电压／待机输入 | 编码器V/G约3.3V，四控制输入待机接近0V；记录实测，普通万用表不作为PWM频率证据 | 待测 |
| A独立触发 | 用户灯闪1次组；WKUP长按约1–2s到常亮，按住不转，松开后仅A短时试转并撤去驱动；随后闪2次组 | 待测 |
| B独立触发 | A真实停稳且正常后，等待并重新长按松开；仅B试转，随后闪3次组 | 待测 |
| 双电机触发 | B也正常并停稳后，再长按松开；两只短时试转，随后用户灯慢闪，不循环 | 待测 |
| 完成锁定 | 三步结束后再长按松开，不应重新试转 | 待测 |
| 运行中停止锁定 | 前面通过后，先关驱动并拔电池、RESET主板重回待A；按正常顺序接动力。触发A，松开后立即再按WKUP；应提前撤驱动、灯快闪锁定，再按不继续B | 待测 |
| 静止复位不自转 | 前面正常后，轮子悬空、驱动上电且电机静止，RESET主板；两电机不应自行转动，新试转仍需重新长按松开；异常立即OFF断电 | 待测 |
| PWM／停止时序测量 | 有仪器时记录频率、占空比、有效窗口与输入回零；无仪器则仅记录可观察现象，定量波形保持未测 | 待测 |

## 回报00

下载及读回：待填；动力上电不自转：待填；A／B／AB：待填；自动撤驱动及滑行表现：待填；人工停止／锁定：待填；静止复位：待填；异常：待填。

现场达到预期只验收首轮开环转停，不表示反转、编码器计数、速度闭环、掉电故障、整车直行或跑圈已通过。15%未起转时保留失败现象并反馈01，不自行提高占空比或连续堵转重试。测试结束先关驱动并拔XT30，再拔主板USB。

## 待机异常排查入口

00于2026-10-20只读核对：MotorBench本机uvoptx为uSim=0、uTrg=1，CMSIS_AGDI配置含LCKFB DAPLink及SW-DP；构建日志仍为0错误0警告。上述信息不等于下载或现场运行成功，也不据此判定板卡损坏。

当前最小反馈：电池断开、主板USB供电，BOOT0/WKUP松开，RESET后观察10秒；提供MotorBench的Keil Flash Download底部完整结果（是否Verify OK）及红绿灯所在板。尚未形成可由00直接运行的板级复现条件，本轮不修改代码、不换测试程序、不把电脑测试充作LED故障复现。

后续更新：主控已补齐主板灯位置及Keil Verify OK，前段的日志请求已满足，不再重复要求下载或换软件。下一步保持电池断开，在Keil硬件Debug中使用View → Watch Windows → Watch 1和Periodic Window Update，按Run（F5）后观察g_motor_bench_ms、g_motor_bench_fault、g_motor_bench.state、g_motor_bench.raw_candidate及SystemCoreClock。本机tGomain=1，进入调试停在main属于预期，必须Run后再判断。程序含IWDG，优先运行中观察，不通过长时间暂停形成复位假象。运行数据及截图尚未回报，尚未定位根因或修改固件。

运行变量续报：主控报告g_motor_bench_ms一直为0x000000。其余四项数值、运行／暂停状态和当前PC所在行尚未回报；这个读数本身不能区分停在main、初始化未返回、计时中断未运行、重复复位或窗口未更新。下一步仅做一次“Run→短时运行→Stop”的现场位置采样，获取源码黄色箭头／Disassembly的PC及Watch截图。看门狗可能在暂停后复位，不能把长时间暂停引发的复位当作原故障根因；仍不改代码、不接动力。

截图续报：主控提供[原始停机截图](watchdog_wait_halt.png)，PC=0x08000332在IWDG_GetFlagStatus、LR=0x080011E7对应watchdog_init调用区，PVU检查为1；ms=0、fault=0、state=0、raw_candidate=0，时钟16000000。00核对应用在IWDG_Enable之前无限等待更新标志，SysTick_Config在其后，ST官方参考先Start后配置／等待。问题进入[C-02B-R1](../../control/docs/motor_bench_startup_issue.md)交01修复，不再停留于下载／接线排查；尚未改代码，修后板级复验待主控。

## C-02B-R1新版自主启动复验（待执行）

主控回报01已完成修复。00于2026-10-20读取新版：先Enable再配置／有限等待PVU/RVU；启动超时使用独立TIM5并带轮询保护，失败锁存故障且零驱动。01记录154条启动模型断言及原73／55项通过；00本次核对产物和日志，未重复运行测试，也未访问板卡。

当前待下载版本替代上方故障版，仅保留故障版数据作追溯：新BIN5144字节，SHA256=9c165244e60585d5c9a9fbaf882dc4964a56c7c046a808ecfa37a66539c036dd；AXF390824字节，SHA256=6cd1aa9ab11d47d52c0c5baa17fa2a4d88eb55b02cf78a5c1e1bb3a78e11faaf；Keil日志0错误0警告、Code4672／RO424／RW48／ZI1048。Watch版本应为0x020B0001。操作按[第11节](../../control/docs/motor_bench.md)，不用终端，电池一直拔开。

| 复验项 | 期望 | 实际 |
| --- | --- | --- |
| 新版Keil编译、下载校验 | MotorBench重新构建、新下载Verify OK | 待主控回报 |
| 独立断电重启 | 退出调试，DAPLink USB拔下等灯灭再插上，松开所有按键，约10秒内可见每2.5秒闪1次用户灯 | 待主控回报 |
| 新版运行标识 | revision=0x020B0001 | 待测 |
| 持续计时 | ms持续递增，不反复归零 | 待测 |
| 初始化状态 | fault=0，watchdog_stage=4，松键后state=READY/1 | 待测 |

以上通过前不连接动力电池、不长按WKUP试转；模型及编译通过不等同原实物问题已消失。

2026-10-20 R1现场续报：主控明确“绿灯正常闪烁了”，原版绿灯不闪现象在本次修复后已恢复。回报尚未逐项给出新版标识、独立断电启动、ms、fault及stage，以上对应单元不自动填通过；也没有任何A／B／AB转动结果。00给出后续现场顺序：先核对运行中ms增长与fault=0，退出调试并由DAPLink真正断电重启确认每组1次待机；完成接线／电压检查后，轮子悬空，开关OFF接动力，再检查不自转，按A、B、AB分别触发。每步失败即停，不能以灯光推进替代真实转动。
