AgrumeStly/yeye/testing/2026-10-21_motor_bench/i05_measurement_results.md

# I-05 电气测量结果表

版本：v1.2，已收到M01–M03读数及M04／M05正常反馈，动态待测。建立日期：2026-10-21；回报归档日期：2026-10-24（北京时间）。负责：硬件测量，主控配合记录，02整理，00验收；固件缺陷由00按证据转01。

操作依据：[I-05测量步骤及测点来源](../../hardware_preparation/i05_measurement_guide.md)。现象依据：[无动作记录](no_rotation_record.md)。本表不是测量完成证明；不得将预期值填入“实测”。

## 1. 现场事实与版本

- 已知：主控回报R2 Verify OK、绿灯正常，30%／500ms单次A完全未动且无声音；既定型号及接线正确的确认沿用，不再重复索取。
- 已知：UC2已与电池断开，电池冷却且无外观异常（主控确认）；UC2继续停用，不认定为本故障根因。
- 2026-10-24主控回报：M01电压正常7.4V、M02正常7.4V、M03为7.56V。按各点编号归档现场测量反馈；仪表型号／档位、实际测量日期、三次重复值及测量间隔未另报，不补填。驱动OFF／拔XT30的结束执行尚无新回报。
- 本地基准：main，HEAD `82640aba4cf7aa4f30db14b486aef852936118fe`加既有未提交修改；预期板内R2 `0x020B0002`，当前未新增Watch读数。
- R2本地BIN参考SHA256：`99b03ae743aa1021aeb5cb49192f2b24771e30d0872a577b17b3b29bbbd1d967`；不等同本次已从板卡读回核验。

| 现场元数据 | 填写（未取得保持待填） |
| --- | --- |
| 实际测量日期／北京时间 | 未另报；收到主控读数的日期为2026-10-24，不能据此替代实际测量日期 |
| 测量角色／记录角色 | 硬件：待填；主控：待填 |
| 万用表型号、量程、精度／校验方式 | 待填；不是重新识别车上器件 |
| 插孔及功能 | 黑COM／红V，DCV：待现场确认 |
| 接线版本／较wiring.md差异 | 当前沿用wiring v0.3及DAPLink单源5V；有实际变化才填差异 |
| 程序／AXF、下载日期、Watch版本（若读取） | 下载Verify OK已有主控回报；日期和新读数待填，不重烧录 |
| 主板Type-C空、驱动5V／3V3未并主板、系统共地 | 采用既定接法；本轮测量配置记录待填 |
| 初始OFF／XT30拔开／UC2未连的实际确认 | 待现场填写，不能预勾 |

## 2. 第一批静态测量：M01–M03，不按KEY

每行写三次真实数值，保持正负号和V单位；读数不稳时写范围。不新增电机脉冲。M01不符合初筛即停止，M02／M03写“未执行：M01未放行”。

| ID | 测量对象：红／黑 | 现场电源状态 | 资料／筛查参考，非实测 | 读数1／2／3（V） | 仪表档／量程 | 现象及证据文件 |
| --- | --- | --- | --- | --- | --- | --- |
| M01 | 独立电池XT30＋／− | 编号规定：电池不连驱动或UC2；DAPLink断开 | 2S静置初筛约6.6–8.4V；整包正常不能证明单节均衡或带载能力 | 7.4／未报／未报 | 未报 | 2026-10-24主控回报“正常7.4V”；无新增图或仪表日志 |
| M02 | 顶部Vin＋／Vin− | 编号规定：DAPLink主板待机；电池接驱动，开关OFF；不按KEY | 记录实际值；OFF时Vin不保证为0，不能单据此判断开关 | 7.4／未报／未报 | 未报 | 2026-10-24主控回报“正常7.4V”；无新增图或仪表日志 |
| M03 | 同一Vin＋／Vin− | 编号规定：同探头位置，开关ON；主板待机，不按KEY | 应接近M01并稳定；厂家模块输入5–12V不代替2S电池筛查 | 7.56／未报／未报 | 未报 | 2026-10-24主控回报“7.56V”；无新增图或仪表日志 |

M03−M01=+0.16V；M03−M02=+0.16V。各点未同时测量，量程／精度／稳定性未回报，不能把差额直接解释为开关升压、故障或正常线损。暂可确认主控已测得电池及驱动外部Vin均有静态电压，没有“Vin完全无电”的读数证据；尚不能认定带载能力、芯片内部VM或控制／输出正常。若需核查差额，只在同表同档、同次ON静置条件下核对电池与Vin，不触发电机，不要求重做整套接线资料。

## 3. 按第一批结果再安排的静态补测

以下未自动放行，是否需要由00依据M01–M03决定。每次全断电换探头，不接电流档、不按KEY。

| ID | 红／黑测点 | 条件 | 参考 | OFF／ON实测（V） | 档位与证据 |
| --- | --- | --- | --- | --- | --- |
| M04 | 驱动左侧5V／GND | Vin无明显异常，安全探头可及 | 5.0V标称；模块精度未冻结 | 主控反馈正常；未分别报告OFF／ON数值 | 2026-10-24主控回复“都正常的”；具体数值／档位未报，不填成实测5.00V |
| M05 | 驱动左侧3V3／GND | 同上 | 3.3V标称；不代替芯片VM | 主控反馈正常；未分别报告OFF／ON数值 | 同轮“都正常的”对应本项；具体数值／档位未报，不填成实测3.30V |
| M06 | 主板H1.7／H1.4或6 | 仅在有主板供电异常证据时，动力电池拔开 | DAPLink供电约5V | 不适用／待测 | 待填 |
| M07 | 主板H1.2／H1.4或6 | 同上，安全探头可及 | 3.3V标称 | 不适用／待测 | 待填 |

## 4. 可选无动力Watch（不下载、不强改值）

| 项目 | 预期值 | 实际时刻1／值 | 实际时刻2／值 | 记录证据 |
| --- | --- | --- | --- | --- |
| g_motor_bench_revision | 0x020B0002 | 待测 | 待测 | 待填 |
| g_motor_bench_ms | Run期间增长、不反复归0 | 待测 | 待测 | 待填 |
| g_motor_bench_fault | 0 | 待测 | 待测 | 待填 |
| g_motor_bench_watchdog_stage | 4 | 待测 | 待测 | 待填 |
| g_motor_bench.state／output_mask | 松键后READY(1)／0 | 待测 | 待测 | 待填 |

读取时XT30已拔开：待确认；Run／Periodic Window Update：待确认；结束退出调试及独立待机：待记录。未读取写“未做，无必要／待安排”，不因已有绿灯反馈而补填软件值。

## 5. 条件式动态捕获结果（本轮不执行）

00后续任务／授权来源：未取得；因此本节全部待测。未来仍保持一次人工A、30%／20kHz／500ms与停止保护，未成功捕获也不能自动再触发，不继续B／AB。

| ID | 同步边界 | 预期／捕获要求 | 实测与时间窗 | 原始波形／设置文件 |
| --- | --- | --- | --- | --- |
| W01 | Vin对系统GND | 包含脉冲前、中、后，记录最低值与时刻 | 待测 | 待填 |
| W02 | PE9／P1.15对GND | 约0/3.3V、20kHz、30%，包络约500ms | 待测 | 待填 |
| W03 | 驱动AIN1对GND | 与W02同步到达；记录高低电平、频率、占空比 | 待测 | 待填 |
| W04 | PE11／AIN2对GND | A阶段持续低；记录实际覆盖的端点 | 待测 | 待填 |
| W05 | AO1−AO2 | 由硬件用匹配差分探头捕获；不能把地夹接AO2 | 待测 | 待填 |
| W06 | 撤输出与真实机械现象 | 控制撤低、是否转动／抖动／停稳分别记录 | 待测 | 待填 |

仪表／探头型号及额定输入：待填；倍率／采样率／存储深度：待填；触发源／阈值／前触发：待填；接地路径及探头固定：硬件待确认；是否成功捕获真实A窗口：待填；未覆盖通道：待填。普通万用表的0V或平均数不能代填W02–W05。

## 6. 返回00：事实与判断分开

| 返回项 | 内容 |
| --- | --- |
| 新取得事实 | 2026-10-24主控回报M01=7.4V、M02=7.4V、M03=7.56V；随后按M04/M05问题回复“都正常的”，具体稳压轨数值未报 |
| 已排除的边界 | 静态反馈不支持电池／驱动外部Vin或5V/3V3完全无电；不等于整段供电验收通过，不能排除运行掉压或内部VM异常 |
| 仍未知 | 单节平衡与带载能力、+0.16V差额来源、内部VM、管脚到驱动输入及H桥真实波形 |
| 能定位到的最小边界 | 外部输入和稳压轨静态反馈无明显异常，下一段为实际控制输入／输出及同时间窗供电，不能先判驱动或电机坏 |
| 下一动作／负责角色／复测条件 | 返回00；先确认硬件能否借示波器／逻辑分析仪及输出测量所需差分探头，按现有方案准备有效捕获；当前不增加A脉冲、不继续B/AB、不加功率 |
| 若需01处理 | 提供版本、无动力Watch或源端真实波形、有效捕获窗口；当前无指向固件的新证据 |
| 结束安全状态（必须实际填写） | 驱动OFF：待确认；XT30拔开：待确认；DAPLink USB断开：待确认；UC2未使用：待确认 |

本次仅建立模板，没有操作仪表／板卡、烧录、改固件、触发电机或上传。复测结论保留原日期／证据，新增实测另填日期，不覆盖主控原始无动作反馈。

## 00补充：R3截图之后的现场版本边界

2026-10-21已收到[R3板内快照](r3_watch/README.md)，A启用／停止寄存器和500ms差符合预期。本表原R2版本／哈希为编制时的历史参考，后续测量保留当前R3、记录实际版本，不要求回刷R2；截图未含revision独立读数。当时M01–M03及所有电压仍待测；2026-10-24新电压反馈已单独写入第2节，不以快照补填电气结果。

## 2026-10-24归档范围

本次仅归档主控直接回报及其算术差额、更新I-05状态；未自行复测、改接线、改固件、编译烧录、触发电机或上传。静态读数接收不等于00已完成整项验收。下一阶段继续保留当前R3，不回刷历史R2，不把补测5V／3V3建议当作新的A／B／AB试转授权。

同日补充：主控对M04／M05回复“都正常的”，02仅记录两轨正常的现场反馈，不推定主板M06／M07、动态供电、PWM或H桥输出已测。当前仍保留R3；硬件仪表条件确认后，再由00安排具体控制信号捕获任务。

## 2026-10-24：KEY操作后的编码器与接口电压反馈

主控报告长按KEY（板载WKUP对应按键）后，绿灯每组连续两闪、间隔后重复；驱动至主板信号排针和电机至驱动接口的E2A、E1B均持续3.3V，电机接口3V3均为3.3V，其余所测端口均为0。未另报每个端点的测量时刻、实际窗口／档位、参考地或本次动力状态，不追加推定。

- “其余所测端口均0”没有逐项列出端点，不能据此覆盖此前M01–M05的独立电源反馈。
- 依据当前motor_bench.c：READY时组闪数为step+1，每组两闪对应等待下一次B；A软件输出阶段已结束，不代表电机真实转过。如果是在两闪阶段读取AIN／BIN或绕组端，读到0不能判定此前500ms没有驱动输出。
- E1A／E1B、E2A／E2B为编码器AB信号，不是AIN1／AIN2等桥控制输入；静止时某些相为高、某些为低与增量编码器的静态状态相符，但不能据此认定编码器及电机功能通过。此处只记录两个端点的3.3V反馈，不填写脉冲、频率或转动通过。
- 不再按KEY推进B／AB或重复A。保持当前R3；结束时驱动OFF、拔XT30的实际执行仍待现场确认。
- 主控限定只用万用表。下一步建议返回00，由00给01生成“无动力静态高低电平控制脚诊断”任务：动力电池始终拔开，人工选择／逐路显示可稳定读出的0/3.3V，比较MCU端与驱动AIN／BIN端；不使能任何有动力电机，不延长现有MotorBench试转，不覆盖R3原始基准。本轮未修改固件或授权实际运行该新诊断。

当前仍无500ms内PE9／AIN1或AO1−AO2的有效动态读数；万用表在阶段结束后的0V不能代填W02–W05。02仅归档上述反馈与交接建议，未自动操作板卡、提交或上传。
