AgrumeStly/yeye/testing/2026-10-21_motor_bench/no_rotation_record.md

# C-02B：首次A触发后无转动

状态：现场故障待定位，非电机验收通过。日期：2026-10-21（北京时间）。00汇总，主控现场反馈，02核对装配，硬件负责电气测量，01负责实际PWM及程序问题。

## 本次事实

主控原话含义：所有线已接好，绿灯正常闪烁；长按KEY后松开，绿灯变为每组连续闪两次、间隔后重复，但电机不转。主控另明确现场没有万用表。

依据当前[motor_bench.c](../../control/App/Diagnostics/motor_bench.c)及[操作说明](../../control/docs/motor_bench.md)，两次组闪对应READY等待B。该灯态说明A的500ms软件输出阶段已结束并推进到B，不表示A实际转动或PWM已到达驱动。当前[配置](../../control/Drivers_Custom/Motor/motor_bench_pwm.h)为20kHz、15%，不保证实际起转。没有本次Vin电压、输入PWM波形、驱动输出及电机电流记录。

本次只确认KEY触发及软件阶段推进；原绿灯不闪的启动问题不再作为当前主线。当前不确认控制线、驱动板或电机正常，也不认定低占空比就是根因。

## 最小排查顺序

1. 先关驱动、拔XT30；不继续B／AB、不反复触发或自行提高占空比。DAPLink只供主板，不能替代驱动电池。
2. 回报上一次测试时XT30是否插合、驱动开关是否ON、Keil是否已退出调试；均按真实状态，不从“所有线接好”推定。
3. 没有万用表，先取得两张当前接线照片：驱动正面（含Vin端子、开关、控制针、电机A接口与线端）及天空星控制线针位（能读E09／E11／E13／E14和GND）。需要时再补电机六芯两端；不重新索要型号铭牌。
4. 先核对AIN1→E09、AIN2→E11、BIN1→E13、BIN2→E14、公共地、MOTOR-A的M1／M2及编码器V/G没有接反。照片能核对端点，不能证明通断或电压。
5. 供电／线束仍无结论时，由硬件借用仪表补测Vin、3V3及输入／输出，或提供测量交付；不要求主控盲目提高输出验证。15%／500ms不足起转只是候选；进一步诊断固件由00按证据生成01任务，不直接改程序。

目前等待：上次动力与调试状态、当前两张接线照片。尚未改变接线、代码、输出参数、烧录版本或访问板卡，未上传。

## 主控确认后的下一步

2026-10-21主控明确“接线都没问题”。00采用该现场确认，不再重复索要接线照片；原照片请求停止作为阻塞。实测Vin及PWM仍未取得，不据口头核对伪造测量通过。按[C-02B-R2任务](../../control/docs/motor_bench_r2_task.md)，由01准备固定30%／500ms受限起转诊断，保留R1与全部人工触发／停止约束；只改变占空比这一试转变量。主控自行确认实际动力电池、ON开关、退出调试后先单轮A一次，失败不继续加功率。生成任务不等于已修改、下载或试转，现场结果保持待验收。

## R2下载及绿灯反馈

2026-10-21主控回报：“Verify OK、绿灯正常”。本轮下载校验与用户灯观察据主控反馈记为通过；板内Watch版本0x020B0002、毫秒计数／fault及独立断电过程尚无逐项回报，不推定为已采集证据。30%／500ms实际A起转仍未试验，B／AB亦待测。UC2先停用核查，下一次动力试转前需明确电池已与充电器断开、已冷却且外观无鼓包／异味；本记录不据充电器本体发热确认电池损坏或电机未转根因。

## 电池状态确认与首轮A安排

2026-10-21主控对电池已断开UC2、完全冷却且无鼓包／异味／接头变形答复“确认”。UC2继续停用，按MotorBench第12.3节安排A桥30%／500ms单次人工试转，结束后关驱动并拔XT30再回报；B／AB暂不继续，失败不重复触发或再加功率。只是操作安排，实际转动、声音／抖动、方向和停稳均待主控回报；电压及PWM波形仍未测。

## R2首次A试转失败

2026-10-21主控按上一轮R2一次A指导回报：“完全没动，也没声音。”记录该次无转动／无声音，未额外报告本轮灯态、Watch或波形，不据此断言电池、PWM、驱动或电机故障；30%也无动作不能排除全部机械起转阈值问题。停止B／AB和继续加功率，指导驱动OFF拔XT30，实际断开执行尚未回报。00转入[I-05电气定位](../../hardware_preparation/i05_motor_power_diagnosis_task.md)，02准备测量步骤、硬件借仪表，先静态供电、后按证据计划信号测量。UC2保持停用，不把发热与本故障直接关联。00未改固件、访问板卡或上传。

## 驱动电源灯与无动力证据采集安排

2026-10-21主控确认，上次试转时AT8236驱动板自身电源灯“亮了”。仅记指示灯观察，不代填电压或带载供电通过。主控要求恢复电机调试，00准备[C-02B-R3](../../control/docs/motor_bench_r3_task.md)交01增加真实活动／停止寄存器保留快照，保持功率／时长与保护不变；先在动力电池拔开时用Keil人工触发一次A并读取快照。尚未修改、下载或采集，真实电机仍未起转，I-05测量待进行。

## R3诊断软件已核对，实板采集待进行

2026-10-21主控报告01完成，00核对R3版本0x020B0003、实际寄存器活动／停止保留采集及三份产物哈希，与交付表一致；已有构建和131／154／73／55检查日志通过。下一步只做驱动OFF、动力电池拔开时的Keil图形下载／运行，KEY一次A后等待约3s，读g_motor_bench_pwm_diag及活动／停止帧，保存截图前不复位或断电。尚未取得新Watch或真实PWM／起转结果，现场故障仍未定位，I-05保留。

## R3主控截图：板内启用／停止读回符合

2026-10-21主控交回三张Watch原图，已归档至[r3_watch](r3_watch/README.md)。请求／启用／停止各1次；A活动MOE1、CCR240、AF1，500ms正常超时后MOE0、四CCR清零、GPIO低，fault采集值均0。PE9 IDR只在活动／停止各有一次高／低样本，不能据此写成真实波形验收。截图未显版本字段，不额外补造。下一步保留R3，按02已有I-05先测电池及外部Vin静态输入，不继续软件加功率或B／AB复测。实际电压／输入波形／H桥输出仍待硬件仪表，电机起转未通过。
