AgrumeStly/yeye/testing/2026-10-25_encoder/software/encoder_bench_tests.txt

PASS EncoderBench: 241898 assertions in 12 real-main/SPL scenarios (R1, 10ms, dual reads, zero motor; no board)
