AgrumeStly/yeye/testing/2026-10-25_encoder/software/encoder_counter_tests.txt

PASS encoder counter: 8022 assertions (first, stationary, signs, wrap, dt, ambiguity, saturation, 2000 dual trajectories)
