AgrumeStly/yeye/testing/2026-10-25_motor_pwm/software/motor_bench_pwm_diag_tests.txt

PASS rewritten PWM: 168 checks in 9 real-main/PWM model scenarios (A/B/AB, timeout, stop, fault, wrap; no board access)
