AgrumeStly/yeye/testing/2026-10-25_motor_pwm/software/motor_bench_startup_tests.txt

PASS MotorBench startup: 154 checks in 10 hardware-model scenarios (real main/SysTick; no board access)
