AgrumeStly/yeye/testing/2026-10-25_motor_pwm/software/motor_bench_tests.txt

PASS motor bench: 73 checks (manual sequence, debounce, stop, timeout, wrap, lockout)
