AgrumeStly/yeye/testing/2026-10-25_motor_pwm/software/motor_continuous_tests.txt

PASS continuous A: 115 checks in 7 real-main/PWM model scenarios (120s, wrap, stop, fault, lockout; no board)
