AgrumeStly/yeye/testing/2026-10-25_motor_pwm/software/motor_direct_b_tests.txt

PASS MotorDirect GPIO: 52593 checks in 9 real-main/GPIO scenarios (single 500ms, lockout, fault, wrap, no TIM1/AF; no board)
