AgrumeStly/yeye/testing/2026-10-25_motor_pwm/software/motor_direct_startup_tests.txt

PASS MotorDirect R1 startup: 154 checks in 10 hardware-model scenarios (real main/SysTick; no board access)
