AgrumeStly/yeye/testing/2026-10-25_encoder/hand_turn/README.md

# 输出轮手转：每侧3次单圈与连续5圈原图

日期：2026-10-25（北京时间）。01归档／判读；现场动作与零起点确认由主控提供。
来源：主控本轮上传两张原图，说明“分别是左轮A和右轮B转完完整一圈的截图”；随后确认“起始状态都是刚开始debug从零开始的初始状态”。原图按字节复制，未标注／裁剪／重绘；字节和SHA256见[readings.json](readings.json)。

| 证据 | 原始读数 | 按零起点计算的本次一圈 |
| --- | --- | --- |
| [左轮a原图](01_left_a_one_turn.png) | raw_cnt=0x0418，total_count=0x418；delta0，counts_per_s0，dt0xA，valid1，status0，flags0 | start0，end+1048，差+1048，绝对1048 counts/输出轮圈 |
| [右轮b原图](02_right_b_one_turn.png) | raw_cnt=0xFBEA，total_count=0xFFFFFFFFFFFFFBEA；delta0，counts_per_s0，dt0xA，valid1，status0，flags0 | start0，end−1046，差−1046，绝对1046 counts/输出轮圈 |

0xFBEA是16位CNT的64490；相对0的短程反向模差为64490−65536=−1046。64位total_count的补码也为−1046，不是巨大正转。dt0xA=10ms；截图时delta／counts_per_s为0只说明最后采样窗无增量，与已经完成一圈后停下相符，不能解释为没有计数。

已得到的实物证据：两路均有与主控手转对应的非零累计；主控已报告左轮对应a、右轮对应b；两帧当时valid1／status0／flags0。左右首圈绝对值相差2 counts，约为两者均值的0.19%，仅作数值比较，不能据此宣称重复性、最终CPR或允许误差通过。

首轮归档时待补：每侧第2／3次完整输出轮圈（现已收到，见下节）；反向核对、前进轮转方向与原始符号的关系、另一通道同步静止／独立性仍待明确。主控回复明确了零起点，未单独描述车辆前进转向，因此先记录本次a正／b负，不在固件写方向系数。不能把左右两轮的两次读数平均成已冻结的通用CPR，也不回填厂家理论值。

截图不含revision、ms、全局fault／watchdog_stage／motor_odr；故这些字段仍保留未读，不把通道status0填成全局fault0。供电实际电压、M1/M2隔离、是否全程持续Run及收尾断电也不能由此图独立证明。左／右对应来自主控现场描述，截图本身只显示a／b软件名称。

记录回填[原验收表](../acceptance_record.md)，后续继续在同表保存各次start／end；本次不改固件、构建、烧录、操作板卡、跨聊天或上传。最终CPR／前进方向仍待验，参照[操作教程](../../../control/docs/encoder_bench.md)。

## 第2／3轮补充与当前统计

主控随后提供第二轮、第三轮两张同时展开a/b的原图，并明确“起始均为刚进入调试的初始状态”；结合此前零起点确认，每轮各自start=0，不把不同debug会话的累计相减。每轮按上一轮完整输出轮一圈的回报上下文记录，实际对齐标记／车头转向未单独说明。

| 轮次／原图 | a：左轮 | b：右轮 | 共同末窗状态 |
| --- | --- | --- | --- |
| 第2轮：[原图](03_round2_a_b_one_turn.png) | raw0x0432／total0x432=+1074 | raw0xFBD0=64464／total0xFFFFFFFFFFFFFBD0=−1072 | delta0、counts_per_s0、dt10ms、valid1、status0、flags0 |
| 第3轮：[原图](04_round3_a_b_one_turn.png) | raw0x042B／total0x42b=+1067 | raw0xFBBC=64444／total0xFFFFFFFFFFFFFBBC=−1092 | 同上 |

| 通道／轮侧 | 3次一圈绝对计数 | 均值 | 最小／最大 | 极差 | 极差/均值 |
| --- | --- | --- | --- | --- | --- |
| a／左 | 1048、1074、1067 | 1063 | 1048／1074 | 26 | 约2.45% |
| b／右 | 1046、1072、1092 | 1070 | 1046／1092 | 46 | 约4.30% |

两侧各3次读数收齐，原图共4张、通道帧共6个。均值是当前样本统计，未作为最终CPR写入代码；极差/均值也不是已冻结的合格阈值。flags0仅说明算法未检测到丢窗／半量程等状态，不能证明每次物理一圈角度完全相同或AB信号无噪声。尚无法区分标记对齐、手转圈角、回摆、机械或电气影响，不认定编码器或代码故障。

建议下一次仍只手转：两侧保持M1/M2绕组隔离、F5持续Run，固定轮和车架对齐标记，各自沿明确的车辆前进转向连续5个输出轮整圈，记录start、end和flags，计算abs(end−start)/5。这里5圈是复核方法，不是动力运行／加功率，也不预填应达到的总计数。明确是否与前3次同转向，之后补反向／独立性。未取得复核与方向确认前不冻结CPR或方向系数。

各图原始字节、SHA256、16位／64位有符号换算及统计保存在[readings.json](readings.json)；复核说明与实物表同步，没有修改源码、工程或构建产物。

## 最新连续5圈复核

主控新增[原图05_five_turns_a_b.png](05_five_turns_a_b.png)，明确“初始均为刚开始调试的初始状态，两轮均转五圈”。起点按前文已确认的0，分别计算每输出轮一圈，不跨debug会话相减。

- 左a：raw／total=0x14B8=+5304，5圈折算5304/5=1060.8 counts/输出轮圈。
- 右b：raw／total=0x14AE=+5294，5圈折算5294/5=1058.8 counts/输出轮圈。
- 两帧delta0、counts_per_s0、dt10ms、valid1、status0、flags0。
- 原图85685字节、SHA256 c7f27a0852eb0ec49d3f13ed62688fe2ecff356cb5ea596c67132ae0be8ff1ef；结构化记录在readings.json的five_turn_check，前3次单圈统计原样保留，不混入一个单圈平均。

上一节提出的5圈复核已经收到，不重复要求主控继续追加同向圈数。本次两侧折算相差2 counts/圈，当前标定候选为左1060.8、右1058.8；未写入固件，也未拿两侧均值替代各自参数。每侧仅一组5圈数据，不能称已经测出多圈重复性误差或查明前3次极差原因。

特别待澄清：右b前三次一圈均为负，本次5圈为正；左a一直为正。01已询问本次是否均为车辆前进转向、右轮是否改变手转方向。未收到明确答复前，只记录符号变化，不判代码／接线故障，不冻结方向系数。前进符号、已有反向／独立性及未随图全局运行／供电字段仍按原表待核。

仅归档与算术检查，代理没有修改固件、工程、构建、烧录、操作板卡或上传。

## 最新右b前进重做与主控明确确认

主控新增[右b前进原图](06_b_forward_five_turns.png)，说明“b重新转的，起始是初始状态，方向按车行驶方向”。按上一轮相同5圈复测上下文记录；本次句子未重复数字5，此上下文推定在readings.json中明确保留。

raw0xEB53=60243，64位total0xFFFFFFFFFFFFEB53=−5293；从0起折算abs(−5293)/5=1058.6 counts/输出轮圈。delta0、counts_per_s0、dt10ms、valid1、status0、flags0。原图42557字节、SHA256 a67014386b7424324edc07216772217051354f89e7cd8d82416e36bfc4bb6774，未修改原始字节。此前正计数5圈为1058.8，与本次相差0.2 counts/圈；两组方向符号及来源分别保留，不删旧图。

随后主控明确回复：A此前累计+5304的5圈也是车辆前进方向；另对“单独转左轮只有a变化、单独转右轮只有b变化、左轮反向转时a累计减小”三项答复“三点都已观察到”。因此可以确认左a／右b映射、两路手转独立性和左反向变化；这些来自主控文字见证，不能冒充同步截图。

初版标定记录：左a前进正、系数+1、1060.8 counts/输出轮圈；右b前进负、系数−1、1058.6 counts/输出轮圈。这里系数仅用于后续把车辆前进统一为正的应用换算，不修改底层计数极性，也尚未写入固件。每侧3次单圈与5圈复核已留证，不再要求主控继续重复转圈。

当前有本轮手转与初版标定交接依据，提交00核对采用；未证明计量级CPR精度、真实最大边沿速率、电压／滤波或闭环。截图未含全局运行／供电／隔离字段，原表相关项继续如实保留未随图提供，不据此否定已取得的主控观察，也不代填通过。代理仅归档和计算，未操作板卡、改固件或上传。
