AgrumeStly/yeye/docs/test-log.md

# 软件与实物验证入口

日期：2026-10-25（北京时间）。软件证据由01维护，现场证据由02及对应成员留存。

| 证据类型 | 入口 | 能证明什么 |
| --- | --- | --- |
| 编译、电脑模型、迁移前后固件对比 | [control/docs/validation.md](../control/docs/validation.md) | 对应版本的软件构建／逻辑结果 |
| 首次主板自检与下载读回 | [板级记录](../hardware_preparation/board_self_test_record.md) | 记录内列明的下载和基础功能 |
| 串口、电压、Watch、台架和后续跑圈 | [testing/README.md](../testing/README.md) | 具体版本与条件下实际发生的结果 |
| 本轮分层迁移检查 | [ORG-02](../project_planning/tasks/ORG-02.md) | 源码、配置路径、测试和二进制等价性 |

本页不把全部实物过程压成一份长日志。测试按日期和主题保存原图／原始读数，失败与复测都保留；模板待填、软件请求、板内变量、外部电气和机械动作分开判断。当前仍无整车跑圈／故障停车验收结果。
