AgrumeStly/yeye/testing/2026-10-25_encoder/acceptance_record.md

# C-02C：双编码器手转／轮侧／方向／每圈计数验收表

日期：2026-10-25（北京时间）。负责：主控／硬件现场记录，02接收，00汇总；01准备模板。
**轮侧和前进符号已有主控明确确认：左a前进正、右b前进负。** 左a前进5圈+5304；右b按同一5圈流程沿前进方向重做为−5293，当前候选1060.8／1058.6 counts/输出轮圈，方向系数+1／−1仅登记、未写代码。原单圈3次及此前b正计数5圈数据仍保留，不用新图覆盖历史。主控随后明确确认左反向减计数及两路单独手转独立性，手转标定具备交接条件；00核对采用，未随图全局版本／供电／隔离条件不代填。同向圈数本轮不再追加。[原图与边界](hand_turn/README.md)、[软件证据](software/README.md)、[操作教程](../../control/docs/encoder_bench.md)。

## 现场版本、供电和隔离

| 项目 | 实际记录 |
| --- | --- |
| 操作日期、主控／硬件角色 | 2026-10-25主控上传并确认；硬件参与情况未回报 |
| 目录、分支、HEAD、本地差异 | 待填；软件基线见任务，不自动当现场已核对 |
| 工程／目标 | 待核对：control/MDK-ARM/encoder_bench.uvprojx／EncoderBench |
| Rebuild结果／Programming／Verify原始证据 | 待填 |
| Watch revision | 待读；预期0x020C0001，不能预期代填实测 |
| ms是否递增、fault、watchdog_stage、motor_odr | 待读 |
| 两电机M1/M2均断开且四线端独立绝缘 | 待确认；全断电时操作 |
| DAPLink单源主板供电／两板共地／稳压输出不并联 | 待核对 |
| 编码器V/G供电路径、驱动开关、实际电压或未测说明 | 待填；驱动电源灯不是3V3测量 |
| 当前每路status／flags，是否暂停／复位 | 3轮单圈、双轮5圈及右b前进重做共9个通道帧均valid1／status0／flags0、dt10ms；各次从0起，独立计算；转动中是否暂停／复位未单独回报 |
| 车头标记及轮外侧观察视角、原始照片／视频路径 | 待填 |

## 静止、正反向、轮侧和独立性

让轮停稳至少两次刷新再抄值；a=TIM3、b=TIM4，只是资源名。全部是手转，不触发MotorPwm补测。

| 手转对象／动作 | a起→止累计 | b起→止累计 | 对应通道／另一轮有无机械联动 | 数字符号／status／flags | 结论及证据 |
| --- | --- | --- | --- | --- | --- |
| 双轮静止观察 | 待填 | 待填 | 待填 | 待填 | 待验 |
| 物理左轮模拟前进方向 | 0→+5304，主控确认5圈方向 | 单独左转时只有a变化，主控文字确认 | 左对应a及单独左转只有a变化，主控明确确认 | 正／status0／flags0 | 前进符号已确认；[五圈图](hand_turn/05_five_turns_a_b.png) |
| 物理左轮反向 | 累计减小，主控明确确认；未报数值 | 单独左转仅a变化，主控明确确认 | 无额外联动反馈 | 左反向为负；未附新帧 | 文字观察已确认，不冒充原图 |
| 物理右轮模拟前进方向 | 单独右转时只有b变化，主控文字确认 | 0→−5293，同5圈流程重做 | 右对应b及单独右转只有b变化，主控明确确认 | 负／status0／flags0 | 前进符号已确认；[重做图](hand_turn/06_b_forward_five_turns.png) |
| 物理右轮反向 | 待填 | 待填 | 待填 | 待填 | 待验 |

| 通道 | 实际轮侧 | 模拟车辆前进时从轮外侧看CW／CCW | 前进原始计数符号 | 未来符号系数候选（未应用） | 主控／硬件确认 |
| --- | --- | --- | --- | --- | --- |
| a：E1A/B、PC6/7 | 左轮，主控报告 | CW／CCW视角描述未填，不影响已确认的车辆前进符号 | 正 | +1，仅登记 | 主控明确确认+5304那次5圈也是车辆前进方向 |
| b：E2A/B、PB6/7 | 右轮，主控报告 | 同上 | 负 | −1，仅登记 | 主控新图明确按车辆行驶方向重做，累计−5293；不追认此前+5294样本为前进 |

## 每输出轮完整一圈，前进方向每侧3次

起终点都记录原始有符号64位累计；差值=end−start。单位为counts/输出轮圈，固件当前四倍频。标记对齐方法／实际圈数／反向回摆应如实记录，不预填厂家理论值。

| 通道／轮侧 | 次数 | 圈数／方向／标记方法 | start | end | 有符号差 | 绝对counts/轮圈 | flags／是否暂停复位／证据 |
| --- | --- | --- | --- | --- | --- | --- | --- |
| a／左轮 | 1 | 主控报告完整一圈；前进转向／对齐方法未描述 | 0，主控确认 | +1048 | +1048 | 1048 | flags0；圈中暂停／复位未单独确认；[原图](hand_turn/01_left_a_one_turn.png) |
| a／左轮 | 2 | 主控按完整一圈回报；转向／对齐方法未描述 | 0，主控确认 | +1074 | +1074 | 1074 | flags0；[第二轮原图](hand_turn/03_round2_a_b_one_turn.png) |
| a／左轮 | 3 | 同上 | 0，主控确认 | +1067 | +1067 | 1067 | flags0；[第三轮原图](hand_turn/04_round3_a_b_one_turn.png) |
| b／右轮 | 1 | 主控报告完整一圈；前进转向／对齐方法未描述 | 0，主控确认 | −1046 | −1046 | 1046 | flags0；圈中暂停／复位未单独确认；[原图](hand_turn/02_right_b_one_turn.png) |
| b／右轮 | 2 | 主控按完整一圈回报；转向／对齐方法未描述 | 0，主控确认 | −1072 | −1072 | 1072 | flags0；[第二轮原图](hand_turn/03_round2_a_b_one_turn.png) |
| b／右轮 | 3 | 同上 | 0，主控确认 | −1092 | −1092 | 1092 | flags0；[第三轮原图](hand_turn/04_round3_a_b_one_turn.png) |

| 通道 | 3次均值／最小／最大／极差 | 反向一圈start→end与符号／绝对量 | 不一致原因或未解释差异 | CPR结论及主控／硬件确认 |
| --- | --- | --- | --- | --- |
| a | 均值1063／最小1048／最大1074／极差26 counts（极差/均值约2.45%） | 待填 | 对齐、实际圈角、回摆、噪声等尚未区分，不认定故障根因 | 已获5圈复核，当前候选1060.8 counts/轮圈，未写代码 |
| b | 均值1070／最小1046／最大1092／极差46 counts（极差/均值约4.30%） | 正计数5圈+5294样本与前进负计数重做−5293量级接近；旧样本转向未明确标注 | 同上；采样flags0不证明整圈物理标记完全一致 | 当前前进重做候选1058.6 counts/轮圈，前进负、系数−1仅登记 |

## 连续5圈复核（主控最新回报）

主控说明“初始均为刚开始调试的初始状态，两轮均转五圈”；按已确认零起点计算。原图[05_five_turns_a_b.png](hand_turn/05_five_turns_a_b.png)同时显示a／b，四舍五入前结果如下。

| 通道／轮侧 | start | end／原十六进制 | 实际报告圈数 | 绝对总差÷圈数 | 状态 |
| --- | --- | --- | --- | --- | --- |
| a／左 | 0 | +5304／0x14B8 | 5 | 1060.8 counts/轮圈 | dt10ms、valid1、status0、flags0 |
| b／右 | 0 | +5294／0x14AE | 5 | 1058.8 counts/轮圈 | 同上 |

此前双轮5圈原图按当时状态保存：每侧只有一组数据，不据此宣称重复性误差已定量通过或单圈差异原因已查明。之后右b按前进方向重做及主控文字确认见下节，当前前进符号与独立性已明确；不取平均写成通用CPR、不追加同向圈数。

## 收尾与验收范围

最新右b前进重做：[06_b_forward_five_turns.png](hand_turn/06_b_forward_five_turns.png)，raw0xEB53=60243、total0xFFFFFFFFFFFFEB53=−5293；按上一轮5圈重做上下文为abs(−5293)/5=1058.6 counts/输出轮圈，status0／flags0／valid1／dt10ms。此前正计数5圈为1058.8，绝对换算相差0.2 counts/圈，仅数值对照、不自动等同已完成独立反向试验。左a前进+5304已由主控另行确认，左右前进系数现在都有明确依据。

- 驱动OFF、XT30拔开、DAPLink断开：待确认；本轮不重新接动力后试转。
- 软件交付：见独立软件证据；每侧3次手转截图已收到、各自零起点已确认；独立下载／全局字段未随图展示。左右、前进符号、左反向和手转独立性已获主控确认；初版CPR记录待00核对采用，计量精度／闭环未验。
- 无变化时记录版本、供电接法／未测项及pin_levels，不直接判编码器坏。
- 发现异常、丢窗、复位或另一轮意外变化，保留原始数据；不要删数据或换符号让结果“通过”。
- 尚不验收RPM、m/s、闭环、AB同时动力测试或地面运行。下一步由主控把本任务路径交00读取。

## 主控确认汇总与本轮交接

主控明确确认A此前+5304的5圈也为车辆前进方向，并确认单独左转只有a变化、单独右转只有b变化、左轮反向时a减小。手转采集、左右对应、前进符号及基本独立性已取得本轮依据；这些观察来自文字回报，不伪造额外截图或未提供的运行字段。

| 初版参数 | 左轮a | 右轮b |
| --- | --- | --- |
| 车辆前进原始符号 | 正 | 负 |
| 前进统一为正的应用系数 | +1 | −1 |
| 每输出轮圈计数（5圈估计） | 1060.8 counts | 1058.6 counts |
| 是否已写入固件 | 否 | 否 |

本轮不再要求重复转圈；由主控按教程驱动OFF、拔XT30及DAPLink收尾，并交00读取C-02C。收尾实际结果尚未回报，不能提前填“已断电”。软件和本轮手转标定可交接，不延伸为动力闭环、RPM、计量精度或整车验收通过。
