AgrumeStly/yeye/testing/2026-10-24_motor_continuous/scope_results.md

# MotorContinuous：第一轮无动力示波器结果表

状态：待现场，尚无示波器波形。准备日期：2026-10-24（北京时间）；实际测量日期／时间：待填。维护：主控／01准备，主控现场记录，主控／02归档。主控仅表示可去实验室查看仪器，未确认已取得仪器或完成测试。

操作依据：[无动力测量单](../../hardware_preparation/motor_scope_check.md)；版本沿用已由主控确认的MotorContinuous 0x020B1001，不要求重烧录或重复已完成的[板内启停快照](watch/README.md)。若现场更换主板／程序，另记实际变更。

## 仪器与现场条件

| 项目 | 实际记录 |
| --- | --- |
| 示波器品牌／型号 | 待填 |
| 操作／协助人员角色 | 待填 |
| 探头型号、物理倍率、补偿／校准端检查 | 待填 |
| CH1／CH2显示倍率、输入阻抗、耦合 | 待填 |
| 时间档、电压档、实际采样率、触发源／沿／阈值／模式 | 待填 |
| 两支地夹实际公共GND位置，实验室人员确认接地路径 | 待填 |
| 驱动OFF、XT30始终拔开、UC2／主板Type-C断开 | 待现场确认，不预填通过 |
| 主板仅DAPLink供电、两板原共地保留 | 待现场确认 |
| 测试是两通道同步或一通道顺序 | 待填 |
| KEY松开后采集、冻结示波器后KEY停止、结束断DAPLink | 待实际记录 |

## 原始测量

| 测点 | 频率／周期 | 正脉宽／正占空比 | 高／低电平 | 实际形状与图文件 |
| --- | --- | --- | --- | --- |
| CH1：PE9／E09（P1.15）对GND | 待测 | 待测 | 待测 | 待归档 |
| CH2：驱动AIN1对GND | 待测 | 待测 | 待测 | 待归档 |
| KEY停止后两点 | 不预填 | 不预填 | 待测 | 待归档 |

“频率”处填实际仪表／游标值，不复制测量单中的20kHz／50µs。图片保存完整坐标、通道及倍率；如无成功触发／可读波形，记录失败条件，不写成已证明无PWM。只做顺序采集时不填同步相位结论。

## 判读与后续

- 本轮是否完成无动力输入侧波形：待现场与原图确认。
- PE9到AIN1是否一致、异常边界：待测，不猜测。
- AO1／AO2、内部VM与带载试转：本轮不测，保持未验证。
- 现场是否始终未接动力、结束是否KEY停止并断主板电：待实际反馈。
- 下一步：取得波形后由01判读；没有证据不改功率／频率、不自行接电池或复测B／AB。

本表仅为准备文件，不是实测通过记录；没有新增编译、烧录或上传。
