AgrumeStly/yeye/testing/2026-10-20_motor_bench/watchdog_wait_halt.png

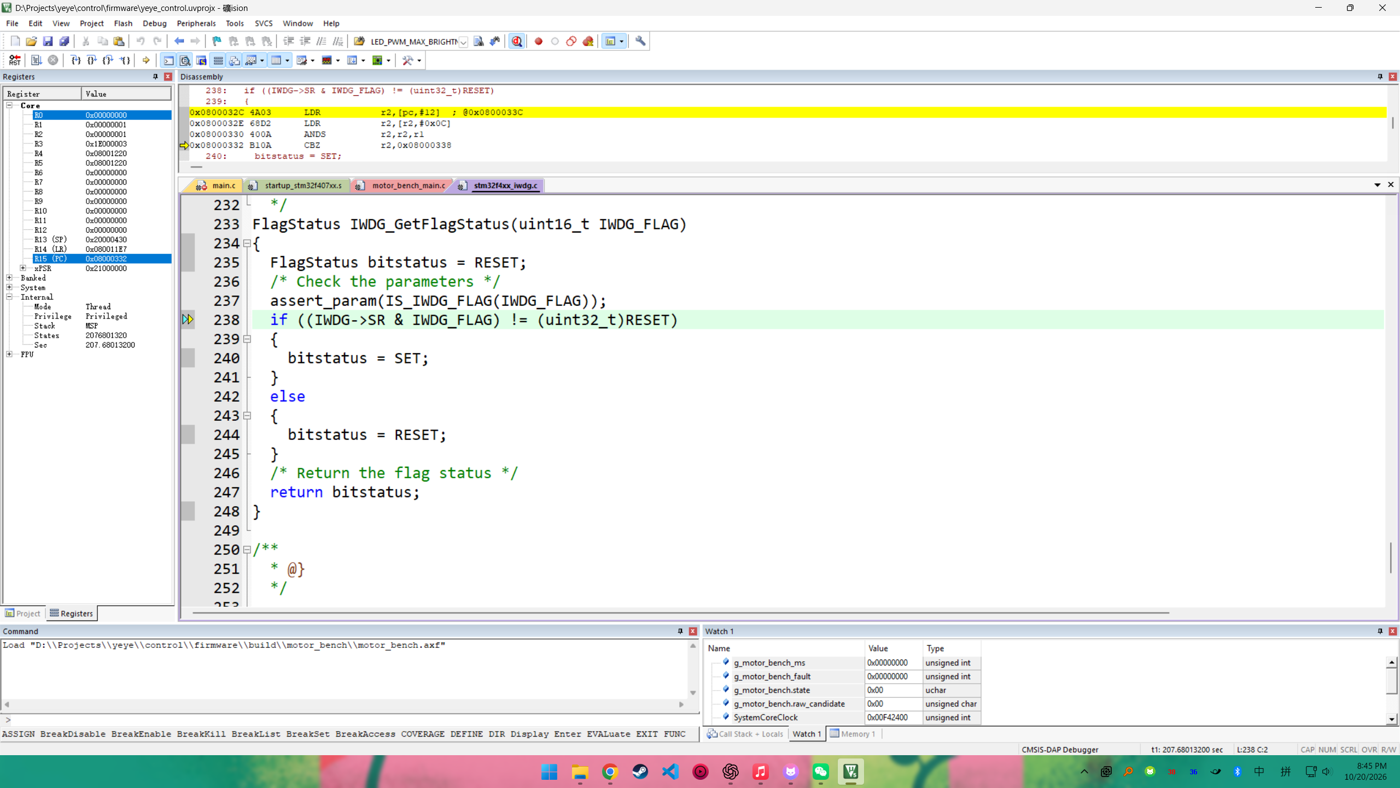
testing/2026-10-20_motor_bench/watchdog_wait_halt.png
