AgrumeStly/yeye/testing/2026-10-21_motor_bench/r3_watch/01_summary.png

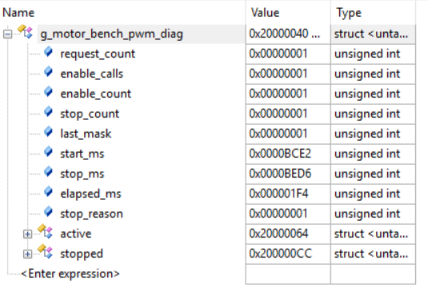
testing/2026-10-21_motor_bench/r3_watch/01_summary.png
