AgrumeStly/yeye/testing/2026-10-21_motor_bench/r3_watch/02_active.png

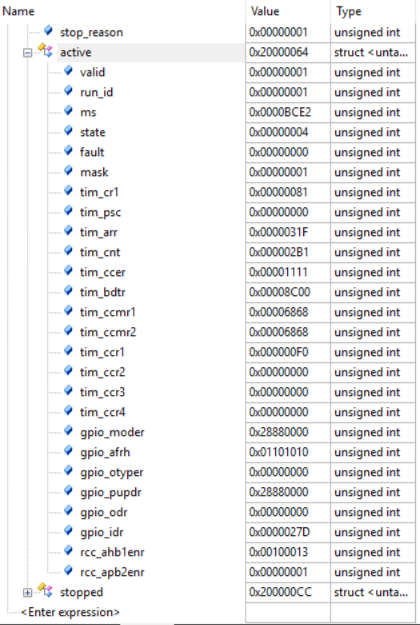
testing/2026-10-21_motor_bench/r3_watch/02_active.png
