AgrumeStly/yeye/testing/2026-10-24_motor_continuous/watch/01_before_request.png

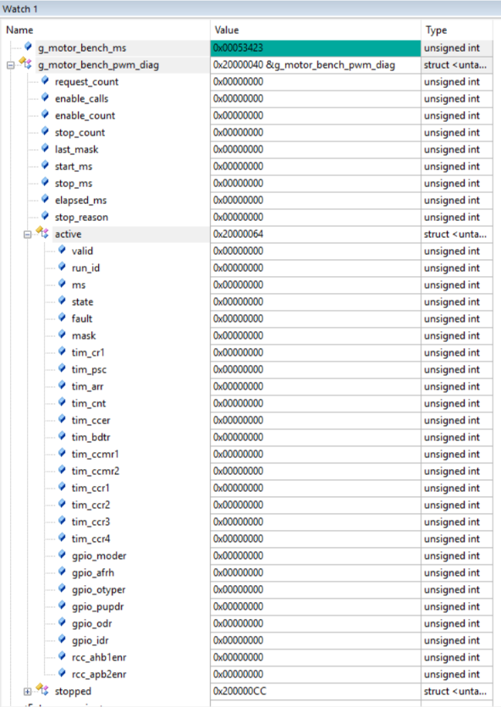
testing/2026-10-24_motor_continuous/watch/01_before_request.png
