AgrumeStly/yeye/testing/2026-10-24_motor_continuous/watch/03_stopped_key.png

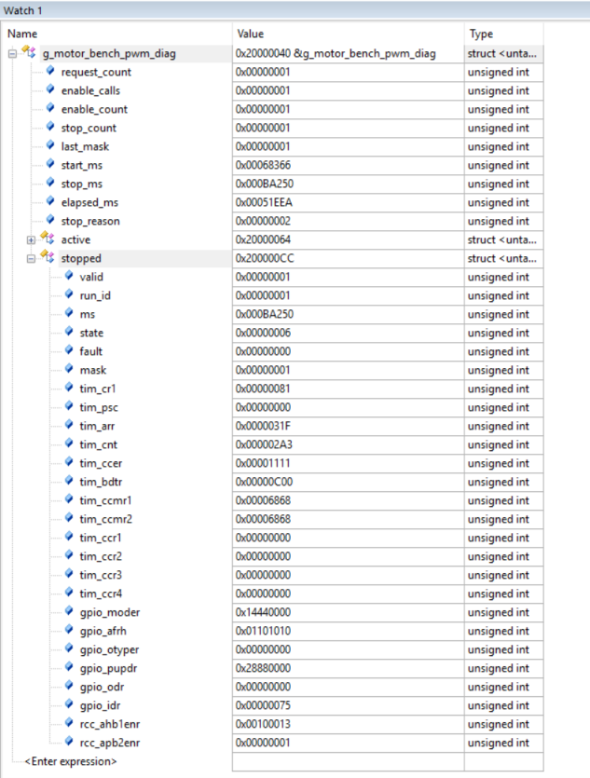
testing/2026-10-24_motor_continuous/watch/03_stopped_key.png
