AgrumeStly/yeye/testing/2026-10-25_encoder/hand_turn/01_left_a_one_turn.png

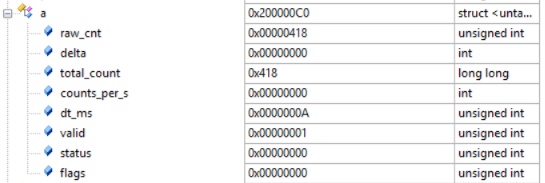
testing/2026-10-25_encoder/hand_turn/01_left_a_one_turn.png
