AgrumeStly/yeye/testing/2026-10-25_encoder/hand_turn/04_round3_a_b_one_turn.png

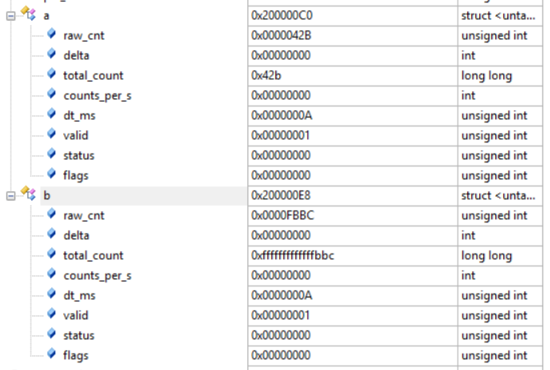
testing/2026-10-25_encoder/hand_turn/04_round3_a_b_one_turn.png
