AgrumeStly/yeye/testing/2026-10-25_encoder/hand_turn/06_b_forward_five_turns.png

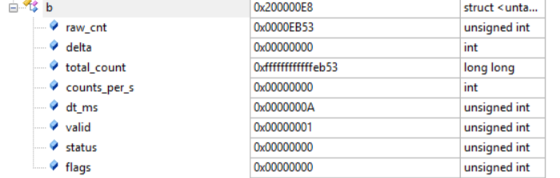
testing/2026-10-25_encoder/hand_turn/06_b_forward_five_turns.png
