AgrumeStly/yeye/hardware_preparation/size/3-亚克力底板孔位介绍.PDF

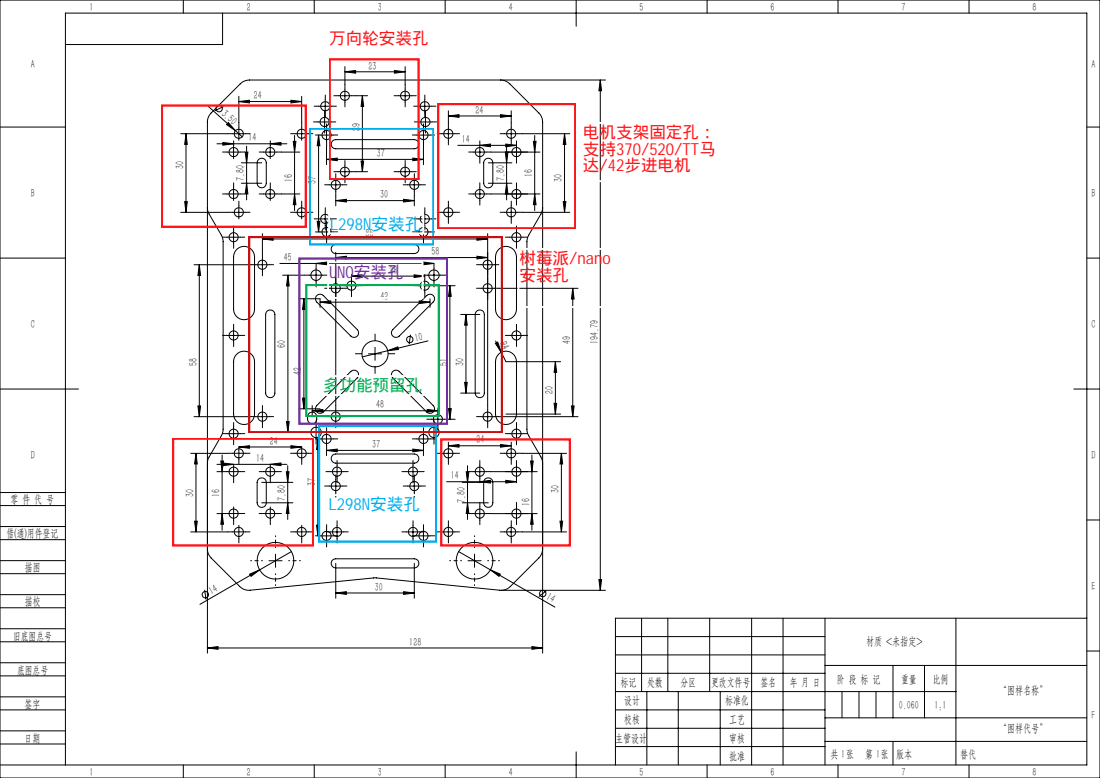
[picture p17: page 1]

材质 <未指定>

阶 段 标 记 | 重量 | 比例 | “图样名称”

标记 | 处数 | 分区 | 更改文件号 | 签名 | 年 月 日
设计 | | | 标准化 | | | | | 0.060 | 1:1
校核 | | | 工艺
主管设计 | | | 审核

“图样代号”
