AgrumeStly/yeye/control/Core/Src/speed_match_main.c

/** @file speed_match_main.c
 * @brief 双轮同速独立台架，复用原PWM、编码器采集及计数算法。
 * HSI16MHz、TIM1输出、TIM3/4编码器、TIM5启动限时、IWDG及KEY停止均保留。
 * 原逐轮校准500ms，成功后双轮同目标RPM；不连接UART或整车循迹状态机。
 */
#include "speed_match.h"
#include "encoder_hw.h"
#include "straight_pwm.h"
#include "stm32f4xx.h"

uint32_t SystemCoreClock = HSI_VALUE;
encoder_counter_t g_speed_encoder_a, g_speed_encoder_b;
volatile uint32_t g_speed_ms, g_speed_fault, g_speed_revision;
volatile uint32_t g_speed_watchdog_started, g_speed_watchdog_stage;
#define MOTOR_BENCH_FAULT_PWM_CLOCK 1u
#define MOTOR_BENCH_FAULT_STARTUP_TIMER 2u
#define MOTOR_BENCH_FAULT_LSI_TIMEOUT 4u
#define MOTOR_BENCH_FAULT_IWDG_TIMEOUT 8u
#define MOTOR_BENCH_FAULT_SYSTICK 16u
#define MOTOR_BENCH_FAULT_PWM_REQUEST 32u
#define STARTUP_WAIT_US 10000u
#define STARTUP_POLL_LIMIT 100000u
static uint8_t startup_timer_clocked;
static uint32_t last_sample_at;

/** @brief 启用HSI并复位时钟树；执行时应用尚未允许任何PWM请求。
 * 无参数/返回值。使用SPL设置时钟，CMSIS负责中断向量和FPU内核许可。
 * 冷启动HSI是芯片复位时钟；随后驱动层还会核对四路实际时钟均为16MHz。
 */
void SystemInit(void) {
    RCC_HSICmd(ENABLE);
    while (RCC_GetFlagStatus(RCC_FLAG_HSIRDY) == RESET) { }
    RCC_SYSCLKConfig(RCC_SYSCLKSource_HSI);
    while (RCC_GetSYSCLKSource() != 0u) { }
    RCC_DeInit();
    NVIC_SetVectorTable(NVIC_VectTab_FLASH, 0u);
    SCB->CPACR |= 0x00f00000u;
}

/** @brief 读取RCC实际配置并更新Hz单位的内核时钟变量；不假定外部晶振存在。 */
void SystemCoreClockUpdate(void) {
    RCC_ClocksTypeDef clocks;
    RCC_GetClocksFreq(&clocks);
    SystemCoreClock = clocks.SYSCLK_Frequency;
}

/** @brief KEY为PA0/WKUP输入下拉，PB2绿灯先灭再配置输出；不影响SWD。 */
static void controls_init(void) {
    GPIO_InitTypeDef config;
    RCC_AHB1PeriphClockCmd(RCC_AHB1Periph_GPIOA | RCC_AHB1Periph_GPIOB, ENABLE);
    GPIO_StructInit(&config);
    config.GPIO_Pin = GPIO_Pin_0;
    config.GPIO_Mode = GPIO_Mode_IN;
    config.GPIO_PuPd = GPIO_PuPd_DOWN;
    GPIO_Init(GPIOA, &config);
    GPIO_ResetBits(GPIOB, GPIO_Pin_2);
    config.GPIO_Pin = GPIO_Pin_2;
    config.GPIO_Mode = GPIO_Mode_OUT;
    config.GPIO_OType = GPIO_OType_PP;
    config.GPIO_PuPd = GPIO_PuPd_NOPULL;
    config.GPIO_Speed = GPIO_Speed_2MHz;
    GPIO_Init(GPIOB, &config);
}

/** @brief 建立独立TIM5启动时基，1计数=1us；不使用其中断或GPIO。
 * @return 1=16MHz APB1且CNT实际递增，0=不支持的时钟/停滞。
 * 首次检查也有1024次上限，防止为了建立超时机制而无限等待。
 */
static int startup_timer_init(void) {
    RCC_ClocksTypeDef clocks;
    TIM_TimeBaseInitTypeDef base;
    uint32_t first, attempt;
    RCC_GetClocksFreq(&clocks);
    if (clocks.HCLK_Frequency != 16000000u || clocks.PCLK1_Frequency != 16000000u) return 0;
    RCC_APB1PeriphClockCmd(RCC_APB1Periph_TIM5, ENABLE);
    startup_timer_clocked = 1u;
    TIM_DeInit(TIM5);
    TIM_TimeBaseStructInit(&base);
    base.TIM_Prescaler = 15u;
    base.TIM_Period = 0xffffffffu;
    base.TIM_CounterMode = TIM_CounterMode_Up;
    base.TIM_ClockDivision = TIM_CKD_DIV1;
    TIM_TimeBaseInit(TIM5, &base);
    TIM_GenerateEvent(TIM5, TIM_EventSource_Update);
    TIM_Cmd(TIM5, ENABLE);
    first = TIM_GetCounter(TIM5);
    for (attempt = 0u; attempt < 1024u; ++attempt)
        if (TIM_GetCounter(TIM5) != first) return 1;
    return 0;
}

/** @brief 启动等待限时判断；started单位us，polls为次数，fault为超时原因。
 * @return 0=仍可等待，非零=锁存故障。无符号差支持计数回绕。
 * 10ms硬件超时与次数上限同时使用，TIM5意外停滞也能退出。
 */
static uint32_t startup_wait_fault(uint32_t started, uint32_t *polls, uint32_t fault) {
    if ((uint32_t)(TIM_GetCounter(TIM5) - started) >= STARTUP_WAIT_US) return fault;
    ++*polls;
    return *polls >= STARTUP_POLL_LIMIT ? MOTOR_BENCH_FAULT_STARTUP_TIMER : 0u;
}

/** @brief 启动IWDG并有限等待寄存器更新，约250ms为LSI名义值。
 * @return 0=就绪，其它为故障位。所有退出路径停止TIM5，失败保持零输出。
 * 先使能IWDG，再写PR/RLR并等待PVU/RVU；不能在尚未启动时无限等更新位。
 * 已启动的IWDG不能软件关闭；故障时滴答可喂狗保留灯态，CPU停滞则硬件复位。
 */
static uint32_t watchdog_init(void) {
    uint32_t started, polls = 0u, fault = 0u;
    if (!startup_timer_init()) { fault = MOTOR_BENCH_FAULT_STARTUP_TIMER; goto done; }
    g_speed_watchdog_stage = 1u;
    RCC_LSICmd(ENABLE);
    started = TIM_GetCounter(TIM5);
    while (RCC_GetFlagStatus(RCC_FLAG_LSIRDY) == RESET) {
        fault = startup_wait_fault(started, &polls, MOTOR_BENCH_FAULT_LSI_TIMEOUT);
        if (fault != 0u) goto done;
    }
    g_speed_watchdog_stage = 2u;
    IWDG_Enable();
    g_speed_watchdog_started = 1u;
    g_speed_watchdog_stage = 3u;
    IWDG_WriteAccessCmd(IWDG_WriteAccess_Enable);
    IWDG_SetPrescaler(IWDG_Prescaler_32);
    IWDG_SetReload(249u);
    started = TIM_GetCounter(TIM5);
    polls = 0u;
    while (IWDG_GetFlagStatus(IWDG_FLAG_PVU) != RESET || IWDG_GetFlagStatus(IWDG_FLAG_RVU) != RESET) {
        fault = startup_wait_fault(started, &polls, MOTOR_BENCH_FAULT_IWDG_TIMEOUT);
        if (fault != 0u) goto done;
    }
    IWDG_ReloadCounter();
    g_speed_watchdog_stage = 4u;
done:
    if (startup_timer_clocked != 0u) TIM_Cmd(TIM5, DISABLE);
    if (fault != 0u) straight_pwm_stop();
    return fault;
}

/** @brief 每1ms监督停止，每20ms复用原采集／回绕算法并计算轮速。
 * 先采样再进行按键／时限监督，最后应用输出与喂狗；整个中断不阻塞。
 * 原始a/b数据供校准和Watch，控制层自行保存识别后的物理左右映射。
 */
void SysTick_Handler(void) {
    uint32_t now = ++g_speed_ms;
    if (g_speed_fault == 0u) {
        if ((uint32_t)(now - last_sample_at) >= SPEED_MATCH_SAMPLE_MS) {
            encoder_raw_t raw;
            last_sample_at = now;
            if (!encoder_hw_read(&raw)) g_speed_fault |= 64u;
            else {
                encoder_counter_update(&g_speed_encoder_a, raw.a, now);
                encoder_counter_update(&g_speed_encoder_b, raw.b, now);
                speed_match_sample(now, &g_speed_encoder_a.sample, &g_speed_encoder_b.sample);
            }
        }
        speed_match_tick(now, GPIO_ReadInputDataBit(GPIOA, GPIO_Pin_0));
        if (!straight_pwm_apply(g_speed_match.left_pwm, g_speed_match.right_pwm))
            g_speed_fault |= MOTOR_BENCH_FAULT_PWM_REQUEST;
    }
    if (g_speed_fault != 0u) {
        speed_match_fault(SPEED_ERROR_HARDWARE, now);
        straight_pwm_stop();
    }
    GPIO_WriteBit(GPIOB, GPIO_Pin_2, speed_match_led(now) != 0u ? Bit_SET : Bit_RESET);
    if (g_speed_watchdog_started != 0u) IWDG_ReloadCounter();
}

/** @brief CPU异常先撤四脚驱动再等待IWDG，绝不从异常返回继续试转。 */
static void fatal_stop(void) {
    __disable_irq();
    straight_pwm_stop();
    for (;;) { }
}
void NMI_Handler(void) { fatal_stop(); }
void HardFault_Handler(void) { fatal_stop(); }
void MemManage_Handler(void) { fatal_stop(); }
void BusFault_Handler(void) { fatal_stop(); }
void UsageFault_Handler(void) { fatal_stop(); }

/** @brief 先撤PWM，再初始化编码器／状态与启动监督；默认只读采集，不自启。 */
int main(void) {
    g_speed_revision = 0x020f0001u;
    g_speed_fault = straight_pwm_init() ? 0u : MOTOR_BENCH_FAULT_PWM_CLOCK;
    if (!encoder_hw_init()) g_speed_fault |= 64u;
    controls_init();
    SystemCoreClockUpdate();
    encoder_counter_init(&g_speed_encoder_a);
    encoder_counter_init(&g_speed_encoder_b);
    speed_match_init(0u);
    g_speed_fault |= watchdog_init();
    if (g_speed_fault != 0u) speed_match_fault(SPEED_ERROR_HARDWARE, 0u);
    if (SysTick_Config(SystemCoreClock / 1000u) != 0u) {
        g_speed_fault |= MOTOR_BENCH_FAULT_SYSTICK;
        fatal_stop();
    }
    NVIC_SetPriority(SysTick_IRQn, 0u);
    for (;;) __WFI();
}
