AgrumeStly/yeye/(commit log)

2026-10-11 Initialize smart car project with code references and project documents
    [图像.xlsx]
2026-10-12 refactor(control): use STM32F4 standard peripheral library
2026-10-14 feat(control): add board self-test and project directory guide
2026-10-18 docs: record G-01 upload evidence and device handoff
2026-10-25 feat: save current firmware, hardware evidence and project organization
    G-03: include layered SPL control projects, diagnostic tests and records, ORG-01/ORG-02 documents, portable project skill discovery and laptop Codex handoff.
2026-10-30 feat: save encoder validation, wheel mapping and laptop handoff
    G-05: upload current project sources and evidence, competition and chassis documents, task updates and October 30 device handoff. Preserve original test logs and formal snapshot tag.
